sinara-hw/Urukul/README.md

# Urukul

4 channel 1GS/s DDS (AD9910 or AD9912 variant).

## Design Files

Design files (schematics, PCB layouts, BOMs) can be found at [Urukul/Releases](https://github.com/sinara-hw/Urukul/releases).

## Wiki

More information can be found on the [wiki](https://github.com/sinara-hw/Urukul/wiki).
