sinara-hw/Urukul/(threads)

Thread 1 (2018-04-19):

SYSU error with internal clock

jbqubit, 2018-04-19:
I'm running the SYSU Kasli variant with EEMs TTL and Urukul. Running gateware and firmware version d0f6123f. Relying on internal Kasli internal clock I get an error.

```
device_db = {
    "core": {
        "type": "local",
        "module": "artiq.coredevice.core",
        "class": "Core",
        "arguments": {
            "host": core_addr,
            "ref_period": 1e-9
            #,"external_clock": True
            # ,"ref_multiplier": 4
        }
    },
...
    urukul0_cpld={
        "type": "local",
        "module": "artiq.coredevice.urukul",
        "class": "CPLD",
        "arguments": {
            "spi_device": "spi_urukul0",
            "io_update_device": "ttl_urukul0_io_update"
            ,"refclk": 125e6
            ,"clk_sel": 0
        }
    }
```

```
$ artiq_run repository/demo.py
/home/britton/miniconda3/envs/artiq-dev/lib/python3.5/site-packages/h5py/__init__.py:36: FutureWarning: Conversion of the second argument of issubdtype from `float` to `np.floating` is deprecated. In future, it will be treated as `np.float64 == np.dtype(float).type`.
  from ._conv import register_converters as _register_converters
Traceback (most recent call last):
  File "/home/britton/artiq-dev/artiq/artiq/master/worker_db.py", line 159, in get
    dev = _create_device(desc, self)
  File "/home/britton/artiq-dev/artiq/artiq/master/worker_db.py", line 97, in _create_device
    return device_class(device_mgr, **desc.get("arguments", {}))
  File "/home/britton/artiq-dev/artiq/artiq/coredevice/ad9910.py", line 69, in __init__
    assert sysclk <= 1e9
AssertionError

The above exception was the direct cause of the following exception:

Traceback (most recent call last):
  File "/home/britton/miniconda3/envs/artiq-dev/bin/artiq_run", line 11, in <module>
    load_entry_point('artiq', 'console_scripts', 'artiq_run')()
  File "/home/britton/artiq-dev/artiq/artiq/frontend/artiq_run.py", line 219, in main
    return run(with_file=True)
  File "/home/britton/artiq-dev/artiq/artiq/frontend/artiq_run.py", line 205, in run
    raise exn
  File "/home/britton/artiq-dev/artiq/artiq/frontend/artiq_run.py", line 196, in run
    exp_inst = _build_experiment(device_mgr, dataset_mgr, args)
  File "/home/britton/artiq-dev/artiq/artiq/frontend/artiq_run.py", line 182, in _build_experiment
    return get_experiment(module, args.experiment)(managers)
  File "/home/britton/artiq-dev/artiq/artiq/language/environment.py", line 216, in __init__
    self.build(*args, **kwargs)
  File "repository/demo.py", line 8, in build
    self.urukul0s = [self.get_device("urukul0_ch"+str(i)) for i in range(4)]
  File "repository/demo.py", line 8, in <listcomp>
    self.urukul0s = [self.get_device("urukul0_ch"+str(i)) for i in range(4)]
  File "/home/britton/artiq-dev/artiq/artiq/language/environment.py", line 276, in get_device
    return self.__device_mgr.get(key)
  File "/home/britton/artiq-dev/artiq/artiq/master/worker_db.py", line 162, in get
    .format(name)) from e
artiq.master.worker_db.DeviceError: Failed to create device 'urukul0_ch0'
```

jbqubit, 2018-04-19:
```
from artiq.experiment import *

class UrukulTest(EnvExperiment):
    def build(self):
        self.setattr_device("core")
        self.setattr_device("urukul0_cpld")
        self.urukul0s = [self.get_device("urukul0_ch"+str(i)) for i in range(4)]
        self.ttl = self.get_device("ttl0")

    @kernel
    def run(self):
        f = 3.0*MHz
        dt = 2*us

        self.core.reset()
        self.ttl.output()
        delay(1*ms)

        for j in range(4):
            self.urukul0s[j].init()

        while True:
            with parallel:
                self.urukul0s[0].set(f, 0., 1.)
                self.urukul0s[1].set(f, 0., 1.)
                self.ttl.pulse(dt)
                self.urukul0s[0].sw.pulse(dt)
                self.urukul0s[1].sw.pulse(dt)

                # for j in range(4):
                #     self.urukul0s[j].sw.pulse(2*us)
            delay(1*ms)
```

hartytp, 2018-07-30:
@jbqubit AFAICT, this is an ARTIQ issue, not a HW issue.

Closed 2018-07-30.

Thread 2 (2018-06-08):

Remove AD9914 variant

marmeladapk, 2018-06-08:
AD9914 seems to not be considered anymore (https://github.com/sinara-hw/sinara/issues/195#issuecomment-304321715) and is not present in the schematics.

gkasprow, 2018-06-08:
done

Closed 2018-06-08.

Thread 3 (2018-06-13):

Urukul v1.0 detailed testing

marmeladapk, 2018-06-13:
_From @hartytp on [2017-11-07 20:29](https://github.com/sinara-hw/sinara/issues/354)_

- [x] Channel-to-channel cross-talk: adjacent channels, with agressor, victim switches opened and switches closed and with attenuators at max/min
- [x] Output phase noise/amplitude noise (0.1 Hz - 10 MHz)
- [x] OIP3, OIP2 vs frequency for min attenuator setting and medium/large amplitude (ASF)
- [x] RF switch settling behavior for on edge at max power (worst case)
- [x] Attenuator glitches
- [x] Nyquist attenuation, clock leakage
- [ ] RF switch settling behavior for off edge at max power (worst case)
- [ ] RF switch phase chirp
- [ ] Temperature coefficient of power and phase
- [ ] Are we happy running the IC11 and running the LVDS interface directly from the 3V6 rail? (Try this and check performance)
- [ ] Check performance of clock buffers when running in LVDS mode from the 1V8A rail
- [x] Optimize PLL loop filters (@weidazhang can you do this for the AD9910 boards, please?)
- [ ] Board-to-board crosstalk (in proximity to Kasli, DIO pulsing 5 V into 50 R, Urukul)

Use some fixed reference frequency for all tests, such as 80MHz.

marmeladapk, 2018-06-13:
_From @hartytp on [2017-11-07 20:30](https://github.com/sinara-hw/sinara/issues/354#issuecomment-342612378)_

@gkasprow Can you ship us all but 1 of the AD9910 Urukul prototypes you've ordered as soon as basic functionality/"no smoke" testing is complete (i.e. don't complete the above detailed testing first!).

Thanks!

marmeladapk, 2018-06-13:
_From @hartytp on [2017-11-07 20:30](https://github.com/sinara-hw/sinara/issues/354#issuecomment-342612519)_

@gkasprow @jordens Feel free to add more tests to the above list.

marmeladapk, 2018-06-13:
_From @hartytp on [2017-11-08 03:32](https://github.com/sinara-hw/sinara/issues/354#issuecomment-342700395)_

@gkasprow When you ship the AD9910 DDSs that we paid for, please can you ship one to @jordens?

marmeladapk, 2018-06-13:
_From @jordens on [2017-11-08 08:47](https://github.com/sinara-hw/sinara/issues/354#issuecomment-342750073)_

Updated it a bit. Please ship right after smoke test:

- [ ] power supplies good
- [ ] clock fanout fans out
- [ ] dds pll locks
- [ ] dds outputs frequency
- [ ] attenuators can be set
- [ ] rf switches work

We'll be happy to help with characterization afterwards.

marmeladapk, 2018-06-13:
_From @hartytp on [2017-11-12 18:22](https://github.com/sinara-hw/sinara/issues/354#issuecomment-343756425)_

@gkasprow Is Urukul due to arrive this week? When it arrives, please can we prioritise no smoke/basic functionality testing (see reobert's list) above finishing Zotino -- I'd like to get Urukul prototypes shipped asap. No need to do the detailed testing for now.

Thanks!

marmeladapk, 2018-06-13:
_From @gkasprow on [2017-11-12 18:26](https://github.com/sinara-hw/sinara/issues/354#issuecomment-343756709)_

@hartytp OK, 2 Zotinos + BNC adapters were shipped on Friday. Once I receive DDS, I will test them ASAP.

marmeladapk, 2018-06-13:
_From @hartytp on [2017-11-12 18:27](https://github.com/sinara-hw/sinara/issues/354#issuecomment-343756742)_

Thanks!

marmeladapk, 2018-06-13:
_From @gkasprow on [2017-11-12 18:32](https://github.com/sinara-hw/sinara/issues/354#issuecomment-343757125)_

@hartytp There are no panels for DAC BNC adapters attached - I forgotten about them. Will ship them next time with some other stuff.

marmeladapk, 2018-06-13:
_From @hartytp on [2017-11-12 18:43](https://github.com/sinara-hw/sinara/issues/354#issuecomment-343757823)_

@gkasprow No problem. That can wait.

If there is any time before Urukul arrives, it'd be great to get a few of the analog test for Zotino done.

marmeladapk, 2018-06-13:
_From @gkasprow on [2017-11-12 19:04](https://github.com/sinara-hw/sinara/issues/354#issuecomment-343759155)_

@hartytp Sure, once I repair my bard, will continue with measurements.

marmeladapk, 2018-06-13:
_From @hartytp on [2017-11-12 19:23](https://github.com/sinara-hw/sinara/issues/354#issuecomment-343760366)_

Great, thanks @gkasprow!

marmeladapk, 2018-06-13:
_From @jordens on [2017-11-19 16:38](https://github.com/sinara-hw/sinara/issues/354#issuecomment-345530298)_

@hartytp could you remember to do a bit of triage on the issues you file (i.e. assignee, labels, milestone)?

marmeladapk, 2018-06-13:
_From @hartytp on [2017-11-19 18:48](https://github.com/sinara-hw/sinara/issues/354#issuecomment-345539884)_

sure

marmeladapk, 2018-06-13:
_From @hartytp on [2017-11-20 18:55](https://github.com/sinara-hw/sinara/issues/354#issuecomment-345792391)_

@gkasprow For the current source biasing, my inclination is to go for Daniel's suggestion of the LT3092. They're pretty cheap ($2 in quantity) and seem like a better/easier solution than building our own current source.

@jordens @gkasprow if you're oaky with this approach, then we should buy an eval board at some point and test this out with the v1.0 boards we have. I'm happy to do this testing if that helps -- I probably won't do this until after Christmas, but I don't think we're in a rush for it.

marmeladapk, 2018-06-13:
_From @hartytp on [2017-12-11 18:26](https://github.com/sinara-hw/sinara/issues/354#issuecomment-350813087)_

Cool.

Out of curiosity, do you have a proper phase noise/amplitude noise meter? Or, will you just stick this on a spectrum analyser?

marmeladapk, 2018-06-13:
_From @jordens on [2017-12-11 19:16](https://github.com/sinara-hw/sinara/issues/354#issuecomment-350827749)_

We have proper tools.

@gkasprow how are the AD9912 variant boards?

marmeladapk, 2018-06-13:
_From @gkasprow on [2017-12-11 21:11](https://github.com/sinara-hw/sinara/issues/354#issuecomment-350859436)_

@jordens I have them all in my lab but was busy with Sayma Ethernet debugging. You can follow my fight [here](https://github.com/m-labs/artiq/issues/854)

marmeladapk, 2018-06-13:
_From @gkasprow on [2017-12-11 21:12](https://github.com/sinara-hw/sinara/issues/354#issuecomment-350859672)_

So the next thing is 9912 testing.

marmeladapk, 2018-06-13:
_From @jordens on [2017-12-11 22:32](https://github.com/sinara-hw/sinara/issues/354#issuecomment-350880532)_

I am following that and involved.
Thanks for the AD9912 update. Once you have smoke-tested them like the AD9910 stuff, you can send two of them to me.

marmeladapk, 2018-06-13:
_From @a-shafir on [2017-12-11 22:45](https://github.com/sinara-hw/sinara/issues/354#issuecomment-350883486)_

@gkasprow what was actually flashed into the CPLD on the 9910 board we have in Berlin?

I see 2 options
https://github.com/m-labs/sinara/tree/master/ARTIQ_ALTIUM/EEMs/Urukul/CPLD_code
or
https://github.com/quartiq/urukul

I am testing h/w but can't generate any output on the IO_SESET (P129) and some pins around.

marmeladapk, 2018-06-13:
_From @a-shafir on [2017-12-11 23:02](https://github.com/sinara-hw/sinara/issues/354#issuecomment-350887345)_

@gkasprow how you tested 3U DDS 9910?
Have you got DDS ic working?
Do you have the code that sent the spi commands, what actually sent to DDS/atten etc?

marmeladapk, 2018-06-13:
_From @gkasprow on [2017-12-11 23:02](https://github.com/sinara-hw/sinara/issues/354#issuecomment-350887492)_

@a-shafir I burned Roberts Verilog code. The only change I did was assignment of test points. Now we have:
```
assign tp = (cfg_data_rst | ((~en_9910) & tstriple7_i));
assign tp_1 = dds_cs_n;
assign tp_2 = dds_sck;
assign tp_3 = dds_sdi;
assign tp_4 = dds_io_update;

```

marmeladapk, 2018-06-13:
_From @gkasprow on [2017-12-11 23:05](https://github.com/sinara-hw/sinara/issues/354#issuecomment-350888034)_

I connected 9910 devkit via DIO-Tester module to make sure that Robert's code works. In this way I could communicate with it using LVTTL signals

marmeladapk, 2018-06-13:
_From @gkasprow on [2017-12-11 23:06](https://github.com/sinara-hw/sinara/issues/354#issuecomment-350888356)_

I also modified the verilog code so all 4 channels were active simultaneously. In this way I tested if PLLs are locked. Here is the code:
[Urukul_CPLD_all_ch.zip](https://github.com/m-labs/sinara/files/1549674/Urukul_CPLD_all_ch.zip)

marmeladapk, 2018-06-13:
_From @gkasprow on [2017-12-11 23:08](https://github.com/sinara-hw/sinara/issues/354#issuecomment-350888731)_

To do general purpose communication over SPI I use little Artix 7 devkit with USB and FORTH processor that translates UART commands to bit-bang protocol, i.e. SPI. It works really fast but it's written in FORTH, so probably not really useful for you :)

marmeladapk, 2018-06-13:
_From @a-shafir on [2017-12-11 23:13](https://github.com/sinara-hw/sinara/issues/354#issuecomment-350889724)_

@gkasprow i see io_reset commented in the code. probably some other changes.
Please also attach the pin assignment for the code.
So what was generating the DDS SPI command? 9910 devkit? I have no devkit.
Can you generate a dump (sequence) of the commands?
Also what about the reading from DDS when all in parallel?

marmeladapk, 2018-06-13:
_From @a-shafir on [2017-12-11 23:15](https://github.com/sinara-hw/sinara/issues/354#issuecomment-350890259)_

@gkasprow i see why in_sel not working to - it commented out
Good that i got this data from you )

marmeladapk, 2018-06-13:
_From @gkasprow on [2017-12-11 23:19](https://github.com/sinara-hw/sinara/issues/354#issuecomment-350890994)_

The original DDS was working in parallel. So I didn't read the status from externally connected ones.
You can compare this code with one @jordens posted. I did not touch the pins assignment.
My CPLD project is [here](https://www.dropbox.com/sh/qj16dhavo4qxsw9/AAB5paEl0olZpSaRMjhjxSyOa?dl=0)

marmeladapk, 2018-06-13:
_From @gkasprow on [2017-12-11 23:21](https://github.com/sinara-hw/sinara/issues/354#issuecomment-350891401)_

This is how typical setup with devkit looks like. I this case I connected Sampler module, but the idea is same.
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

marmeladapk, 2018-06-13:
_From @gkasprow on [2017-12-11 23:24](https://github.com/sinara-hw/sinara/issues/354#issuecomment-350892153)_

this is the FORTH code I use to talk to LV595 registers.
The FORTH ascii is executed in FPGA and is toggling IOs routed to an IO register with a few MHz rate. CPU runs with 50MHz clock.
The function below writes 16 bits via SPI to the register and reads them back.

````
: spi_LV595 ( a )

	1 OUT0_SET_REG io! \ SCK hi
	1 16 lshift OUT0_SET_REG io! \ OE buff active
	1 2 lshift OUT0_CLR_REG io! \ RCLK low

    16 0 do
        dup
        1 15 lshift and
        if
           1 1 lshift OUT0_SET_REG io!
        else
           1 1 lshift OUT0_CLR_REG io!
        then
		1 OUT0_CLR_REG io! \ SCK low
		2*
		INP0_REG io@ 4 rshift 1 and +
        1 OUT0_SET_REG io! \ SCK hi
    loop

	 1 2 lshift OUT0_SET_REG io! \ RCLK high
	 1 2 lshift OUT0_CLR_REG io! \ RCLK low
	 1 16 lshift OUT0_CLR_REG io! \ OE buff inactive
	 $ffffff and  \ return only valid bits
;

````

marmeladapk, 2018-06-13:
_From @gkasprow on [2017-12-11 23:32](https://github.com/sinara-hw/sinara/issues/354#issuecomment-350893612)_

@a-shafir you are right - I had to modify the reset pin state to make it working.

marmeladapk, 2018-06-13:
_From @gkasprow on [2017-12-11 23:34](https://github.com/sinara-hw/sinara/issues/354#issuecomment-350894149)_

And the code you have burned in your CPLD is in Urukul_CPLD_1ch.v file

marmeladapk, 2018-06-13:
_From @gkasprow on [2017-12-12 16:51](https://github.com/sinara-hw/sinara/issues/354#issuecomment-351112532)_

@jordens here is your 9912 :)
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

marmeladapk, 2018-06-13:
_From @jordens on [2017-12-12 16:56](https://github.com/sinara-hw/sinara/issues/354#issuecomment-351114267)_

@gkasprow Nice! Other than the missing amplifier, are there any other issues? Is the solder on the underside bad as well?

marmeladapk, 2018-06-13:
_From @hartytp on [2017-12-12 16:59](https://github.com/sinara-hw/sinara/issues/354#issuecomment-351115163)_

Nice!

marmeladapk, 2018-06-13:
_From @gkasprow on [2017-12-12 17:03](https://github.com/sinara-hw/sinara/issues/354#issuecomment-351116459)_

I got this amp separately. The PN is wrong so they got ones with straight leads and had to replace them.
It seems that the ICs they got had problems with wetting because other chips are fine. Anyway, it's their responsibility to solder it right

marmeladapk, 2018-06-13:
_From @jordens on [2017-12-12 17:15](https://github.com/sinara-hw/sinara/issues/354#issuecomment-351120206)_

Are you returning the AD9912 boards to Technosystem to be fixed as well?

marmeladapk, 2018-06-13:
_From @gkasprow on [2017-12-12 18:06](https://github.com/sinara-hw/sinara/issues/354#issuecomment-351135089)_

I will fix one piece myself to test it. Rest of the boards will be returned. I talked with the company and they say that it is quite standard thing that some chips have poor wetting and side contacts are not always covered by the tin. The flux that is part of the soldering paste is only roughly 10..15% of it and is not always able to clean the contact side. The joint still maintains the contact because it is low side of it which does the job. Side area does not need to be covered, but if we want, they can fix it.

marmeladapk, 2018-06-13:
_From @jordens on [2017-12-13 08:47](https://github.com/sinara-hw/sinara/issues/354#issuecomment-351323416)_

IMHO it is likely that the joints are bad on the underside as well if they fail to wet that dramatically on the edge. And since they probably didn't inspect those joints there is no telling. I'd like to see them fix it.

marmeladapk, 2018-06-13:
_From @gkasprow on [2017-12-13 09:09](https://github.com/sinara-hw/sinara/issues/354#issuecomment-351328847)_

I just desoldered the chip and the bottom pads are correctly soldered. Anyway it just looks non professional and should be fixed.

marmeladapk, 2018-06-13:
_From @a-shafir on [2017-12-13 10:42](https://github.com/sinara-hw/sinara/issues/354#issuecomment-351353248)_

This is a long known for the technologists that too much solder is not helping and even can cover some problem. But in this case it is not about the professionalism but about Optical inspection standards. All the packages designed that way that there is possibility to ensure by inspection the proper electrically and mechanically soldering. For this package there must be wetting on the side edges of the pads. This indicates that there is wetting under the pads and also improves mechanical properties.

For some of the packages we have (BGA and some of the qfn with signal pads under) the OIS will not enough. I think need to check if the factory can do x-ray inspection, they must have it in or out house at least for BGA but also for some regulator chips etc. Visual inspection of the QFN etc is the must. It shall not increase the cost of the samples production more than few %

Any way investing our time to solving the technological issues is the worst case scenario.

marmeladapk, 2018-06-13:
_From @a-shafir on [2017-12-13 12:50](https://github.com/sinara-hw/sinara/issues/354#issuecomment-351381968)_

Urukul 9910, 4th channel, 10.000MHz, variable attenuation test, no termination:
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

marmeladapk, 2018-06-13:
_From @gkasprow on [2017-12-13 13:29](https://github.com/sinara-hw/sinara/issues/354#issuecomment-351391245)_

@a-shafir look [here](https://github.com/m-labs/sinara/issues/377#issuecomment-351379129)

marmeladapk, 2018-06-13:
_From @a-shafir on [2017-12-13 13:40](https://github.com/sinara-hw/sinara/issues/354#issuecomment-351393954)_

@gkasprow ok, this is a news for me too. There are 3 similar looking "QFN-style" packages:
- one have sides plated to be good for wetting (some crystals for instance and old stile QFN)
- some have a etch/step around to have the wetting visible for OIS
- the newest are basicly BGA-like i.e. all wetting is under the package but just no balls.

That minds for us:
- Even we don't have a BGA on a board we need to inspect the packages to ensure they are good for optical inspection (OIS) and if any one of them is needed we must add X-ray inspection into the production list.
- Need to chose the parts for the boards more careful. If the board normally (most of the parts) does not needs X-ray try to avoid any packages that have no OIS compatible pads (like LTM4622 etc)
- It is good to put this as a part of the h/w and production specs checklist.

marmeladapk, 2018-06-13:
_From @a-shafir on [2017-12-18 00:41](https://github.com/sinara-hw/sinara/issues/354#issuecomment-352299689)_

Gateware, core drivers and experiment for Urukul AD9910 rev 1.0 board.

The current setup is for KC705, see the details here:
https://github.com/m-labs/artiq/commit/dd3c8a336dc12cda33cadebdf3bafc77c0bc1565

The experiment initializes FMC DIO, the Urukul board and configures the single tone for all 4 channels.
Attenuator and SW are supported.

There are 2 "interference generator loops" (for DDS3 SPI and for ATT SPI). Each can be activated in the experiment. Note: with the current RTIO gateware it is not possible to generate the NU-mode intensive SPI communication so if any interference from the SPI clock will be seen on the output it will be not the worst case scenario.

The 4-channels DDS output:
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

The setup:
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

marmeladapk, 2018-06-13:
_From @jordens on [2017-12-18 17:40](https://github.com/sinara-hw/sinara/issues/354#issuecomment-352500086)_

* RF Switch rise time is roughly 100ns to 95%
* Spectrum looks ok. A few weird close in Spurs (+- 1.2 kHz and 11kHz at -70dBc) potentially related to grounding to be debugged. They are big when the board is on the antistatic bag on an optical table and otherwise disappear.

More data and screenshots to follow.

marmeladapk, 2018-06-13:
_From @dhslichter on [2017-12-18 18:53](https://github.com/sinara-hw/sinara/issues/354#issuecomment-352523350)_

@a-shafir why are you using scope probes to look at the DDS outputs instead of SMA cables?

marmeladapk, 2018-06-13:
_From @gkasprow on [2017-12-18 19:01](https://github.com/sinara-hw/sinara/issues/354#issuecomment-352525555)_

@jordens in such setup you easily receive and induce current from every short wave radio station including CB :)

marmeladapk, 2018-06-13:
_From @jordens on [2017-12-18 19:57](https://github.com/sinara-hw/sinara/issues/354#issuecomment-352540600)_

@gkasprow in general yes, but not if you are in a room that is as insanely shielded as the one we are doing the tests in ;)

marmeladapk, 2018-06-13:
_From @a-shafir on [2017-12-19 11:24](https://github.com/sinara-hw/sinara/issues/354#issuecomment-352720977)_

@dhslichter there was only one more SMA cable in the lab and no 50R terminators at all. Any way the probes are OK to check how the driver controls.

marmeladapk, 2018-06-13:
_From @jordens on [2017-12-19 19:17](https://github.com/sinara-hw/sinara/issues/354#issuecomment-352859041)_

The screenshots are crappy.
tl;dr: All good. The only issue are phase noise spurs at -75dBc at ~1.2 kHz offset with many harmonics, especially x11. We didn't figure out where exactly they came from. The spur offset is surprisingly low. Their offset is temperautre dependent (increases with temperature). And coupling different parts of the PCB (by finger), especially around the underside near the clock fanout, makes them worse. That spur needs to be debugged.

## Setup

* Urukul v1.0 (with BIAS and resistor patches)
* urukul-cpld v1.0rc6
* very clean 100 MHz reference, 10 dBm, un-un, into SMA, selected
* divide-by-4 from clock fanout
* PLL locked, multiplier 40, 387µA, VCO5, 1 GHz VCO
* CFR1=0x00000002, CFR2=0x01400820
* output frequency 80 MHz (0x147ae148) or 81 MHz (0x14bc6a7f) unless otherwise noted
* un-un on output
* using channel 1 unless otherwise noted
* 12 V lab power supply or random 12V 6A brick: no difference

## low frequency limit

* 100 kHz out: -20 dBm max (attenuator at 63 digital, switch open)
* 1 MHz out: 10 dBm

## switch isolation

* 70 dB (attenuator at 63 digital)

## crosstalk

* -84 dB (victim attenuator at 63, switch open, DDS off, aggressor switch open, attenuator at 63)
* -110 dB (same as above but victim switch closed)

## cross-channel intermodulation

* -85 dBc (agggressor 1 MHz, 10 dBm, victim 80.2 MHz, IMD product at 81.2 MHz)
* -90 dBc (agggressor 1.234 MHz, 10 dBm, victim 80.123 MHz, IMD product at 81.357 MHz)
* <-100 dBc (agggressor 80.123 MHz, 10 dBm, victim 81.234 MHz, IMD product at 82.345 MHz)

##  Attenuator step from 20 to 60 digital (16+4dB switch glitch)
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

## Attenuator step from 31 to 32 digital (major carry glitch)
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

## Harmonics DC to 1 GHz, clock and ref leakage below RBW
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

## Harmonics 2 and 3 vs power

6dBm outputs, 3rd harmonic at -53dB
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

10dBm outputs, 3rd harmonic at -25dB
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

## Close in spurs (1.2 kHz multiples, especially 11x)

* increase and change the harmonics distribution when touching the underside of the PCB near the clock fanout
* increase when pushing the underside into the antistatic bag (and thereby coupling parts of the underside)
* increase in frequency with increasing temperature
* no power rail or testpoint found where whey originate
* power supply does not make a difference
* shielding by covering with a massive Aluminum case does not change them
* adding more un-uns does not change them
* cable routing does not affect them
* distance to kc705 does not affect them

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

## PLL bump and 1 MHz spurs

* spurs at 1 MHz and multiples from the SMPS at -85 dBc on the same level as the specified spurs of the DDS.

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

## Phase noise 100 mHz to 10MHz
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

## Phase noise 10 Hz to 10 MHz
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

## Phase noise 1 kHz to 1MHz
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

## RF switch turn on transient
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

## Nyquist rejection 400 MHz to 600 MHz
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

## Nyquist rejection 450 MHz to 550 MHz
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

marmeladapk, 2018-06-13:
_From @gkasprow on [2017-12-19 19:39](https://github.com/sinara-hw/sinara/issues/354#issuecomment-352864722)_

@jordens such spur may be caused by PSU instability. Then 1.2kHz ripples caused by SMPS or LDO feedback loop may cause such spurs.
So you can have a look with scope on critical power rails.

marmeladapk, 2018-06-13:
_From @jordens on [2017-12-19 19:59](https://github.com/sinara-hw/sinara/issues/354#issuecomment-352869655)_

Ack. We didn't find anything noticable on the rails. We'll do more prodding and poking.

marmeladapk, 2018-06-13:
_From @gkasprow on [2017-12-19 20:11](https://github.com/sinara-hw/sinara/issues/354#issuecomment-352872838)_

@jordens I can have a look with spectrum analyzer or when necessary with SSA. Is ADI devkit sufficient to recreate this spur?

marmeladapk, 2018-06-13:
_From @jordens on [2017-12-19 21:09](https://github.com/sinara-hw/sinara/issues/354#issuecomment-352886893)_

I don't know. But I'd be surprised if you see them on the devkit.
I'll give you details about the setup later.

marmeladapk, 2018-06-13:
_From @gkasprow on [2017-12-19 21:11](https://github.com/sinara-hw/sinara/issues/354#issuecomment-352887718)_

No, I mean Urukul controlled by ADI devkit instead of the Artiq

marmeladapk, 2018-06-13:
_From @jordens on [2017-12-20 10:06](https://github.com/sinara-hw/sinara/issues/354#issuecomment-353020765)_

I think you should see them on Urukul with your setup. I added the description of the setup to the post above.

marmeladapk, 2018-06-13:
_From @a-shafir on [2017-12-20 13:06](https://github.com/sinara-hw/sinara/issues/354#issuecomment-353058269)_

@jordens what reference clock used for the test? KC705 output from the FPGA pll possible has the low freq modulation from the power or even fan. And the AD9910 pll most likely will unable to clean it.

marmeladapk, 2018-06-13:
_From @jordens on [2017-12-20 15:49](https://github.com/sinara-hw/sinara/issues/354#issuecomment-353100109)_

@a-shafir the reference is clean. And that hypothesis is already excluded be the other observations.

marmeladapk, 2018-06-13:
_From @jordens on [2018-01-02 19:00](https://github.com/sinara-hw/sinara/issues/354#issuecomment-354847897)_

AD9912 variant also works fine (https://github.com/m-labs/artiq/commit/a940550e4755f92c96408acfd560099e2e2ee3ed)
@gkasprow did you get a chance to hunt for the 1.2 kHz spurs?

marmeladapk, 2018-06-13:
_From @gkasprow on [2018-01-02 20:15](https://github.com/sinara-hw/sinara/issues/354#issuecomment-354864560)_

@jordens not yet. The University and my lab was closed during Xmass. I could not even cross the main gate. They open tomorrow.

marmeladapk, 2018-06-13:
_From @jordens on [2018-01-02 21:51](https://github.com/sinara-hw/sinara/issues/354#issuecomment-354884622)_

Ack. That's fine!

marmeladapk, 2018-06-13:
_From @jordens on [2018-01-03 13:38](https://github.com/sinara-hw/sinara/issues/354#issuecomment-355013440)_

The spur might be a beat due to the on board oscillator leaking through the mux (-61 dB isolation, 25 ppm spec, 1.2 kHz is 12 ppm). But the magnitude is still high: the capacitor population should have created much more isolation. The symptoms are otherwise fitting (maybe not the harmonics, though). @gkasprow if you get to testing this before I do, try with and without L9.

marmeladapk, 2018-06-13:
_From @hartytp on [2018-01-07 14:34](https://github.com/sinara-hw/sinara/issues/354#issuecomment-355826817)_

@jordens Based on those measurements are you happy to scrap the screening clips for the next revision? We could also DNP them, but scrapping them frees up quite a bit of space (and, anyway, AFAICT, there wasn't enough space on Urukul to do the screening properly anyway, so the current arrangement is a bit of a bodge!). Or, do you want to take measurements with the screening in place first to see if it actually makes a difference?

marmeladapk, 2018-06-13:
_From @jordens on [2018-01-07 14:48](https://github.com/sinara-hw/sinara/issues/354#issuecomment-355827638)_

Why would you remove the clips now? The pending changes certainly don't need the additional space. And yes, I'd like to test and quantify the crosstalk in a rack with Urukul in proximity to other Urukuls, Kaslis, or DIOs pulsing 5 V into 50 Ohm.

marmeladapk, 2018-06-13:
_From @hartytp on [2018-01-07 14:53](https://github.com/sinara-hw/sinara/issues/354#issuecomment-355827944)_

> Why would you remove the clips now?

No hurry for this, just came up now because I was reviewing my to do list for these boards.

My guess is that most of the screening we've added to the EEMs is unnecessary and can be removed at some point once we've finished testing, but there is no rush for that.

marmeladapk, 2018-06-13:
_From @gkasprow on [2018-01-09 21:50](https://github.com/sinara-hw/sinara/issues/354#issuecomment-356425538)_

@jordens tomorrow I plan to spend full day  on this issue.

marmeladapk, 2018-06-13:
_From @gkasprow on [2018-01-10 13:19](https://github.com/sinara-hw/sinara/issues/354#issuecomment-356599957)_

@jordens I got such spectra on my setup
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

marmeladapk, 2018-06-13:
_From @jordens on [2018-01-10 13:30](https://github.com/sinara-hw/sinara/issues/354#issuecomment-356602573)_

@gkasprow those are not the ones I am interested in. Look above for a description, photos and analysis of the ~kHz spurs.

marmeladapk, 2018-06-13:
_From @gkasprow on [2018-01-10 13:38](https://github.com/sinara-hw/sinara/issues/354#issuecomment-356604379)_

above there are mainly setup windows :)
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

marmeladapk, 2018-06-13:
_From @gkasprow on
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

Thread 5 (2018-07-30):

meta

hartytp, 2018-07-30:
Issues from sinara-hw/meta that could affect Urukul:
- https://github.com/sinara-hw/meta/issues/4 - mechanical issue. I'd also be happy just dropping the plastic washers on the default front panel now that the SMAs aren't floated by default
- https://github.com/sinara-hw/meta/issues/3
- https://github.com/sinara-hw/meta/issues/2
- https://github.com/sinara-hw/meta/issues/1

@gkasprow I think we should probably adopt the same FP grounding configuration for Sampler and at least add DNF resistors that can be used to tie the FP to circuit ground. Please can you confirm whether you think the new front panels will provide a solid grounding connection between the PCB and chassis ground (sorry if you've already said that elsewhere and I just missed it!).

gkasprow, 2018-07-30:
The new panels has special contact sprints that scratch the panel oxidization layer and touch the chassis rail. So providing that we use toothed lock washers, they will ensure contact with chassis. They also provide contact with neighbouring panel.

hartytp, 2018-07-30:
@jordens @sbourdeauducq in that case, here is what I propose. We'll get a batch of EEMs made with the new panels and the 0R resistors populated to short the panels to the circuit ground. We'll test them carefully to ensure that the ground contact between chassis and EEMs is solid and robust. We'll check them for EMI/ESD issues (we can also lend some to others for testing if that's helpful).

If that all looks good, then I suggest that we make the 0R resistors the default population option.

gkasprow, 2018-08-04:
changing to 0R then.
Added RC to front panel mounting holes.

gkasprow, 2018-08-04:
I swapped EEM connectors as well. It took a few hours of work but I believe it was worth the effort.

hartytp, 2018-08-04:
:+1: thanks for doing that. It's a lovely design

hartytp, 2018-08-06:
@gkasprow are you happy that https://github.com/sinara-hw/meta/issues/4, https://github.com/sinara-hw/meta/issues/3 and https://github.com/sinara-hw/meta/issues/2 are also fixed?

gkasprow, 2018-08-06:
yes

hartytp, 2018-08-06:
thanks!

Closed 2018-08-06.

Thread 6 (2018-07-30):

schematic broken

hartytp, 2018-07-30:
lots of text missing, please can you regenerate with the latest Altium? Thanks!

gkasprow, 2018-07-30:
fixed

hartytp, 2018-07-30:
ta

Closed 2018-07-30.

Thread 7 (2018-07-30):

L9

hartytp, 2018-07-30:
@gkasprow is L9 populated by default. IIRC, it's not, but that's not marked on the schematic.

hartytp, 2018-08-04:
Hmm..What am I missing? If the mmcx is used the XO is enabled isn't it? doesn't the XO still couple to the output via the removed capacitor. I thought that when the mmcx is used the XO must be powered down by removing the inductor.

klickverbot, 2018-08-04:
Yep, L9 shouldn't be populated if the MMCX coupling caps are. T1 only helps for switching to the external SMA in.

hartytp, 2018-08-04:
@gkasprow we definitely want the default population option to be mmcx not XO so no L9. I much prefer the mmcx to the sma for connecting to Kasli clocks

gkasprow, 2018-08-04:
OK, right.

hartytp, 2018-08-05:
@gkasprow Thinking about this a bit more, I think it would be much nicer if the XO were disabled by removing a 0R resistor on the power line instead of an inductor. My thinking is that the inductor is something that most people won't have lying around, so repopulating it requires ordering components. A 0R resistor can just be a solder blob.

Better yet, we could just add a jumper since it's only DC.

hartytp, 2018-08-05:
Having said that, the more I

gkasprow, 2018-08-05:
I'm not sure if such MOSFET switch will provide good isolation. Small signal MOSFET have >10Ohm resistance. Power MOSFETs has huge capacitance at 100MHz and non-negligible inductance.

What about simple mechanical jumper? It will work at 100MHz without issues.

We already measured that isolation of digital mux is not enough so that's why MSOFET in series with L9 was added.

We can also do the switch in [old-fashioned](http://www.analog.com/en/analog-dialogue/articles/driving-pin-diodes-with-op-amps.html) way using PIN diodes.  We can get 60dB isolation at 100MHz with such circuit. Cost of PIN diode is a few cents.

Relay is also an option but RF-grade relays are not cheap.

hartytp, 2018-08-05:
I'm not worried about isolation as we will also cut XO power when MMCX is active and warn users not to apply signal to MMCX when XO is powered. FETs are just to give low impedance to ground.

I think it's nice to have both the XO and MMCX as first class options w8th no population changes required
 Xo will be nice with humpback.

Unless @jordens vetos it can we just add a cheap lvds mux?

hartytp, 2018-08-05:
previous post edited for clarity...

gkasprow, 2018-08-05:
What about [this](https://www.silabs.com/documents/public/data-sheets/Si53307.pdf) mux?
It is low cost (1.5$) and has very low jitter (60fs).

hartytp, 2018-08-05:
Looks fine by me. It doesn't go up to 1GHz, but I'd argue that's not a problem for the MMCX input. So, put the MMCX and XO into that and then the output into the divider, with the SMA going into the other divider input. Route both clk select lines to the CPLD, and also ensure that the XO is only powered when it's selected.

That all works for me. @jordens any objections?

gkasprow, 2018-08-05:
XO power needs to be controlled separately - I'd like to keep it off when SMA is enabled.
Otherwise we would have to remember to switch the first mux to MMCX input when other is set to SMA mode.

hartytp, 2018-08-05:
Yes, I would and the two cs lines to enable to XO.

gkasprow, 2018-08-05:
Please have a look:
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

hartytp, 2018-08-06:
@gkasprow thanks for doing that.

What about Si53340-B-GM instead? That is a bit cheaper and goes up to >1GHz, so it can be used to supply the max DDS clock frequency via the MMCX. Partly, my motivation here is that if we use a slower buffer for the MMCX input then we will need to document it. If all buffers go to 1GHz then there is less to document.

hartytp, 2018-08-06:
Other comments:
- Is R22 marked as DNP? Shouldn't it be, as the balun is not populated?
- Should we also add a DNP 100R resistor for the MMCX input?
- For the CPLD, the configuration SR currently uses 21 bits. So, we assuming we keep it to 3 bytes, we still have 3 bits spare. So, we do have enough bits to make the clk in control line 2 bits wide. Don't need a separate control register bit for OSC EN, can determine its state in the CPLD from the two CLK select lines.

Otherwise, all looks good to me.
@jordens any objections to going ahead with this?

gkasprow, 2018-08-06:
OK, I have it in my libs.

gkasprow, 2018-08-06:
the schematic above was without assembly variants enabled. Below is correct one.
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

gkasprow, 2018-08-06:
R52 is mounted instead of R22 and gives 50Ohm impedance instead of 100Ohm which is needed for symmetrical output from balun.

gkasprow, 2018-08-06:
Here is version with improved readability
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

hartytp, 2018-08-06:
@gkasprow that all looks good to me. Just need to hear from @jordens now.

hartytp, 2018-08-06:
@gkasprow actually, one more thing: am I right in thinking that the XO maximum output current is +-24mA, which means that it needs a min load of 137.5 Ohms. Yet, we're loading it with 100Ohms.

Also, presumably we could use a passive network to convert HVCMOS to LVDS and get a differential signal out. I assume that the reason you haven't done this is simplicity (the XO puts out a square-wave AFAICT with a nice sharp rising edge, so signal level shouldn't be an issue). Is that correct? (I'm not asking for a change, just curious)...

gkasprow, 2018-08-06:
Yes, but passive network means balun. I don't think we need it, XO amplitude is high enough.
We can also add low cost differential CMC to convert it to diff signal. There is 9cm distance between XO and SIlabs chip.

gkasprow, 2018-08-06:
I mean [this](https://datasheet.lcsc.com/szlcsc/Murata-Electronics-DLW21SN121SQ2L_C86163.pdf) CMC

jordens, 2018-08-06:
Removing population options in favor of configurability is great as long as the side effects are OK.
A couple questions.
* What's the plan for implementing the code changes?
* What's the impact on power consumption? If the Si has significantly more consumption, I'd consider going back to the cheaper lvds buffer.
* What's the impact on cost? Some are going to say that it's just one BOM line but that doesn't really compute when looking at past changes.

hartytp, 2018-08-06:
> What's the plan for implementing the code changes?

I'm happy to implement, test and document CPLD + core device changes.

> What's the impact on power consumption? If the Si has significantly more consumption, I'd consider going back to the cheaper lvds buffer.

Si53307 would be 85mA typical (65mA core + 20mA for a single LVDS output).

Si53340 is specified as being 140mA "core current". However, I believe that's a bit misleading, since it doesn't have a separate "VDDO" pin, so I think this actually includes the output current draw as well at 20mA/output. In which case, the actual current draw with a single output would be 80mA, so the same.

hartytp, 2018-08-06:
Note also that the supply current is the same for the 53340/53341 (which is 200MHz LVDS) so doesn't seem to depend on the speed.

gkasprow, 2018-08-06:
We have to finish this revision today and start production. I finished layout with Si53340.

hartytp, 2018-08-06:
> the cheaper lvds buffer

which cheaper buffer do you mean? The slower one was actually a bit more expensive. Maybe because it has a flexible "any output" interface. The Si53340 is a cheaper LVDS-only buffer.

hartytp, 2018-08-06:
>  Yes, but passive network means balun. I don't think we need it, XO amplitude is high enough. We can also add low cost differential CMC to convert it to diff signal. There is 9cm distance between XO and SIlabs chip.

ACK. Not worth it. As I said, I was just curious.

But, we really should increase the value of the load resistance to make sure we keep the load current within the specified limits.

hartytp, 2018-08-06:
Sounds good to me. Thanks!

jordens, 2018-08-06:
OK. Sounds good to me. It looks like this can be implemented transparently w.r.t. the v1.0, v1.1, v1.2 versions in ARTIQ 4.0. I'm also ok with putting OSC_EN on a dedicated CPLD pin. Maybe the same power switching for the MMCX/XO mux.

gkasprow, 2018-08-06:
Power consumption will change from 9.95 to 10.26W for AD9912

gkasprow, 2018-08-06:
I increased the load resistance to 100Ohm

hartytp, 2018-08-06:
You mean 100R + 50R=150R total?

gkasprow, 2018-08-06:
yes

jordens, 2018-09-06:
To answer my question: the impact on cost is 40-50€. That's much more than I expected and suggests that reducing complexity and the BOM (drop amplifiers+chokes, filters, MMCX, MUX, clips, DIP switch) might really make Urukul quite a bit cheaper.

hartytp, 2018-09-06:
> To answer my question: the impact on cost is 40-50€.

Wow! Where did you get that number from? That's much higher than I'd expected. @gkasprow can that really be right?

hartytp, 2018-09-06:
@jordens even if that's true, my guess is that this cost will still be dwarfed by costs associated with production size. So, even if some of these components make the board more expensive, if they allow more users to use the exact same board they may still lead to lower overall costs.

jordens, 2018-09-06:
Technosystem. I asked because I suspected that Urukul would become more expensive.

jordens, 2018-09-06:
@hartytp where do you get you numbers on production cost scaling from? From what I have seen it's steps of ~5%/10pcs. If somebody buys 40 RF channels, that's roughly the cost of these changes eating up the savings due to scaling.

hartytp, 2018-09-06:
>Technosystem. I asked because I suspected that Urukul would become more expensive.

@gkasprow any idea why this cost is so high?

> @ where do you get you numbers on production cost scaling from? From what I have seen it's steps of ~5%/10pcs.

From previous conversations with TechnoSystems the scaling factors for going from 1-2 boards to 10-20 have been significantly more than 5%. Notice that there are two different kinds of discount: (1) they are building a large batch already and one is negotiating what fraction of that to buy (but, still a fraction that's small compared with the overall batch size) (2) one is buying the entire batch. Obviously the price scaling is way more for the second case than the first.

Anyway, obviously you should order whatever variants you want to. But, FWIW, there are several things on the list you posted above that I do feel add significant value and would want to keep (filter, amplifier, MMCX, mux) for any boards we buy. At this point I also have no appetite for further rounds of design revisions + testing.

jordens, 2018-09-06:
That doesn't agree with what I have seen in practice and with what I have been told. I haven't seen more than 5% up to qtys of 16. Yes, I know how these things are priced and manufactured.
I'd definitely recommend that those buying a bunch of Urukuls take a good look at the options and the cost. Unused components have exactly zero value.
IIRC you mentioned lowering the output power to match the gain from Booster and to get rid of attenuator banks.
The AA filter is useless if you are driving AOMs and are not bothered by harmonics or Nyquist images.
The mux is useless where there will be no clock reference clock switching. And the MMCX is useless in two of three use cases.

hartytp, 2018-09-06:
Anyway, if you want different population options then go for it.

My point is just that I think the current design is pretty close to optimal and I wouldn't want to buy a different version with those features removed.

gkasprow, 2018-09-06:
It looks like Technosystem has batch of v1.2 produced and patially assembled (one PCB side). If you order v1.3, they will do it in low quantity so that's why such batch will be more expensive. Nothing to do with board revision.

hartytp, 2018-09-07:
@jordens Remind me, why do you dislike the MMC connectors so much?
- Almost all of our Kaslis connect to at least one EEM that requires a clock. Currently, this is just Urukul, but should soon extend to Mirny and Stamper
- The MMCXs seem to be the cheapest and cleanest way of doing this clock distribution. There are plenty of EU suppliers who will make up MMCX cables to custom lengths cheaply, so we just bought a stack of them. They are mechanically quite nice to use and work into the GHz range, so can transmit nice clean clock edges without SI issues.
- I've never found it particularly difficult to route the MMCX connectors inside the rack alongside the ribbon cables. And, I definitely prefer this to external cabling
- The fanout on Kasli seems much cheaper and more convenient than any other solution. If you're not using that then what are you doing to distribute your clocks? Use an external board like clocker and SMAs? That costs more, takes up more space, consumes more power and leads to more external wiring
- The Kasli recovered clock is pretty good (and good enough for all our current EEM applications); the short-term stability/phase noise is excellent, and even the long-term stability of 100ps is fine for many uses.

jordens, 2018-09-07:
@hartytp You just expressed your aversion towards discussing design changes, your disinterest in variants, preempted any further discussion by declaring Urukul "pretty close to optimal", and shrugged your shoulders saying that we should do whatever we want. And now you are implying that I "dislike the MMCX connectors so much" as if I had some irrational hate against a specific connector type and you wanted to analyze that bias. What gives?
Haven't we discussed the pros and cons of the various clock inputs already? What do you want here?

I have no bias against "the MMCX connectors". They are fine connectors.

Urukul already has a good ppm-stable ultra low noise clock on board. There is zero need to go through the hassle of designing, procuring, buying, installing a cable from Kasli if that XO is good enough. Especially for "first-time users" and especially for the applications where ppm stability is absolutely fine. There is differential stability between Urukul channels is unaffected which further reduces the need for absolute external references. I have a hard time coming up with reasons to use the Kasli fanout if that's not externally stabilized. If the XO is good enough it doesn't matter how easy you think the MMCX cable idea is. It'll always be more complicated.

On top of it being unnecessary, I do find it tedious to install MMCX cables. They are much less flexible than the ribbon cables and the COTS ones IME of are all with a U connector arrangement and not the N arrangement we need. That puts maximal twist strain on the boards/cables/connectors. And custom ones are certainly not cheap (i.e. more expensive than the XO, which is already free on board). Having a bunch of MMCX cables in there makes an already challenging cable routing job significantly more difficult, more so if you ever want to disassemble/rearrange or swap cards. A dozen IDC30 ribbon cables and maybe another 8 short IDC26 jumper cables in a crate is a tradeoff I am happy to make when comparing that with the backplane. But another 4 or more MMCX cables does not help.

The Kasli recovered clock only has that 100ps long-term stability (which is only good for some cases) when operated as a DRTIO satellite. Otherwise (i.e. in all non-DRTIO and in all DRTIO-master setups) it has a non-deterministic phase offset w.r.t. external.

External fanouts tend to be just there in the lab. And usually there is a port available. The cable from the fan-out to Urukul is as cheap as the internal one. And typically you only need one cable at most since the other Urukuls are fine on their internal clock. If you want to always use the MMCX, you need a cable per Urukul.

Using an external reference also opens up the door to bypass the DDS PLLs. And it give you the opportunity to use Urukul to derive frequencies from others, i.e. use it as a microstepper or generally as a highly capable PLL or modular divider.

I guess beyond your mutual thumbs-up you are both aware of the spurs you are adding when you connect Kasli on MMCX (unstabilized because usually and especially for first-time users Kasli frequency lock is not needed) and ever want to connect an external reference to the Urukul SMA.

And finally, using Kasli's clock has another crucial problem (in the way it is currently implemented): it drops out and re-locks each time Kasli reboots. That's not the case for the XO or an external clock which makes them the only answer if you need reliable RF output for long times (locks or trap RF) and want to be able to survive Kasli crashes or new firmware/gateware. Maybe you don't need that, but others do.

jordens, 2018-09-07:
Yes: surprisingly the XO is a stupid idea if you need an absolute phase or/and absolute frequency. I am not saying that the XO should be the only solution!
Currently none of that is implemented and exactly nothing is killed. And it only matters for very specific use cases (only AD9910, only if the SYNC clock and the RTIO clock are derived from the same source, only if the FPGA drives SYNC, only if absolute phase determinism is needed). The default relative phase mode works fine. And using the XO won't even kill synchronization between DDS. And finally there is the SYNC clk on the EEM connector that can be used to retime IO_UPDATE to meet S/H at all DDS. Still all with the XO or an external clock.

sbourdeauducq, 2018-09-07:
> And using the XO won't even kill synchronization between DDS.

It does between Urukul cards.

hartytp, 2018-09-12:
@jordens okay, maybe I misunderstood you. I'm certainly not trying to imply that the MMCX is the best solution for all use cases, or that it should be the only option provided. I simply feel that it's a useful enough option that it should be enabled in the "default" Urukul configuration without having to get a soldering iron out.

I can see the utility of all three clocking options (XO, SMA, MMCX) and expect all to be used regularly. That's why I like having the two muxes to make that simple.

hartytp, 2018-09-12:
More generally, we've previously had in depth discussions about the features you suggested removing. Someone has made a case for each of them, and we agreed that they add value to the base design. As @gkasprow pointed out, the marginal cost of these features is low compared with volume pricing, so I still think it makes sense to keep them in the default design.

If you feel strongly that we should reopen these discussions then we can do. I just don't think that I have much to say on top of all the previous discussions on these matters.

gkasprow, 2018-09-12:
One can always order previous release...

hartytp, 2018-09-12:
@gkasprow yes, but:
- if we fix further bugs then that won't be applied to previous releases
- I'd really like to get to the point where a supplier carries some stock of the more popular EEMs available for next day shipping at a reasonably low cost. I don't see that happening if we start supporting too many population options

Anyway, since it's all open source, any group can order whatever version they like. If they're ordering enough units then a custom version with some features removed might well make sense.

Closed 2018-08-06.

Thread 8 (2018-07-30):

Defloat the SMAs

hartytp, 2018-07-30:
@gkasprow didn't we agree to defloat the SMAs on Urukul by replacing the 100k resistors with 0R resistors (and adding a note that they can be floated by changing the resistors).

hartytp, 2018-07-30:
Note, I don't really mind what we do here, so if people prefer to keep them floated by default then that's fine by me. Just seems like unfloating them and scrapping the insulating washers might be easier and mechanically better. It's pretty easy for users who want the SMAs floated to drill out the FP and add the washers.

sbourdeauducq, 2018-07-31:
Drilling front panels is messy, better keep the washers in all cases.

hartytp, 2018-07-31:
> Drilling front panels is messy, better keep the washers in all cases.

Fine by me.

The things I haven't got a feeling for are:
1. how niche a use-case is floating the SMAs? For us, it will be sufficiently rare that I wouldn't mind having to modify/order new FPs to do it. We'd need user feedback here to know what other people think
2. What are the mechanical/cost downsides involved with the isolating washers. If they're cheap and mechanically fine then there isn't any point removing them. @gkasprow

gkasprow, 2018-08-04:
Cost of the washers is negligible. It's far easier to keep them and have same front panels.

Closed 2018-08-04.

Thread 10 (2018-08-06):

Depopulate screening clips?

hartytp, 2018-08-06:
I'm happy to leave them in, but removing them saves a BOM line.

We've tested Urukul quite extensively at this point, including in a rack with Kasli as an EMI source. We don't see any evidence of cross-talk or pickup at a level that bothers us (which shows that @gkasprow's routing is good!).

gkasprow, 2018-08-06:
we can make them DNP

hartytp, 2018-08-06:
any objections? @jordens

jordens, 2018-08-06:
OK. But I'd still like to see a measurement of the crosstalk (kasli to urukul, urukul to urukul, and channel to channel) with the cans mounted on one of the existing boards. The crosstalk channel channel to channel with the cans not mounted. was done in December.

hartytp, 2018-08-06:
"OK" as in "okay, let's remove them" or as in "okay in principle, but let's get some data first"?

Would be an interesting measurement to make, but we'd need to get some screening cans made first.

jordens, 2018-08-06:
DNP them now, get the cans made for an existing board, and measure. Same goes for Zotino and Sampler.

hartytp, 2018-08-06:
:+1:

klickverbot, 2018-08-06:
Ack. The one caveat I would add is that it can be quite difficult to provoke EMI problems without proper test equipment (although I guess the main worry for Urukul would just be picking up single RF tones at inconvenient frequencies, which we could simulate using a loop antenna and the Frankonia amp).

jordens, 2018-08-06:
Yes. But I think that's only difficult if you need to split the attenuation into emitted and immitted.
I didn't know Frankonia also builds amplifiers...

Closed 2018-08-06.

Thread 11 (2018-08-06):

XO load resistance

hartytp, 2018-08-06:
Output current must be <=24mA according to the data sheet. Let's go for a total load of 150Ohm. With a 100R-50R divider, the peak-peak signal is still about 1V, which should be more than enough (particularly, since it's a square-wave output).

jordens, 2018-08-06:
I think in practice it was actually more than that. When I looked at it on a scope I was actually worried about it being too much.

hartytp, 2018-08-06:
Currently, we have a 50R-50R divider, so I'd expect more like 1.65Vp-p. Did you see more than that?

gkasprow, 2018-08-06:
No we have 100:50 divider.

Closed 2018-08-06.

Thread 12 (2018-08-06):

Urukul v1.3 review

hartytp, 2018-08-06:
Looks good. A couple of final comments:

- the front panel grounding resistors should be populated with 0R (same on Sampler)
- might be worth adding a note by the SMAs, saying "to float SMA grounds remove 0R resistors"

Otherwise, I can't see any issues with it.

Thread 14 (2018-10-08):

dnp screening clips

hartytp, 2018-10-08:
@gkasprow not that it's a big deal, but didn't we agree to dnp the screening clips for v1.3 Our creotech boards still have them.

gkasprow, 2018-10-09:
@hartytp yes, we did. I updated BOMs after the production started and that's why they mounted it. I should have changed the revision after BOM update.

hartytp, 2018-10-10:
Ok. Makes sense. Can we make sure that Creotech know to dnp them in any future production runs please?

gkasprow, 2018-10-10:
I asked them to use recent documentation just before production.

Closed 2018-10-10.

Thread 15 (2018-10-11):

Urukul (AD9912) glitches during phase ramping

jordens, 2018-10-11:
_From @kjh-m on October 11, 2018 7:35_

Hello,

I'm getting glitches from AD9912 output during a phase ramp experiment. Phase is ramped by small steps at a given intervals, while keeping the frequency set-point constant.

Problem persist for wide range of interval times (10 us - 10 ms) and frequencies (100 kHz to 300 MHz).

Initially I noticed this while doing frequency measurement with a counter. Observing the waveform with an oscilloscope revealed fast glitches occurring at random points of the cycle (see below).

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

Zooming in:
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

It seems that the glitches don't occur at every phase step. Screen capture of the oscilloscope shows glitch interval of 728 us, which is weirdly reproducible. In the measurement below, scope is triggered from glitches, so the waveform itself actually runs freely.

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

Also, DDS doesn't seem to lose coherence at the glitch, and the waveform continues smoothly.

All electrical connections are terminated to 50 ohms. Urukul is referenced to an external clock, while Kasli is not.

Simplified version of the phase ramping program is shown below.

- Kalle

----

```
from artiq.experiment import *

class stepper(EnvExperiment):

    def build(self):
        self.setattr_device("core")
        self.setattr_device("urukul0_cpld")
        self.setattr_device("urukul0_ch0")

    @kernel
    def run(self):

        self.core.reset()

        self.urukul0_cpld.init()
        self.urukul0_ch0.init()

        delay(1*ms)

        self.urukul0_ch0.set_att(10.)

        freq = 1*MHz
        freq_word = self.urukul0_ch0.frequency_to_ftw(freq)

        # Step phase by 16 units every 1 ms
        step_time = 1*ms
        phi_step = 16
        phi = 0

        # Start DDS
        self.urukul0_ch0.set_mu(freq_word,phi)
        self.urukul0_ch0.sw.on()

        delay(step_time)

        while True:
            # Increment phase
            phi += phi_step
            # Check if phase wraps around 2*pi, and correct accordingly
	    # 2*pi equals 2^14 = 16384
            if phi >= 16384:
                phi -= 16384
            # Set phase word
            self.urukul0_ch0.set_mu(freq_word,phi)
            delay(step_time)
````
----

_Copied from original issue: sinara-hw/sinara#596_

hartytp, 2018-10-11:
This reminds me of the glitches we saw when trying to do phase ramps on the AD9910. It was a few years back, so I forget the details, but IIRC:
- using the DDS in single-tone mode and only using profile 0
- then we were using the DDS in absolute phase mode, clearing the phase accumulator on each change of the phase (we had a phase accumulator on an FPGA that we programmed into the DDS via SPI, IO_UPDATE was synchronous with the DDS clock)
- stepping the DDS phase by as little as 1LSB would result in a very short glitch, before the DDS settled to the right value. This looked a lot like the waveforms you posted
- I tried a few things, like not using a synchronous IO_UPDATE, but wasn't able to get rid of these glitches. I tentatively concluded that updating the DDS phase while the RF was on/applied to the ion was a no-go.
- in that experiment we were able to get around this by using the ad9910 ramp generator to create our phase ramp. That didn't display these glitches, but is quite inflexible and a bit of a pain to use. This is one of the main drivers for the effort we've invested in having a proper artiq (S)AWG; personally, I wouldn't try to do any complex modulation with a DDS again unless I really had to

Anyway, not sure if this is related to your observations, but figured it might be a useful data point..

hartytp, 2018-10-11:
> @hartytp Thanks for the info. Hmm. That would be bad.

Caveats are that I never tried with an AD9912, I didn't try other phase update modes, etc so there may be some way around that issue even for the AD9910. But worth being aware that we had problems with it.

jordens, 2018-10-11:
Ok. The AD9910 phase corruption was just user error. I.e. I can't reproduce the glitches @kjh-m reported on Urukul-AD9910/v1.0 or Urukul-AD9910/v1.3.
@kjh-m please let me know if the delay or a longer IO_UPDATE pulse fix this.

jordens, 2018-10-11:
@hartytp Not that it would necessarily explain what you observed, but when you did that absolute phase control with the AD9910, did the synchronous IO_UPDATE meet s/h w.r.t. SYNC_CLK?

kjh-m, 2018-10-11:
Thanks for quick replies!

 @jordens ok, it's interesting that you didn't see the problem with AD9910. Adding a delay before io_update and/or lengthening the pulse didn't resolve the problem.

jordens, 2018-10-11:
@kjh-m

Two things that weren't clear:
* Are the glitches at all related to the phase updates (in frequency and/or timing)?
* Does the 728 µs number depend on anything?

And two things to test:
* Do the glitches depend on your phase step size or phase trajectory? E.g. do they also appear if you just toggle between 0x0000 and 0x3fff or between 0x0 and 0x1?
* Does it change if you change SPIT_DDS_WR to 4 (https://github.com/m-labs/artiq/blob/08074d52754af33781a9683a3392c12099b37c5c/artiq/coredevice/urukul.py#L19)?

kjh-m, 2018-10-11:
@jordens

Generally speaking I get similar behavior with any frequency or timing settings.

Interestingly, if I switch between any two adjacent (non-wrapping) phase values (e.g. 0x00, 0x01 or 0x50 and 0x50) I don't get any glitching. But switching between 0x0000 and 0x3fff results in significant glitching. So that's probably it. Going over 2*pi does something bad.

I'm bit confused about the phase setting anyway. In ad9912.py, doesn't the phase setting float get scaled to 16 bits? (Here: https://github.com/m-labs/artiq/blob/7d6a1b528d6cc5ad7b01df11ea5b01fd50d40ed0/artiq/coredevice/ad9912.py#L172)

Changing SPIT_DDS_WR to 4 didn't help.

Maybe 728 µs was a coincidence after all..

kjh-m, 2018-10-11:
Ok, so the following is stated in the AD9912 datasheet about the phase tuning word:

> Allows the user to vary the phase of the DDS output. See the Direct Digital Synthesizer section. Register 0x01AC is the least significant byte of the phase offset word (POW). Note that a momentary phase discontinuity may occur as the phase passes through 45° intervals.

45° corresponds to 0x800. Quick test reveals glitches when switching over the 45° boundaries (but nowhere else):

45° 0x7FF to 0x800
90° 0xFFF to 0x1000
135° 0x17FF to 0x1800
180° 0x1FFF to 0x2000
225° 0x27FF to 0x2800
270° 0x2FFF to 0x3000
315° 0x37FF to 0x3800
360° 0x3FFF to 0x0000

So it might be a feature. I wonder if there's a way around it..

jordens, 2018-10-11:
@kjh-m L172 is probably a bug. It's 14 bit LSB aligned.

And oh surprise: "[Note that a momentary
phase discontinuity may occur as the phase passes through 45° intervals.](http://www.analog.com/media/en/technical-documentation/data-sheets/AD9912.pdf#page=36)"

jordens, 2018-10-11:
The workaround that I can see is shifting the frequency for some duration and then shifting back. Has the advantage of more phase resolution and being continuous.

hartytp, 2018-10-11:
> @hartytp Not that it would necessarily explain what you observed, but when you did that absolute phase control with the AD9910, did the synchronous IO_UPDATE meet s/h w.r.t. SYNC_CLK?

Yes.

As I said, it was a couple of years back, so I'd have to dig out the (paper) lab books to be sure about what we were doing then.

Thread 16 (2018-11-06):

SYNC_IN jitter

jordens, 2018-11-06:
The jitter on the SYNC_IN signal from Kasli to the AD9910 (throught the LVDS buffers and the fanout) is  very high in some caes (the tester setup connected to the buildbot).

At validation delay 1 (hold and setup margin 1 tap) the window is just 2 taps wide (a tap is about 75 ps).
http://buildbot.m-labs.hk/builders/artiq/builds/2669/steps/python_unittest_2/logs/stdio

This is the SMP_ERR matrix on tester, rows are increasing validation delay, columns are SYNC_IN delay on the AD9910.:
```
[1, 1, 0, 0, 1, 1, 1, 1, 0, 0, 0, 0, 0, 1, 1, 0, 0, 1, 1, 1, 0, 0, 0, 0, 0, 1, 1, 0, 0, 0, 1, 1]
[1, 1, 1, 1, 1, 1, 1, 1, 1, 0, 0, 1, 1, 1, 1, 1, 1, 1, 1, 1, 1, 0, 0, 0, 1, 1, 1, 1, 1, 1, 1, 1]
[1, 1, 1, 1, 1, 1, 1, 1, 1, 1, 1, 1, 1, 1, 1, 1, 1, 1, 1, 1, 1, 1, 1, 1, 1, 1, 1, 1, 1, 1, 1, 1]
[1, 1, 1, 1, 1, 1, 1, 1, 1, 1, 1, 1, 1, 1, 1, 1, 1, 1, 1, 1, 1, 1, 1, 1, 1, 1, 1, 1, 1, 1, 1, 1]
[1, 1, 1, 1, 1, 1, 1, 1, 1, 1, 1, 1, 1, 1, 1, 1, 1, 1, 1, 1, 1, 1, 1, 1, 1, 1, 1, 1, 1, 1, 1, 1]
[1, 1, 1, 1, 1, 1, 1, 1, 1, 1, 1, 1, 1, 1, 1, 1, 1, 1, 1, 1, 1, 1, 1, 1, 1, 1, 1, 1, 1, 1, 1, 1]
```
There also seems to be some bounce around the edges (top row).

On the systems I have here I get about 5-6 tap wide windows at validation delay 1. That's not stellar but OK.
When using the SYNC signal on board from the first DDS, the window at validation delay 1 is 8 taps wide on tester, 8-9 taps here.
Assuming equal tap delay for the validation delays and the SYNC_IN delays, the theoretically best case is validation delay 4 and a window width of ~4 or a validation delay of 1 and a window width of ~10 (i.e. SYNC_IN delay periodicity minus twice the validation delay).

```
[0, 0, 0, 0, 0, 0, 0, 0, 0, 0, 0, 1, 0, 0, 0, 0, 0, 0, 0, 0, 0, 0, 0, 1, 1, 0, 0, 0, 0, 0, 0, 0]
[1, 1, 0, 0, 0, 0, 0, 0, 0, 0, 1, 1, 1, 1, 0, 0, 0, 0, 0, 0, 0, 0, 1, 1, 1, 1, 0, 0, 0, 0, 0, 0]
[1, 1, 0, 0, 0, 0, 0, 0, 1, 1, 1, 1, 1, 1, 1, 0, 0, 0, 0, 0, 1, 1, 1, 1, 1, 1, 1, 0, 0, 0, 0, 0]
[1, 1, 1, 1, 0, 0, 0, 1, 1, 1, 1, 1, 1, 1, 1, 1, 0, 0, 0, 1, 1, 1, 1, 1, 1, 1, 1, 1, 1, 0, 0, 0]
[1, 1, 1, 1, 1, 0, 1, 1, 1, 1, 1, 1, 1, 1, 1, 1, 1, 1, 1, 1, 1, 1, 1, 1, 1, 1, 1, 1, 1, 1, 1, 1]
[1, 1, 1, 1, 1, 1, 1, 1, 1, 1, 1, 1, 1, 1, 1, 1, 1, 1, 1, 1, 1, 1, 1, 1, 1, 1, 1, 1, 1, 1, 1, 1]
```

In both cases Kasli/v1.1 and Urukul-AD9910/v1.3, connected via MMCX to Kasli-J1.

The jitter seems to come in part from Urukul and in part (the larger part) from Kasli. And it varies between setups.
I changed a couple things (see the artiq changelog) to optimize jitter on the RTIO clock but there was little effect. From Vivado the max peak-peak jitter on the clock driving the SYNC output buffer in the FPGA is ~90ps.
I tried running the SYNC fanout from the supposedly quieter P1V8A rail but that doesn't seem to work at all.

@gkasprow @marmeladapk could you have a look at the jitter on SYNC_IN (EEM0:7, before and after the sync fanout, compared to the Kasli MMCX clock)?

@cjbe @klickverbot When you were playing with SYNC, did you look at SMP_ERR? How did you select the SYNC_IN delay and the validation delay? Did you scan them?

c.f. m-labs/artiq#1143

jordens, 2018-11-06:
I tried with the fully loaded Tester variant and Urukul on EEM0/1 on the hardware here. That also reproduces the narrow window (2 taps wide at validation delay 1) and the bouncing. The bouncing is something that I can't really explain with regular FPGA supply rail crowding.

Then I tried with a variant containing only that Urukul EEM and nothing else. Both with it on EEM0/1 and EEM5/4. Both are very jittery as well (window size ~4 at validation delay 1).

And I tried clocking the SYNC output register from its own dedicated BUFG. No significant change.

cjbe, 2018-11-06:
@jordens we look at SMP_ERRs and scanned to find the optimum point, and see similar things to you (i.e. similarly narrowed window widths for the Kasli clock vs the DDS sync_out).

I am also a bit worried about this, but have not had time to look at it properly yet. Empirically it is working without problem across two systems in our lab.

When I tested this thoroughly (https://github.com/sinara-hw/Urukul/issues/3#issuecomment-396951759) I saw several SMP_ERRs per 10^10 samples (300ps validation window), but I did not see any losses of sync. (To see this I logged channels from 2 different Urukuls on a scope on persist, started the system from cold, and ran it for a day to achieve 10^10 resyncs).

klickverbot, 2018-11-06:
@jordens We set the SYNC_IN delay by scanning it and manually choosing the centre of the "eye" (i.e. error-free region). Two examples from a while ago, using two Urukul v1.0 connected to the same Kasli v1.0:

```
rurukul0: 0   [0, 0, 0, 0]
rurukul0: 1   [1000, 1000, 259, 0]
rurukul0: 2   [1000, 1000, 1000, 1000]
rurukul0: 3   [1000, 1000, 1000, 1000]
rurukul0: 4   [1000, 1000, 1000, 1000]
rurukul0: 5   [1000, 1000, 1000, 995]
rurukul0: 6   [1000, 1000, 1000, 1000]
rurukul0: 7   [1000, 1000, 1000, 1000]
rurukul0: 8   [0, 0, 0, 1000]
rurukul0: 9   [0, 0, 0, 0]
rurukul0: 10  [0, 0, 0, 0]
rurukul0: 11  [0, 0, 0, 0]
rurukul0: 12  [0, 0, 0, 0]
rurukul0: 13  [0, 0, 0, 0]
rurukul0: 14  [1000, 758, 499, 49]
rurukul0: 15  [1000, 1000, 1000, 1000]
rurukul0: 16  [1000, 1000, 1000, 1000]
rurukul0: 17  [1000, 1000, 1000, 1000]
rurukul0: 18  [1000, 1000, 1000, 1000]
rurukul0: 19  [1000, 1000, 1000, 1000]
rurukul0: 20  [1000, 1000, 1000, 1000]
rurukul0: 21  [1000, 1000, 870, 1000]
rurukul0: 22  [0, 0, 0, 0]
rurukul0: 23  [0, 0, 0, 0]
rurukul0: 24  [0, 0, 0, 0]
rurukul0: 25  [0, 0, 0, 0]
rurukul0: 26  [0, 0, 0, 0]
rurukul0: 27  [0, 0, 0, 2]
rurukul0: 28  [1000, 1000, 1000, 1000]
rurukul0: 29  [1000, 1000, 1000, 1000]
rurukul0: 30  [1000, 1000, 1000, 1000]
rurukul0: 31  [1000, 1000, 1000, 1000]

rurukul1: 0   [0, 0, 0, 0]
rurukul1: 1   [0, 0, 0, 0]
rurukul1: 2   [0, 0, 0, 0]
rurukul1: 3   [1000, 0, 156, 0]
rurukul1: 4   [1000, 1000, 1000, 1000]
rurukul1: 5   [1000, 1000, 1000, 1000]
rurukul1: 6   [1000, 1000, 1000, 937]
rurukul1: 7   [1000, 1000, 1000, 1000]
rurukul1: 8   [1000, 1000, 1000, 1000]
rurukul1: 9   [1000, 1000, 1000, 1000]
rurukul1: 10  [0, 61, 0, 0]
rurukul1: 11  [0, 0, 0, 0]
rurukul1: 12  [0, 0, 0, 0]
rurukul1: 13  [0, 0, 0, 0]
rurukul1: 14  [0, 0, 0, 0]
rurukul1: 15  [0, 0, 0, 0]
rurukul1: 16  [1000, 0, 1000, 0]
rurukul1: 17  [1000, 900, 1000, 1000]
rurukul1: 18  [1000, 1000, 1000, 1000]
rurukul1: 19  [77, 1000, 1000, 1000]
rurukul1: 20  [1000, 1000, 1000, 1000]
rurukul1: 21  [1000, 1000, 1000, 1000]
rurukul1: 22  [1000, 1000, 1000, 1000]
rurukul1: 23  [0, 1000, 0, 1000]
rurukul1: 24  [0, 0, 0, 0]
rurukul1: 25  [0, 0, 0, 0]
rurukul1: 26  [0, 0, 0, 0]
rurukul1: 27  [0, 0, 0, 0]
rurukul1: 28  [0, 0, 0, 0]
rurukul1: 29  [362, 0, 1000, 0]
rurukul1: 30  [1000, 766, 1000, 27]
rurukul1: 31  [1000, 1000, 1000, 1000]
```

Urukul v1.1 connected to a Kasli v1.1:
```
0   [1000, 1000, 1000, 1000]
1   [1000, 1000, 1000, 763]
2   [1000, 1000, 1000, 1000]
3   [60, 0, 1000, 1000]
4   [0, 0, 0, 245]
5   [0, 0, 0, 0]
6   [0, 0, 0, 0]
7   [0, 0, 0, 0]
8   [0, 0, 0, 0]
9   [0, 0, 0, 0]
10  [0, 38, 0, 1]
11  [946, 1000, 0, 511]
12  [1000, 1000, 3, 1000]
13  [1000, 1000, 930, 1000]
14  [1000, 1000, 1000, 977]
15  [1000, 1000, 1000, 1000]
16  [955, 30, 1000, 1000]
17  [0, 0, 1000, 1000]
18  [0, 0, 0, 0]
19  [0, 0, 0, 0]
20  [0, 0, 0, 0]
21  [0, 0, 0, 0]
22  [0, 0, 0, 0]
23  [0, 0, 0, 0]
24  [999, 1000, 0, 217]
25  [1000, 1000, 0, 1000]
26  [1000, 1000, 0, 1000]
27  [1000, 1000, 838, 1000]
28  [1000, 1000, 1000, 1000]
29  [1000, 995, 1000, 1000]
30  [0, 0, 1000, 1000]
31  [0, 0, 1000, 4]
```

These are the number of SMP_ERRs per 1000 trials for each of the channels, with validation tap setting `0`. At `2`, the windows are down to 2 taps; completely closed at 4.

As Chris mentioned, we haven't seen any errors in production yet, but we haven't been looking very hard (i.e. only indirectly through relatively crappy quadrupole laser gates).

jordens, 2018-11-06:
At 62.5 MHz SYNC_IN there are already 1e10 resyncs after 3 minutes of running. And since SMP_ERR is latching and checking each one of them, I haven't seen an invalid (re)sync in >1e13. I am also uncertain how "loss of sync" would manifest itself on the outputs if there is no frequency/phase change. My guess is that it would not even be a 16ns transient and even if there is a 16ns transient, you'll capture that only if you mix or diff the channels on a scope. The reasoning is based on conjecture how the DDS works internally (ADI patents and SAWG: SYNC_CLK will have a pair of a short and a long cycle length glitches but since the outputs run at 1 GHz output will be exactly the same).

I.e. I am not worried about using a window that is 6 taps wide at validation delay 1. But I am worried about dealing with a window that is only 2 taps wide at validation delay 1.

jordens, 2018-11-06:
You shouldn't need to repeatedly check SMP_ERR. It's latching. Just let it hammer for a couple µs.
That width of 5 at validation delay 0 (2 at 2 and 0 at 4) is as bad as the data from Tester and worse than the 5-6 at 1 that I get here (with PTB2).

jordens, 2018-11-06:
I forgot your posts on the other issue. Thanks for digging them out.

The IO_UPDATE delay tuning is done. That is now measured without external hardware and can be done at runtime. And it is stable to the ns over all PVT cases I have looked at.

klickverbot, 2018-11-06:
Yep, I saw your (nice) commits – we'll definitely have a look at porting our code over from the quick stopgap fix to your driver soon.

cjbe, 2018-11-06:
@jordens in our work we are using the 'clear phase accumulator on IO_UPDATE' mode. This means that a sync error looks like a 1ns phase origin glitch, which is very obvious (i.e. 90 degrees at 250 MHz).

For my sync tests I checked the alignment of the RF outputs with an RTIO TTL output - I confirmed that sitting outside of the window caused obvious phase alignment errors, and that sitting at the edge of the window (as measured with 0 validation delay) caused a small but measurable phase alignment error rate.

cjbe, 2018-11-06:
> You shouldn't need to repeatedly check SMP_ERR. It's latching. Just let it hammer for a couple µs.

Yeah - the repeated checking on the eye scans is just to get an error rate estimate.

jordens, 2018-11-06:
@cjbe Could you clarify what you mean by "sync error"? Not "SMP_ERR", probably. And how are you seeing that "sync error" if the next SYNC_IN event (corrective reset of the SYNC_CLK generator) is just 16 ns away? How long are the "glitches"?
Pretty sure that SYNC_IN hitting the wrong SYSCLK cycle is invisible as long as there is no phase/frequency change at the same time. And as you say, you haven't seen anything and I haven't seen anything either, even when provoking SMP_ERR.
You would see a misalignment between DDS outputs if the SYNC_CLK is misaligned **at the same time** as the IO_UPDATE event. That's what I can see as well. Is that what you tested?

> Yeah - the repeated checking on the eye scans is just to get an error rate estimate.

But then you iterated over the 1000-iteration another 4 times...

@klickverbot ACK.

But we should figure out where that high SYNC_IN jitter comes from. If someone with access to jitter measurement tools could have a look, that would be great. Might also move this to Kasli.

jordens, 2018-11-06:
From a quick look with a spectrum analyzer and scope, SYNC_IN after going through the fanout, another IDC cable and a LVDS-to-CMOS converter is pretty clean. Spurs (from sys_clk logic modulating rtio_clk) on the SYNC_IN fundamental are down ~50 dB, on the 7th harmonic down ~30 dB.

cjbe, 2018-11-06:
@jordens
> Could you clarify what you mean by "sync error"? Not "SMP_ERR", probably. And how are you seeing that "sync error" if the next SYNC_IN event (corrective reset of the SYNC_CLK generator) is just 16 ns away? How long are the "glitches"?

By 'sync error' I mean observing that the relationship between the DDS phase and an RTIO event is incorrect. The DDS is in a mode where the phase accumulator is reset to zero on IO_UPDATE. If the DDS state machine is not properly synced when it registers the IO_UPDATE the DDS phase is incorrect (i.e. the DDS chooses the wrong edge of the 1 GHz clock as the phase origin, leading to ~90 degree phase shifts for 250 MHz output).

I triggered the scope from an RTIO TTL output at a fixed delay from the IO_UPDATE - if everything is working correctly the DDS phase should be fixed relative to the RTIO output event. If this phase is incorrect the DDS was not properly synced at IO_UPDATE.

cjbe, 2018-11-06:
@jordens
>But then you iterated over the 1000-iteration another 4 times...

Ah - these are the SMP_ERR counts for channels 0..3, so that
`24  [999, 1000, 0, 217]`
means that at validation delay tap 24 channel 0 had 999 errors out of 1000 samples, channel 1 had 1000 errors out of 1000 samples, etc.

gkasprow, 2018-11-23:
IT's worth looking at the CPLD IO suply rail. The SMPS may work in discontinuous mode causing high ripples on CPLD supply.

jordens, 2018-11-24:
That signal doesn't go through the CPLD. It would need to be crosstalk from the control lines of the fan out. The fan out supply seemed clean.

gkasprow, 2018-12-04:
You can try with FSEN pin state on LVDS receivers. It may affect the jitter.

AUTProgram, 2018-12-12:
I have run sync_scan from the ad9910 test suite several times on two cards of the old (v1.0) and two cards of the new (v1.3) hardware versions of Urukul. Overall I did about 30 runs on each card.

For cards of revision 1.0, the errors resulting from different validation delays were quite variable, typical results for one card would look like these:

about 70% of all runs:
```
[1, 1, 1, 1, 0, 0, 0, 0, 0, 0, 0, 0, 1, 1, 1, 1, 1, 1, 0, 0, 0, 0, 0, 0, 0, 0, 1, 1, 1, 1, 1, 0]
[1, 1, 1, 1, 1, 1, 1, 1, 1, 1, 1, 1, 1, 1, 1, 1, 1, 1, 1, 1, 1, 1, 1, 1, 1, 1, 1, 1, 1, 1, 1, 1]
[1, 1, 1, 1, 1, 1, 0, 0, 0, 1, 1, 1, 1, 1, 1, 1, 1, 1, 1, 1, 0, 0, 0, 1, 1, 1, 1, 1, 1, 1, 1, 1]
[1, 1, 1, 1, 1, 1, 1, 0, 1, 1, 1, 1, 1, 1, 1, 1, 1, 1, 1, 1, 1, 1, 1, 1, 1, 1, 1, 1, 1, 1, 1, 1]
[1, 1, 1, 1, 1, 1, 1, 1, 1, 1, 1, 1, 1, 1, 1, 1, 1, 1, 1, 1, 1, 1, 1, 1, 1, 1, 1, 1, 1, 1, 1, 1]
[1, 1, 1, 1, 1, 1, 1, 1, 1, 1, 1, 1, 1, 1, 1, 1, 1, 1, 1, 1, 1, 1, 1, 1, 1, 1, 1, 1, 1, 1, 1, 1]
```

about 20% of all runs:
```
[1, 1, 1, 1, 0, 0, 0, 0, 0, 0, 0, 0, 1, 1, 1, 1, 1, 1, 0, 0, 0, 0, 0, 0, 0, 0, 1, 1, 1, 1, 1, 1]
[1, 1, 1, 1, 1, 0, 0, 0, 0, 0, 1, 1, 1, 1, 1, 1, 1, 1, 1, 0, 0, 0, 0, 0, 0, 1, 1, 1, 1, 1, 1, 1]
[1, 1, 1, 1, 1, 1, 0, 0, 0, 1, 1, 1, 1, 1, 1, 1, 1, 1, 1, 1, 0, 0, 0, 0, 1, 1, 1, 1, 1, 1, 1, 1]
[1, 1, 1, 1, 1, 1, 1, 0, 1, 1, 1, 1, 1, 1, 1, 1, 1, 1, 1, 1, 1, 1, 1, 1, 1, 1, 1, 1, 1, 1, 1, 1]
[1, 1, 1, 1, 1, 1, 1, 1, 1, 1, 1, 1, 1, 1, 1, 1, 1, 1, 1, 1, 1, 1, 1, 1, 1, 1, 1, 1, 1, 1, 1, 1]
[1, 1, 1, 1, 1, 1, 1, 1, 1, 1, 1, 1, 1, 1, 1, 1, 1, 1, 1, 1, 1, 1, 1, 1, 1, 1, 1, 1, 1, 1, 1, 1]
```

about 10% of all runs:
```
[1, 1, 1, 1, 0, 0, 0, 0, 0, 0, 0, 0, 1, 1, 1, 1, 1, 1, 0, 0, 0, 0, 0, 0, 0, 0, 1, 1, 1, 1, 1, 0]
[1, 1, 1, 1, 1, 1, 1, 1, 1, 1, 1, 1, 1, 1, 1, 1, 1, 1, 1, 1, 1, 1, 1, 1, 1, 1, 1, 1, 1, 1, 1, 1]
[1, 1, 1, 1, 1, 1, 1, 1, 1, 1, 1, 1, 1, 1, 1, 1, 1, 1, 1, 1, 1, 1, 1, 1, 1, 1, 1, 1, 1, 1, 1, 1]
[1, 1, 1, 1, 1, 1, 1, 1, 1, 1, 1, 1, 1, 1, 1, 1, 1, 1, 1, 1, 1, 1, 1, 1, 1, 1, 1, 1, 1, 1, 1, 1]
[1, 1, 1, 1, 1, 1, 1, 1, 1, 1, 1, 1, 1, 1, 1, 1, 1, 1, 1, 1, 1, 1, 1, 1, 1, 1, 1, 1, 1, 1, 1, 1]
[1, 1, 1, 1, 1, 1, 1, 1, 1, 1, 1, 1, 1, 1, 1, 1, 1, 1, 1, 1, 1, 1, 1, 1, 1, 1, 1, 1, 1, 1, 1, 1]
```
and for the other card
about 2/3 of runs:
```
[0, 0, 0, 0, 1, 1, 1, 1, 1, 1, 0, 0, 0, 0, 0, 0, 0, 0, 1, 1, 1, 1, 0, 0, 0, 0, 0, 0, 0, 0, 1, 1]
[0, 0, 0, 1, 1, 1, 1, 1, 1, 1, 1, 0, 0, 0, 0, 0, 1, 1, 1, 1, 1, 1, 1, 1, 0, 0, 0, 0, 0, 1, 1, 1]
[1, 1, 1, 1, 1, 1, 1, 1, 1, 1, 1, 1, 1, 1, 1, 1, 1, 1, 1, 1, 1, 1, 1, 1, 1, 1, 1, 1, 1, 1, 1, 1]
[1, 1, 1, 1, 1, 1, 1, 1, 1, 1, 1, 1, 1, 1, 1, 1, 1, 1, 1, 1, 1, 1, 1, 1, 1, 1, 1, 1, 1, 1, 1, 1]
[1, 1, 1, 1, 1, 1, 1, 1, 1, 1, 1, 1, 1, 1, 1, 1, 1, 1, 1, 1, 1, 1, 1, 1, 1, 1, 1, 1, 1, 1, 1, 1]
[1, 1, 1, 1, 1, 1, 1, 1, 1, 1, 1, 1, 1, 1, 1, 1, 1, 1, 1, 1, 1, 1, 1, 1, 1, 1, 1, 1, 1, 1, 1, 1]
```

about 1/3 of runs:
```
[0, 0, 0, 0, 1, 1, 1, 1, 1, 1, 0, 0, 0, 0, 0, 0, 0, 0, 1, 1, 1, 1, 0, 0, 0, 0, 0, 0, 0, 0, 1, 1]
[0, 0, 0, 1, 1, 1, 1, 1, 1, 1, 1, 0, 0, 0, 0, 0, 1, 1, 1, 1, 1, 1, 1, 1, 0, 0, 0, 0, 0, 1, 1, 1]
[0, 0, 1, 1, 1, 1, 1, 1, 1, 1, 1, 1, 0, 0, 0, 1, 1, 1, 1, 1, 1, 1, 1, 1, 1, 0, 0, 0, 1, 1, 1, 1]
[1, 1, 1, 1, 1, 1, 1, 1, 1, 1, 1, 1, 1, 1, 1, 1, 1, 1, 1, 1, 1, 1, 1, 1, 1, 1, 1, 1, 1, 1, 1, 1]
[1, 1, 1, 1, 1, 1, 1, 1, 1, 1, 1, 1, 1, 1, 1, 1, 1, 1, 1, 1, 1, 1, 1, 1, 1, 1, 1, 1, 1, 1, 1, 1]
[1, 1, 1, 1, 1, 1, 1, 1, 1, 1, 1, 1, 1, 1, 1, 1, 1, 1, 1, 1, 1, 1, 1, 1, 1, 1, 1, 1, 1, 1, 1, 1]
```

For two cards of the new revision 1.3, all runs basically gave the same result:
```
[1, 1, 0, 0, 0, 0, 0, 0, 0, 0, 1, 1, 1, 1, 1, 1, 0, 0, 0, 0, 0, 0, 0, 1, 1, 1, 1, 1, 0, 0, 0, 0]
[1, 1, 1, 1, 0, 0, 0, 0, 1, 1, 1, 1, 1, 1, 1, 1, 1, 0, 0, 0, 0, 0, 1, 1, 1, 1, 1, 1, 1, 1, 0, 0]
[1, 1, 1, 1, 1, 0, 0, 1, 1, 1, 1, 1, 1, 1, 1, 1, 1, 1, 0, 0, 1, 1, 1, 1, 1, 1, 1, 1, 1, 1, 1, 0]
[1, 1, 1, 1, 1, 1, 1, 1, 1, 1, 1, 1, 1, 1, 1, 1, 1, 1, 1, 1, 1, 1, 1, 1, 1, 1, 1, 1, 1, 1, 1, 1]
[1, 1, 1, 1, 1, 1, 1, 1, 1, 1, 1, 1, 1, 1, 1, 1, 1, 1, 1, 1, 1, 1, 1, 1, 1, 1, 1, 1, 1, 1, 1, 1]
[1, 1, 1, 1, 1, 1, 1, 1, 1, 1, 1, 1, 1, 1, 1, 1, 1, 1, 1, 1, 1, 1, 1, 1, 1, 1, 1, 1, 1, 1, 1, 1]
```

The results for the (Creotec) v1.3 boards are consistent with pk-pk jitter of approx 400ps.

AUTProgram, 2018-12-12:
@gkasprow what level of jitter would you expect for the LVDS SYSREF generated by Kasli after going through cabling, LVDS buffers, etc? Any idea why the newer boards seem to behave better than the old ones?

@jordens which versions of the hardware did you test?

hartytp, 2018-12-12:
We were setting up to look into the sync in jitter issue and see if we could locate its origin, however we weren't able to reproduce it in our test setup.

Some other details (probably not material, but for completeness):
- using a Kasli v1.1 (Technosystem) with the -3 speed grade
- urukul clocked at 1GHz using the 125MHz Kasli clock via MMCX

gkasprow, 2018-12-12:
Jitter is dominated by the LVDS transceivers and could be even 0.5ns.
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

hartytp, 2018-12-12:
@gkasprow that 300ps is almost all data-dependent jitter, right? I'd have to double check what we're doing in the calibration code, but I'm not sure that could account for what we see.

It also doesn't explain the observation that we see no "eye" for some window sizes on the older hardware.

gkasprow, 2018-12-12:
Yes. So with square wave pattern it should not be visible. The boards could differ by level of 3V3 rail noise that could affect jitter significantly.

gkasprow, 2018-12-12:
Such deterministic jitter depends on activity on neighbouring channels. So you can check if during calibration something happens on SPI.

hartytp, 2018-12-12:
> Such deterministic jitter depends on activity on neighbouring channels. So you can check if during calibration something happens on SPI.

Anyway, even so, 300ps of deterministic jitter still wouldn't explain the issues @jordens and @cjbe observed.

> The boards could differ by level of 3V3 rail noise that could affect jitter significantly.

From a quick skim over the schematics, I didn't see any changes to the power supplies which could explain this, but maybe I missed something.

Could also be something to do with the clocking of the Urukuls from Kasli since I'm using the newer Kasli and @cjbe was using the older Kasli with worse clock distribution/floated MMCXs.

gkasprow, 2018-12-12:
That could be a matter of i.e. capacitors used. Other vendor means different characteristics.

hartytp, 2018-12-12:
@gkasprow I was wondering about that kind of thing. If, the decoupling somewhere is a bit marginal then the quality of the capacitors used could have a large impact on performance. Anyway, even our results with the v1.0 hardware look better than the data @jordens posted at the top of this issue, so I don't think this is just to do with the vendor of Urukul.

gkasprow, 2018-12-12:
If you have SSA, you can simply pass known clock signal to the Urukul and back and see how it gets degraded.
I've just ordered 6GHz SSA to my lab, so won't have to borrow it any more. They will deliver it in a few days. To do such test I will need one problematic Urukul.

jordens, 2018-12-13:
I had already checked crosstalk from busy SPI lines and I had looked at the signal after the fanout and another lvds-cmos converter, with a SA and not with a SSA though. My suspicion is that there is something going on between the fanout and the dds input. The jitter timescales are not slow (<100µs).

jordens, 2018-12-13:
The FS thing or noisy switchers shouldn't do anything either since that signal doesn't go through the LVDS converts or the CPLD and power supplies are the known-good clean ones.

jordens, 2018-12-13:
Could you also test the window width using the first dds sync out and compare that to my measurements above?

hartytp, 2018-12-13:
> I had already checked crosstalk from busy SPI lines and I had looked at the signal after the fanout and another lvds-cmos converter, with a SA and not with a SSA though. My suspicion is that there is something going on between the fanout and the dds input. The jitter timescales are not slow (<100µs).

Okay, good, I didn't realise you'd done such a thorough investigation already.

Out of curiosity, how did you probe the signal after the fanout? (lift a resistor and solder some coax onto the board)? IIRC there isn't a coax TP that one can use to do this easily.

hartytp, 2018-12-13:
@gkasprow checking I understand the design:
- the SYNC line comes in from Kasli on EEM0_7
- these go through a LVDS->LVMCOS converter (IC6A), with the LVCMOS output routed to the CPLD
- the LVDS line also routes to the clock fanout IC9 (in parallel with the LVDS to LVCMOS converter)
- the LVDS lines are terminated with 100R right by the LVDS->LVCMOS converter

Are we sure that the stub added by having both the LVDS->LVCMOS and the clock fanout won't cause SI issues?

jordens, 2019-01-23:
This might also be a ringing/impedance/drive strength issue. I see double windows on in some cases.

gkasprow, 2019-01-28:
@marmeladapk we plan to release the next revision of Urukul. I want to make sure we fix all known issues.
Can we recreate this issue in our lab?

klickverbot, 2019-01-28:
Here is an updated version of the hacky script to reproduce the above numbers: https://gist.github.com/klickverbot/fb54dc976e18373ed34d4f2fc55f0ffe

Looking at the window widths (and maybe full scans) reported by Robert's code should be just as good, though.

gkasprow, 2019-02-19:
I have two Urukul v1.1 in the lab. Can we use this version to recreate the issue?

jordens, 2019-02-20:
I am pretty sure that all versions have the issue.

hartytp, 2019-03-07:
@marmeladapk @gkasprow did you ever look at this?

gkasprow, 2019-03-08:
not yet but we will, we had higher priorities

hartytp, 2019-03-08:
No problem. That's what I assumed, but I wanted to be sure.

marmeladapk, 2019-03-21:
@jordens where can I find the code that you use for buildbot CI tests which gives these sync patterns?

hartytp, 2019-03-21:
Have a look here https://github.com/m-labs/artiq/blob/33b28f6e56a59810b0ee7ea0594a291e9d300e79/artiq/test/coredevice/test_ad9910.py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

marmeladapk, 2019-04-11:
Finally had some time for it. Some SYNC_IN measurements (though I do not have high confidence in them):
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

jordens, 2019-04-11:
Hmm. 1.2 ns jitter should not work at all.
And that forest from 90 to 110 mhz is not a modulation but additional signals, your Warsaw FM radio stations probably.

jordens, 2019-04-11:
Other than that the measurement looks similar in quality and in numbers to what I had reported above. The biggest intrinsic spurs (sys_clk modulation crosstalk) are down 45-50 dB.

gkasprow, 2019-04-11:
@jordens True, we have a few kW FM transmitter a few hundred meters from WUT, so it is quite obvious.

marmeladapk, 2019-04-16:
On DDS sync_in pads:
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

On EEM 7 connector:
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

jordens, 2019-04-16:
60ps would be awesome.
Maybe the level is just too high and we overdrive it (DC or AC). OTOH, according to the datasheet, SYNC_IN is supposed to be LVDS with internal 100 R termination and the Si53304 output schematic looks correct.

marmeladapk, 2019-04-16:
@jordens 60 ps from 10 Hz to 20 MHz (grey area was not integrated)

jordens, 2019-04-16:
Yes. From what I have seen the problem is not on longer timescales (already observed within a few µs). I.e. either FM radio is really getting into the SYNC signal or it's somewhere/something else.

hartytp, 2019-05-16:
@marmeladapk did you make any more progress on this? I'd really like to get the next revision of Urukul out soon.

Also, did you try running the test script on your board to see what window size it reported? We should check you can reproduce the issue (narrow windows reported on the ARTIQ scan) before spending too much time measuring noise.

marmeladapk, 2019-05-17:
@hartytp I ran the test script from ARTIQ and measured similar windows as Robert did. However I couldn't find this jitter anywhere on the sync_in path.

hartytp, 2019-05-17:
Interesting. So to check I understand the situation:
- you measured the differential AD9910 `SYNC_IN` signal for one of the DDSs (DDS0?) as close to the DDS chip as possible, with both Kasli and DDS0 as the SYNC source? I assume the signal levels etc are the same for both cases since they're driven from the same clock source. Is the frequency of both signals the same, or is there any other difference?
- the measured jitter was the same for both cases? and the jitter was very low compared with the 1ns sampling window. Was your measurement sensitive enough to spot infrequent glitches (which wouldn't necessarily show up on a power spectrum)? Did you look at the signals on a scope on persist mode?
- the DDS sync validation scan reports different windows for the two cases.

If you checked all that then I'm baffled as to what the source of this issue could be!

One other thing that would be interesting would be to look at the differential `SYNC_IN` signal right by the DDS when it's driven by the FPGA, and also look at the DDS `SYNC_OUT`. Put both on a scope on persist and leave for a few minutes. That might show something up.

What do you think?

marmeladapk, 2019-05-17:
@hartytp I ran test from artiq and waited for signal on SYNC_IN. Then I measured with scope and with SSA signals on sync_in, after clock fanout (just to check) and on EEM connector. Screenshots are here https://github.com/sinara-hw/Urukul/issues/16#issuecomment-483627251

I wanted to measure the signal that was problematic during the test.I didn't look with hte persist mode.

hartytp, 2019-05-17:
@marmeladapk thanks. Well, I'm a bit baffled as to what this could be. My only thought is that maybe there are infrequent glitches on the EEM SYNC, which wouldn't have shown up on the tests you did.

Please can you do this one test:
- On a scope simultaneously measure the `SYNC_OUT`, `SYNC_IN` (differential), and DDS clock
- Leave that on persist for a while
- do this for each SYNC source

As I said, my only thought is that maybe the FPGA has infrequent glitches or something that kill the SYNC window without contributing much noise power. That test should show it up. If not, I have no idea what the issue is (DDS configuration?).

any other ideas @jordens ?

jordens, 2019-05-17:
As at the top it's not infrequent. A few dozen µs are already sufficient. I would also compare with using SYNC_OUT and I would triple check common mode and differential signal levels as it looked like double windows sometimes (see above as well). @hartytp could you check the configuration?

hartytp, 2019-05-17:
@marmeladapk can you have a go at the measurements? I'll check the AD9910 software configuration when I have a minute.

hartytp, 2019-05-26:
@marmeladapk do you think you’ll have time to do that measurement this week? I’d like to finalise the next version of Urukul soon, but would like to do this first

hartytp, 2019-05-28:
@marmelada if/when you do look at this please try to get as many interesting signals on the scope at once as possible (e.g. FPGA SYNC, DDS SYNC_OUT, REF CLK, etc) also please get a ms or so on persist to check for glitches.

marmeladapk, 2019-05-29:
@hartytp I've got 4 channels on my scope, 3 are taken by SYNC_OUT, SYNC_IN, and DDS clock. Sync out seems to be disabled. I use test_ad9910 script. How can I change SYNC source in it?

marmeladapk, 2019-05-29:
@jordens No, it's not.

dnadlinger, 2019-05-29:
@marmeladapk: Also see
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

Thread 17 (2018-11-13):

consistent LED sizes

jordens, 2018-11-13:
The front panel LEDs on Urukul are larger than all the others boards AFAICT. I am OK with Kasli being an exception in LED size, mounting and location (for space reasons). But Urukul should get LEDs similar in size to those on the other boards.

gkasprow, 2018-11-13:
We should definitely standardize aesthetics of the modules. So I fully agree.
The front panels are made for each revision anyway so there won't be any cost issues.

jordens, 2019-04-16:
I really like the edge emitting LEDs on the PCB bottom (Kasli, Humpback). That's an excellent use of space, they are surface mount, high density.

gkasprow, 2019-04-17:
The only drawback is aesthetics. LEDs are visible from a very narrow angle. There are miniature 1mm light pipes that can be inserted to the holes in the panel so the user experience would be much better.

jordens, 2019-04-17:
Yes. If those light pipes could be press fit into the panel that would be great.

gkasprow, 2019-08-16:
replaced with LED_DIALIGHT_571-0112F

Closed 2019-08-16.

Thread 18 (2018-11-23):

crystal oscillator availability

gkasprow, 2018-11-23:
@hartytp @jordens The lead time for CCHD-950-25-100.000  is 8 weeks or more.
What if we add assembly option for CCHD-950-25-100.000 and mount VCXO VHD-950-100.000 instead. This needs voltage divider on control pin that sets 1.65V to get nominal frequency.
Is 50ppm frequency stability acceptable? If yes, we can mount CCHD-950-50-100.000.

jordens, 2018-11-23:
I think we could generally go to a slightly noisier crystal at the same accuracy level. E.g. in that smaller, more standard package. Probably easier and cheaper and if low noise and or high accuracy is needed it would come from mmcx or sma anyway.

hartytp, 2018-11-23:
I'd be fine with using a different oscillator with worse performance but better availability.

gkasprow, 2018-11-23:
OK, we will add it in ext revision, here will mount 50ppm oscillators.

jordens, 2018-11-24:
Or the B grade of the Si510 like the one we use on Kasli.

gkasprow, 2019-08-16:
added both resistive divider and Si510 3V3 30ppm footprint DNP by default

gkasprow, 2021-04-21:
I found by chance perfect [replacement](https://www.taitien.com/wp-content/uploads/2019/07/XO-0171_VLEU.pdf) for Crystek oscillators

Closed 2019-08-16.

Thread 19 (2018-12-17):

pull OSK high

jordens, 2018-12-17:
The ASF register is currently useless in Urukul. The OSK pin is pulled low and thus in manual mode ASF will be zero, and in automatic mode it will always ramp down. The ASF register is a nice feature for RAM operation.
Let's pull OSK high in the next revision. I can't see a downside to it.

jordens, 2018-12-17:
Currently for FTW or POW RAM mode the only possible ASF is full scale.

gkasprow, 2019-08-16:
I pulled it up to P3V3_DVDD_IO

Closed 2019-08-16.

Thread 20 (2018-12-18):

oscillation on P7V5A, P7V0A

jordens, 2018-12-18:
I am seeing an unexpected oscillation on Urukul-AD9910/v1.3 on both the P7V5 and P7V0 rails.
About 80mV peak-peak ~120 kHz, almost sinusoidal, few overtones.
Easily visible before and after the RF amplifier chokes and on the output as -60dBc sidebands.
This isn't there on Urukul-AD9912/v1.0 and Urukul-AD9910/v1.0 at all, independent of 12 V power supply and wiring.
Any ideas @gkasprow ?

* P7V5 switcher IC22 has max output of 6 V
* IC22 VOS has 7 V abs max rating
* IC22 VOS clamps to 7.4 V
* P7V0A LDO needs at least 300 mV guaranteed headroom and sufficient bypassing

Workaround:

* lower P7V5 to 7 V, lower P7V0A to 6.5 V: R134=43.2k, R133=39.2k (both 1% E96)
* ensure P7V0A has at least 6.8 µF low-ESR bypass.

gkasprow, 2018-12-18:
can you check if it is before the L5? Does it have higher amplitude there?
It's quite possible that converter gets unstable, but It's surprisingly high frequency. DC/DC works a 1MHz.

gkasprow, 2018-12-18:
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

jordens, 2018-12-18:
IIRC I checked that side of L5 as well and there was no 100 kHz oscillation there. I would also expect that the LDO between P7V5 P7V0 attenuates the oscillation but it doesn't.

gkasprow, 2018-12-18:
It's also posible that power stage has some I=f(U) area that behaves like negative resistance and causes oscillation together with L5 and C183. Did you check outputs of IC5?

jordens, 2018-12-18:
Yes. As I mentioned there is oscillation at the RF output (after the choke), but less pronounced than on the LDO side of the choke.

gkasprow, 2018-12-18:
Are U sure these oscillations are not present at the input of the amplifier

jordens, 2018-12-18:
RF input? I didn't check that since this happens wihout any RF and upstream of the RF amplifier there isn't much else going on that I would suspect. But will check.

jordens, 2018-12-18:
I'll poke around tomorrow. I'll also check on another Urukul-AD9912/v1.1 (or v1.2) and another AD9910/v1.3.

jordens, 2018-12-19:
There seem to be a couple of major problems:

* The TPS62175DQC only supports 6V output max. We have 7.5 V
* The output voltage is typically around 7.25 V but changes with tolerances. Was that not measured when doing the initial testing last year?
* 250 mV is insufficient headroom for the 7V LDO which needs that at 150 mA (nominal current) but tolerances on the dividers shrink the available headroom.

gkasprow, 2018-12-19:
I remember that I measured that voltage and it was fine. But we work outside of specification so it may strongly depend on chip series.
Quick fix would be lowering the LDO voltage. It should not make big change to power stage if we operate it with 7 or 6.5V but big change to LDO.
If the LDO operates at the edge of its dropout voltage, it's not a big surprise to observe it oscillating.

gkasprow, 2018-12-19:
We use same DC/DC chip on Sampler, but there we have 6V so within spec.

jordens, 2018-12-19:
Even one of the first ones from last year (Urukul-AD9912/v1.0) has ~7.25 V on P7V5 at the switcher, ~6.95 V on P7V5, and a LDO dropout of 260 mV. Maybe the switcher has degraded over time. If the switcher circuit is the problem, then lowering the P7V0 might just mask it.

jordens, 2018-12-19:
"As a safety feature, the device clamps the output voltage at the VOS pin to typically 7.4 V, if the FB pin gets opened."

The proper fix is to stay well clear of that (e.g. 7 v) but also lower the p7v0 rail (to 6.5v).

jordens, 2018-12-19:
VOS is also 7 V Abs max Rating.

hartytp, 2018-12-19:
Good catches @jordens

jordens, 2019-01-07:
@gkasprow Some oscillation is still there even with the setpoints changed to P7V5=6.9V and P7V0=6.4V. It is only on P7V5A and P7V0A, not P7V5 and P5V0A. About 120 kHz, roughly sinusoidal but slightly asymmetric rise and fall, 80mV pk-pk. And It has opposite sign on P7V5A than on P7V0A (i.e. accross IC21). If I bypass L5 it becomes smaller on P7V5A (=P7V5 then) but doesn't change on P7V0A.
If I lower P7V0A even further it doesn't change. Ideas?

gkasprow, 2019-01-07:
try to get rid of C175 or lower it to 100pF

Datasheet says "Bypass  capacitors,  used  to  decouple
individual  components  powered  by  the  LT1763-X,  will
increase the effective output capacitor value. With larger
capacitors  used  to  bypass  the  reference  (for  low  noise
operation), larger values of output capacitors are needed.
For 100pF of bypass capacitance, 4.7μF of output capaci
tor is recommended. With a 1000pF bypass capacitor or
larger, a 6.8μF output capacitor is recommended"

jordens, 2019-01-08:
100 pF does not oscillate. 1 nF oscillates. From the 22µF Tantal + 5x100nF + 4x1µF ceramic output bypass I don't see how that can happen.

jordens, 2019-01-08:
But IME not more than the 3 Ohm the datasheet mentions.

gkasprow, 2019-01-08:
true.

hartytp, 2019-01-08:
@gkasprow do you know which part numbers TechnoSystem used for the decoupling capacitors?

hartytp, 2019-01-08:
I can believe that cheap 1uF ceramics could have quite low capacitance when biased to 7V. If the tantalum they used has a high ESR/ESL as well then that would explain this.

hartytp, 2019-01-08:
@gkasprow the TPSB226K010R0700 capacitor you've used as an example for the 22uF decoupling capacitor is only 10V, with a category voltage of 7V. That seems a bit marginal, doesn't it? Won't be good for board lifetime.

jordens, 2019-01-08:
That's still only about 1e-6 failures per 1e3 hours at 50C.

jordens, 2019-01-08:
And the Tantalum cap has 0.7 Ohm ESR.

hartytp, 2019-01-08:
> And the Tantalum cap has 0.7 Ohm ESR.

It's generic in the BOM isn't it? The part above is only an example, AFAICT they are free to substitute it if they wish.

hartytp, 2019-01-08:
> That's still only about 1e-6 failures per 1e3 hours at 50C.

The references I'd seen suggested it would be somewhat worse than that, but yes, the failure rate will still be low. My comment wasn't meant to imply that this is the cause of the oscillations, just that it's a bit more marginal than I would have liked.

hartytp, 2019-01-13:
My best guess for this is that it's the 3x1uF ceramics causing oscillations. If we ignore the 22uF tantalum (ESR/ESL too high compared with the ceramics so doesn't contribute) then we would have 3uF total capacitance with very low ESR. From the data sheet, that's clearly in the unstable regime.

@jordens can you try adding a 4u7 ceramic near the LDO output and see if that stabilizes the LDO. Otherwise, @gkasprow is it worth simulating the circuit in LTSpice to check for stability?

jordens, 2019-01-13:
It's 4.5 µF ceramics and the Tantalum needs to have high ESR (> 3 Ohm) to not contribute. Not clear at all.
I have modified all affected boards already.

hartytp, 2019-01-13:
ack. @gkasprow can you ask a student to look at this? We should aim to fix this issue before producing any more boards. AFAICT Mirny uses the same supplies so will have the same bug unless we track it down.

gkasprow, 2019-01-13:
I sketched such circuit
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

gkasprow, 2019-01-13:
And I do not see big difference whether Cbyp is 100pF or 10nF
With C=100p
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
With 10nF
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

gkasprow, 2019-01-13:
2u cap has 1mOhm ESR, 10u cap ha 0.7 Ohm ESR. Vin = 7.4V Load pulse is 100mA

klickverbot, 2019-01-13:
> all affected boards

Are these all your 1.3 boards, or only a subset?

jordens, 2019-01-14:
Every board I looked at.

gkasprow, 2019-01-27:
I plan to replace the TPS62175 with [NCP3170](https://www.onsemi.com/pub/Collateral/NCP3170-D.PDF) which already use in many designs. Another option is [LMR36015](http://www.ti.com/product/LMR36015).
The main requirement is continuous operation (no sleep or pulse skipping mode) and PG output.

hartytp, 2019-01-27:
@gkasprow will you have a look at the LDO output at the same time? My guess is that a 22uF ceramic will fix the oscillation (or a FB to decouple the LDO from the ceramics).

If we're going to produce a new hw revision then it's worth looking at the other outstanding issues at the same time, particularly https://github.com/sinara-hw/Urukul/issues/16

gkasprow, 2019-01-27:
We observe similar issues on AFCZ board with Exar converter. After some time one of the supplies switches off on all boards.

hartytp, 2019-01-28:
Ouch! So...how to we make sure this does not happen on Sayma 2? Scrap the exar? Better caps? More careful loop tuning? Whatever we do I don’t want to have to deal with converter instabilities any more :)

sbourdeauducq, 2019-01-28:
@gkasprow @hartytp I suppose you want to discuss this in https://github.com/sinara-hw/sinara/issues/567

hartytp, 2019-01-28:
@gkasprow Once this is fixed we should also add a note to the wiki with a change list that users can apply to their boards to fix/work around this issue.

gkasprow, 2019-08-16:
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

hartytp, 2019-08-16:
NB looking again at the current Urukul design, there are other issues around IC22. E.g. the abs max rating for the sleep pin is 7V, however it's driven from the 7V5 output. As there is no current limiting resistor that's probably destructive.

hartytp, 2019-08-16:
@gkasprow the regulator PN recommends an effective output capacitance of 47uF with FSEL low. I'd guess that with a 7V5 bias that 22uF capacitor will be a bit on the small side, can we beef it up please?

hartytp, 2019-08-16:
Other than that, assuming all capacitors have sensible voltage ratings, LGTM.

hartytp, 2019-08-16:
Actually, one other thing: I'm still not totally comfortable with the situation re the LT1763. It seems odd to me that we're saying that we can't get it to work with the data sheet recommendation of 10nF bypass capacitor. My guess is that fiddling with that capacitor is masking some other problem

gkasprow, 2019-08-16:
@hartytp  I replaced IC22 with TPS62148 which works up to 12V at its output. True, the DS says we should use 47uF so I added another 22uF cap.

hartytp, 2019-08-27:
> Actually, one other thing: I'm still not totally comfortable with the situation re the LT1763. It seems odd to me that we're saying that we can't get it to work with the data sheet recommendation of 10nF bypass capacitor. My guess is that fiddling with that capacitor is masking some other problem

@gkasprow any thoughts about this?

hartytp, 2019-08-27:
Should we just switch IC21 to a different regulator that's a bit less fussy? Any reason not to just go for the same LT3045 that we use everywhere else?

gkasprow, 2019-08-29:
Replaced IC21 with LT3045.
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

hartytp, 2019-08-29:
Thanks!

Closed 2019-08-29.

Thread 22 (2019-01-25):

PLL Timeout

samhile, 2019-01-25:
I cannot get a PLL lock with a new v1.3 Urukul using clk_sel=2 (MMCX), nor with clk_sel=0 (internal XO)

This board is successfully locking using clk_sel=1 and a 125MHz signal applied to the front SMA.

When I have an MMCX cable applied, I can probe the clock signal from Kasli on the reverse side of the Urukul board, so I'm confident the clock is arriving on the board.

I've seen comments that others have working v1.3 Urukul boards, so should I assume I have a faulty board? Any suggestions?

``

sbourdeauducq, 2019-01-25:
What ARTIQ version?

jordens, 2019-01-25:
And what urukul cpld firmware version?

tballance, 2019-01-26:
@sbourdeauducq Thanks. I can't check the commits we were using right now, but IIRC this was present on release-4 as well. Could you link to the ARTIQ commit that fixed the issue (I can't figure out which one it is)?

sbourdeauducq, 2019-01-26:
https://github.com/m-labs/artiq/commit/91e375ce6acd6b626b1040abefd1af7c1cdb9d63

tballance, 2019-01-26:
@sbourdeauducq Thanks, but I don't think that will solve our problem. This commit has to do with the AD9910, whereas our problem is a lot more basic: Our CPLD does not seem to drive MMCX_OSCn_SEL high when we instruct it to, so the clock never gets past the mux.
I think there are two possible causes for our observation:
a) our kernel code is out of date and is not setting the second bit of CLK_SEL
b) out CPLD is flashed with an old version of the code

Unfortunately I can't check the artiq version we were using right now, but I guess a) is most likely our cause, and may be @samhile's cause too. Will update when tested.

mfe5003, 2019-01-26:
@sbourdeauducq Hi, this is following up on @tballance's comment.  We are on release 4 with different versions of the software and gateware. Looking at the diff I don't think this should be a problem.
https://github.com/m-labs/artiq/compare/0ec01790fe8c75730bb534756804a16189b0d25f...5b2e7cb7f38b7fe4f6711ca3e3ab9c338f34466a

`$ artiq_run dds_test.py
WARNING:artiq.coredevice.comm_kernel:Mismatch between gateware (4.0+25.g5b2e7cb7) and software (4.0+21.g0ec01790) versions`

The clock select changes in `artiq/coredevice/urukul.py` appear in my local repo, so unless there were further changes made or I am missing something, it is looking like:
> b) out CPLD is flashed with an old version of the code

is the cause.  The fix will require some time since I don't have a programmer right now, but I can try switching to one of the other oscillators.

samhile, 2019-01-28:
@sbourdeauducq I am working with ARTIQ release-4 (commit 1555fcf4 from 23 Jan, after the fix you're talking about).
Gateware is compiled from 1555fcf4 too.

@jordens As for the CPLD version, it looks to me like 8

        u_status = self.urukul0_cpld.sta_read()
        print('SW',urukul_sta_rf_sw(u_status))
        print('SMP',urukul_sta_smp_err(u_status))
        print('PLL',urukul_sta_pll_lock(u_status))
        print('IFC',urukul_sta_ifc_mode(u_status))
        print('PROTO',urukul_sta_proto_rev(u_status))

this outputs:

        INFO:worker(2141,urukul_test.py):print:SW 0
        INFO:worker(2141,urukul_test.py):print:SMP 0
        INFO:worker(2141,urukul_test.py):print:PLL 0
        INFO:worker(2141,urukul_test.py):print:IFC 5
        INFO:worker(2141,urukul_test.py):print:PROTO 8

samhile, 2019-01-28:
ah, hang on - 91e375ce isn't on the release-4 branch

samhile, 2019-01-28:
@jordens are you saying that proto_rev 8 is not correct for the v1.3 board?
Its a recent order from Technosystem. Can you point me to instructions on how to flash and configure the CPLD?

jordens, 2019-01-28:
Technosystem makes boards. They don't contribute or participate directly.
https://github.com/quartiq/urukul is the CPLD code.

Closed 2019-01-28.

Thread 24 (2019-04-08):

SMA stackup wrong, SMA cables loose

Jochenwolf3, 2019-04-08:
Using standard SMA cables (e.g. JP1XJP1XF316-40 from Gigatronix), there is not enough exposed threading to put the SMA cables on. The plastic washer, tooth washer, and nut take up so much space on the thread that upon tightening the SMA cable nut, the cable still feels loose and can be wiggled around, indicating an unreliable connection:

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

An extra ~3 mm of SMA threading is needed.

Workaround: remove the plastic washer from the stack, which creates just about enough space (and is fine for people who do not want their SMAs floated anyway)

Jochenwolf3, 2019-04-08:
This applies to Urukuls manufactured by both Creotech and Technosystem.

gkasprow, 2019-07-01:
One option is to switch to longer SMA connectors like Telegartner J01151A0921. But they are very long.
They are also far more expensive (30$/pc).
 I can also move the PCB edge to the panel by 1mm. This should solve the issue.

gkasprow, 2019-08-16:
I moved them by 1mm to the panel.

Closed 2019-08-16.

Thread 26 (2019-06-14):

Urukul v1.1 erata

hartytp, 2019-06-14:
- ~Add extra LC filtering on sensitive analog power supplies.~
- [x] Replace loop filter passives with optimised values (AD9910 only):
  - C112 - DNP
  - R90 - 3.3k
  - R92 - 0Ohm
  - C99 - 68pF
  - C72 - DNP
- [x] Connect IC7 p 10 to P5V0, it was fixed in two other regulators but not in the IC7.

Closed 2019-06-14.

Thread 27 (2019-06-14):

Urukul float SMAs

hartytp, 2019-06-14:
- [ ] For Urukul, should we float the SMAs (clock input and RF outputs) by changing 0R resistors to 100k resistors.

AFAICT, this is what one generally wants. IIRC, our only only reason for not doing it originally was that we didn't want to bother fitting insulating washers. As we're now doing that, it seems that we should just float the grounds. This only requires a minor alteration to the BOM.

Closed 2019-06-14.

Thread 28 (2019-06-14):

Urukul LDO PSRR

hartytp, 2019-06-14:
@gkasprow Looking at figure 11 of the TPS74901 datasheet, the PSRR of regulators IC7, IC11 and IC18 is very low with a dropout voltage of 0.2V. Can we change the outputs of IC15 to give an extra couple of hundred mV headroom on these LDOs?

Edit: this is probably also a problem for clocker...

Closed 2019-06-14.

Thread 29 (2019-07-04):

Test data for Urukul

TheCakeIsAPi, 2019-07-04:
I took some detailed test data to measure power levels and harmonics.  I think it may be useful to others.  I suggest creating a place on the Wiki to catalog this and other such data for each piece sinara-hw.

---

Readings for urukul0_ch0, AD9910 model, Urukul v1.3, s/n TS 92/19 0027, with 125 MHz external clock from Wenzel 501-31911, via Mini-Circuits ZB4PD-52-20W-S+ power splitter, measured on Keysight N9343C (which only has spec'd response from 1 MHz to 13.6 GHz).  Attenuation and reference level of the N9343C were set to minimum levels that support each measurement.  All readings were allowed to average until stabilized to +/-0.05 dBm

At attenuation = 0.0 dB

Setpoint [MHz] | Fundamental [dBm] | 1st [dBm] | 2nd [dBm] | 3rd [dBm] | 4th [dBm] | 5th [dBm] | 6th [dBm] | 7th [dBm] | 8th [dBm]
-- | -- | -- | -- | -- | -- | -- | -- | -- | --
0.1 | -21.14 | -59.03 | -54.93 | -93.07 | -73.38 | -94.07 | -84.78 | -91.77 | -96.61
0.5 | 4.51 | -15.45 | -11.61 | -25.02 | -24.35 | -51.70 | -35.14 | -34.46 | -37.85
1 | 7.67 | -16.80 | -12.32 | -18.27 | -29.25 | -30.87 | -34.51 | -39.28 | -39.84
10 | 10.67 | -12.69 | -13.94 | -26.12 | -27.76 | -36.11 | -55.32 | -43.85 | -42.65
20 | 10.86 | -24.90 | -13.65 | -22.87 | -28.67 | -47.68 | -35.85 | -35.45 | -38.48
50 | 10.74 | -14.18 | -15.01 | -27.57 | -29.01 | -38.05 | -51.52 | -44.53 | -42.71
100 | 9.70 | -33.59 | -16.72 | -34.36 | -26.81 | -40.14 | -41.07 | -43.88 | -56.89
200 | 8.97 | -22.22 | -16.23 | -24.89 | -30.49 | -37.97 | -37.79 | -38.80 | -40.14
300 | 8.27 | -19.17 | -19.51 | -29.80 | -34.75 | -38.90 | -51.92 | -53.38 | -57.95
400 | 7.68 | -17.82 | -21.60 | -33.04 | -37.80 | -50.37 | -57.45 | -59.80 | -64.68
500 | -1.80 | -41.57 | -51.71 | -72.36 | -89.35 | -91.63 | -93.15 | -84.54 | -107.57

At attenuation = 10.0 dB

Setpoint [MHz] | Fundamental [dBm] | 1st [dBm] | 2nd [dBm] | 3rd [dBm] | 4th [dBm] | 5th [dBm] | 6th [dBm] | 7th [dBm] | 8th [dBm]
-- | -- | -- | -- | -- | -- | -- | -- | -- | --
0.1 | -27.06 | -81.35 | -62.09 | -97.37 | -84.11 | -103.78 | -91.37 | -100.48 | -104.22
0.5 | -3.2 | -37.82 | -52.21 | -66.76 | -77.86 | -85.92 | -86.37 | -97.59 | -120.76
1 | -0.43 | -34.47 | -47.80 | -75.28 | -86.45 | -101.91 | -93.22 | -96.14 | -106.71
10 | 1.95 | -31.04 | -28.23 | -51.76 | -57.29 | -76.26 | -78.15 | -83.85 | -80.20
20 | 2.10 | -33.05 | -28.30 | -54.50 | -52.31 | -72.39 | -70.96 | -82.98 | -82.58
50 | 1.89 | -33.24 | -28.50 | -52.67 | -48.35 | -74.77 | -77.26 | -79.33 | -73.58
100 | 0.80 | -38.51 | -63.22 | -61.73 | -71.97 | -97.45 | -97.67 | -107.40 | -93.03
200 | 0.05 | -38.25 | -42.16 | -63.01 | -84.55 | -82.66 | -108.85 | -116.62 | -99.45
300 | -0.51 | -35.91 | -48.83 | -82.43 | -100.53 | -111.79 | -118.62 | -120.05 | -97.72
400 | -1.20 | -38.37 | -49.77 | -89.45 | -74.66 | -108.12 | -116.75 | -114.08 | -102.29
500 | -11.20 | -61.47 | -77.59 | -74.73 | -100.23 | -93.12 | -99.83 | -86.71 | -112.63

At attenuation = 20.0 dB

Setpoint [MHz] | Fundamental [dBm] | 1st [dBm] | 2nd [dBm] | 3rd [dBm] | 4th [dBm] | 5th [dBm] | 6th [dBm] | 7th [dBm] | 8th [dBm]
-- | -- | -- | -- | -- | -- | -- | -- | -- | --
0.1 | -31.06 | -82.29 | -68.34 | -109.04 | -92.48 | -111.23 | -99.94 | -109.85 | -112.36
0.5 | -11.99 | -56.69 | -71.73 | -95.76 | -101.86 | -114.37 | -102.81 | -106.94 | -116.72
1 | -9.94 | -54.54 | -56.49 | -89.12 | -105.94 | -110.93 | -102.79 | -107.01 | -117.29
10 | -7.89 | -50.19 | -57.35 | -91.36 | -97.88 | -107.95 | -103.53 | -96.04 | -108.26
20 | -7.79 | -52.72 | -58.03 | -90.75 | -99.82 | -102.07 | -101.55 | -104.73 | -103.31
50 | -7.96 | -52.36 | -59.26 | -84.44 | -87.55 | -86.88 | -97.76 | -92.61 | -83.19
100 | -9.04 | -57.40 | -61.76 | -78.50 | -91.80 | -117.64 | -107.40 | -112.64 | -102.07
200 | -9.73 | -57.39 | -72.31 | -72.66 | -93.26 | -95.95 | -125.22 | -122.35 | -130.24
300 | -10.27 | -58.65 | -74.60 | -109.24 | -107.74 | -115.75 | -125.36 | -124.54 | -98.86
400 | -10.94 | -59.62 | -79.36 | -98.48 | -74.72 | -111.95 | -119.18 | -114.63 | -104.34
500 | -21.00 | -78.52 | -99.07 | -74.91 | -99.55 | -92.91 | -103.02 | -87.33 | -114.87

At attenuation = 31.5 dB

Setpoint [MHz] | Fundamental [dBm] | 1st [dBm] | 2nd [dBm] | 3rd [dBm] | 4th [dBm] | 5th [dBm] | 6th [dBm] | 7th [dBm] | 8th [dBm]
-- | -- | -- | -- | -- | -- | -- | -- | -- | --
0.1 | -37.89 | -85.04 | -77.41 | -122.04 | -114.29 | -115.58 | -110.65 | -120.06 | -123.70
0.5 | -22.38 | -71.24 | -89.84 | -107.81 | -108.76 | -127.83 | -114.12 | -118.34 | -127.07
1 | -21.01 | -72.10 | -90.08 | -111.97 | -111.30 | -127.43 | -114.38 | -118.07 | -128.06
10 | -19.22 | -72.13 | -90.74 | -110.14 | -105.28 | -114.04 | -113.51 | -94.85 | -116.15
20 | -19.28 | -75.95 | -94.72 | -91.71 | -107.55 | -112.85 | -112.24 | -116.33 | -114.02
50 | -19.27 | -74.93 | -92.21 | -95.77 | -101.06 | -97.92 | -108.30 | -103.60 | -93.96
100 | -20.27 | -79.05 | -87.48 | -89.73 | -104.00 | -117.98 | -112.12 | -110.51 | -105.80
200 | -21.19 | -78.33 | -106.81 | -82.70 | -92.31 | -109.93 | -133.86 | -120.94 | -102.95
300 | -21.58 | -80.96 | -112.44 | -110.40 | -108.11 | -115.68 | -122.51 | -125.25 | -99.63
400 | -22.44 | -82.73 | -105.55 | -98.03 | -74.84 | -113.93 | -119.41 | -114.93 | -104.55
500 | -31.73 | -93.37 | -99.74 | -75.03 | -99.27 | -92.84 | -104.14 | -87.46 | -116.22

sbourdeauducq, 2019-07-04:
Thanks!

jordens, 2019-07-04:
With "1st" you mean the first overtone but the second harmonic, right?

TheCakeIsAPi, 2019-07-05:
@jordens yes.  Fundamental = setpoint.  1st = 2 x setpoint.  2nd = 3 x setpoint.  Sorry if that was unclear.  I did also see some other peaks that were on occasion bigger than the nearby harmonics, but I couldn't think of a decent way to tabularize that, so those are not recorded here.

dhslichter, 2019-07-05:
Thanks for the data, @TheCakeIsAPi!

> I did also see some other peaks that were on occasion bigger than the nearby harmonics, but I couldn't think of a decent way to tabularize that, so those are not recorded here.

One way would be to have a column for "largest spur", so that people can see the spur-free dynamic range.  Another thing that might be nice (for a final table in a wiki) would be to convert the harmonics into dBc (relative to fundamental), to help save on the mental gymnastics of the doing the math each time.

jordens, 2019-07-24:
Some of the the data look suspicious to me. E.g.

* A -26.4 dBc third harmonic at 100 MHz, 0 dB is much worse than what I measured way back (AD9912 v1.0, -53.5 dBc third harmonic at 80 MHz, 0 dB).
* At 10 dB attenuation for 10, 20, 50 MHz the third harmonic is 20-35 dB worse than for both 1 or 100 MHz.
* At 0 dB attenuation the high harmonics of 400 MHz (2.8, 3.2, 3.6 GHz) at -57, -60, -65 dBm (w.r.t. 8 dBm fundamental).
* Many measurements appear to be the dynamic range/floor of the spectrum analyzer and not the power of the harmonics.

> Attenuation and reference level of the N9343C were set to minimum levels that support each measurement

Minimizing input attenuation (below the typical/automatic `min(0 dBm, ref_level) + 10 dB`) in spectrum analyzers is risky. Sure you didn't create harmonics yourself?

Closed 2019-08-27.

Thread 30 (2019-07-15):

redo CPLD wiring

jordens, 2019-07-15:
Redo the CPLD wiring to avoid pitfalls, decouple the channels, remove hidden state, and improve interoperability with the different software modes.

* PROFILE should be per-channel (+9) c.f. m-labs/artiq#1187
* Attenuator access should be per-channel (CS/LE) (+3 for CS/LE, +3 for MISO)
* OSK is useful if per-channel (+4) c.f. #19
* DRCTL is useful if per-channel (+4)
* add hardware revision resistors (let's say +2)
* maybe DRHOLD+DROVER (up to +8)

Compensate pin usage (+25) with (up to -35 available):

* Share Master_RESET and DDS_RESET (-1)
* DDS_SYNC_CLK0 (-1)
* shrink IFC_MODE (let's say -2, one needed for SU-SERVO, one reserved for future)
* fewer test points (up to -3), instead add testpoints for SPI buses and SYNC/SYNCCLK
* bind OSC_ENn to MMCX_OSC_SEL (see Mirny) (-1)
* Use shared MOSI/SCK for DDS (-6)
* bind green LED to RF switch (-4)
* fix FSEN (-1)
* fix the configurable EEM LVDS direction RE_DE (up to -16)

tballance, 2019-08-07:
+1 for pinning out the profile pins. This would be really useful for us.
When the CPLD code is being revisited, I think it would also be useful to add more detailed version and build info which can be read out through the SPI interface.

gkasprow, 2019-08-08:
we can also use a bigger BGA256 package and route all pins without any compromises.
Don't we want more CPLD resources?

jordens, 2019-08-08:
Right. A small fpga with lvds would make the 4 lvds cmos converters redundant as well. Might be worth it.

gkasprow, 2019-08-08:
FPGAs have usually much higher pin to pin delays than CPLDs and higher jitter. And it is much more complex modification than just replacement of the CPLD.

jordens, 2019-08-08:
Sure. Just pointing out the option.
A BGA CPLD with a bit more resources would be nice to alleviate the pin and resource constraints.

tballance, 2019-08-08:
From a control perspective, it seems to me that it would be nice to expand the CPLD shift register to include some bits for addressing. This would allow us to read out more detailed version info (like a human-readable build string) and also expand the ability to operate in different modes.
A mode that could be useful for us would allow us to control the profile pin switches from a fifo in the CPLD which is programmed through SPI writes and clocked out with a strobe pulse from the EEM interface. This would enable us to make bursts of fast switches (<1us) between profiles which would not be achievable through SPI writes alone.
Also nice would be to have the CPLD interface backwards compatible, in that it boots in 'legacy mode' and can be switched (through a write sequence) to the expanded mode if the proto_rev version is above a threshold. From a user perspective I think this would be nice, as many people will have mixed hardware and making it 'plug-and-play' will hopefully reduce the number of issues about hardware not working.

gkasprow, 2019-08-16:
@jordens do you think adding I2C to SPI -> JTAG converter would be useful as it is in case of the Banker?

jordens, 2019-08-16:
To jtag the cpld over i2c? Probably not that high value in practice. And part of the tooling is missing.

gkasprow, 2019-08-18:
@jordens please review the CPLD signal assignments
https://github.com/sinara-hw/Urukul/releases/tag/v1.4rc1

jordens, 2019-08-19:
I'm on vacation until the end of the week. Will review then.

jordens, 2019-08-26:
@tballance These are all nice ideas. Some of them is (like the multiple registers and the addressable SPI switch) is planned/implemented in Mirny and looking for funding (https://github.com/quartiq/mirny/issues/1). The same would apply to these features and the gateware/software for Urukul v1.4.

jordens, 2019-08-26:
@gkasprow I looked at the schematic and ported the current gateware.

* Could you split the FSEN signal between the EEM0 and EEM1 port? Since it introduces an imbalance, and since we only ever support leaving EEM1 open, it makes sense to treat them differently and force EEM0 to be always non-fail-safe but with more symmetric thresholds while EEM1 can be fail safe but asymmetric. NB: This doesn't affect the SYNC duty cycle asymmetry as that signal doesn't go through those converters.
* `Profile_P1` `ATT_S_IN`, `ATT_S_OUT`, `ATT_LE` don't exist anymore
* Looks good otherwise.

gkasprow, 2019-08-29:
done

Closed 2019-08-29.

Thread 31 (2019-08-16):

v1.4 changelog

gkasprow, 2019-08-16:
- changed TPS62175DQC to TPS62148RGX (#20)
- C175 10nF ->100pF (#20 )
- pulled OSK to  P3V3_DVDD_IO
- added Si510 footprint DNP by default (#18)
- added CVHD950 oscillator Vctrl input pin divider. It may be needed when VCXO oscillator is installed in case of poor availability of the standard part. (#18)
- added mounting holes for CPCIS adapter
- replaced front panel LEDs with LED_DIALIGHT_571-0112F
- SMA connectors moved 1mm to the panel
- R87 : 1k8 -> 160R to satisfy IC18 requirement. P2V0 -> P2V1
- changed IC21 to LT3045
- added 9910 and 9912 panel design files

hartytp, 2019-08-16:
I did a basic design review of all ICs on Urukul focussing on:
- abs max ratings
- typical application circuits
- recommended capacitors
- skim of important device parameters like drop out voltages

didn't see anything other than the reported issues. NB didn't look at overall design or info not on the schematic (capacitor voltage ratings etc)

hartytp, 2019-08-18:
Great, thanks for doing all that! @gkasprow can you confirm that all open issues marked with a v1.4 milestone are now complete (I just did some tagging, so please re-check). If so, great!

hartytp, 2019-08-27:
@gkasprow from a quick look, it seems that a few of these issues still aren't fixed. I'm keen to get v1.4 off to manufacture asap. Can you have a go at fixing them and then upload a new rc? Thanks!

hartytp, 2019-08-29:
@gkasprow ping...what's the timeline for the next Urukul revision

gkasprow, 2019-08-29:
I'm still out of the office but I'm slowly working on it.
I will be back in 4 days.

hartytp, 2019-08-29:
That's fine, we can wait a few more days (enjoy your holiday!). Thanks for the update.

gkasprow, 2019-08-29:
done.

hartytp, 2019-08-29:
> added CVHD950 oscillator Vctrl input pin divider. It may be needed when VCXO oscillator is installed in case of poor availability of the standard part. (#18)

Remind me why we'd ever want a VCXO and not an XO?

hartytp, 2019-08-29:
I've reviewed the schematics. Other than #33 I don't see any issues.

Once you've fixed that and @jordens has signed off, let's send these cards to order (we have a Creotech order that's been blocked by this release for quite a while).

gkasprow, 2019-08-29:
We don't need VCXO. It is just in case we use VCXO due to poor availability of XO

hartytp, 2019-08-29:
Ok

hartytp, 2019-08-29:
Oh and can you add the dds pn to the panel? Then I think we’re good to go

hartytp, 2019-09-01:
Thanks @gkasprow!

Assuming @jordens is happy to sign off, let’s send this off to manufacture

gkasprow, 2019-09-01:
I'm just checking with PI simulations if everything is fine.

gkasprow, 2019-09-01:
It looks like I didn't break anything related to power delivery network.

gkasprow, 2019-09-01:
I drafted the new [release](https://github.com/sinara-hw/Urukul/releases/tag/v1.4rc3). Please have a look at the panels.

hartytp, 2019-09-02:
ping @jordens

jordens, 2019-09-02:
I'm ok with the changes as described and did a test-port of the CPLD gateware. But I didn't review anything else.

hartytp, 2019-09-02:
Okay, I've reviewed everything apart from the CPLD changes. So, if you've checked that then I'm happy to cut this release here.

Thanks all!

Closed 2019-09-02.

Thread 32 (2019-08-16):

Ic18 drop out

hartytp, 2019-08-16:
Are you definitely happy with the drop voltage for IC18? We don't quite hit the recommended 3.25V for Vbias-Vo (particularly when tolerances are accounted for) so it seems a bit marginal to me from the data sheet...

hartytp, 2019-08-16:
Well, maybe it's okay at the currents we're operating at?

gkasprow, 2019-08-16:
We can always switch to 7V5

gkasprow, 2019-08-16:
ah, max bias is 5.5V

gkasprow, 2019-08-16:
We can also slighty increase the 2V rail.

gkasprow, 2019-08-29:
I increased the P2V0 rail to P2V1 to satisfy Vbias requirements.

hartytp, 2019-08-29:
Sounds good. The small change in power efficiency is worth it to make sure the LDO functions as expected.

Did you make sure to update the power budget table?

gkasprow, 2019-08-29:
done
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

Closed 2019-08-29.

Thread 34 (2019-08-30):

Fixing Urukul v1.3, v1.2 defects

jbqubit, 2019-08-30:
What's the prospect for applying patches to existing Urukul v1.3 to fix the most important problems addressed in the v1.4 roll? There's many dozens of these boards in circulation. It would be nice to have a repair path that addresses the most critical bugs without replacing the boards.

From https://github.com/sinara-hw/Urukul/issues/31 v1.3 -> v1.4 the fixes are
- replace TPS62175DQC... is there a pin compatible replacement?
- C175 10nF ->100pF... easy patch
- pulled OSK to P3V3_DVDD_IO... easy patch
- R87 : 1k8 -> 160R... easy patch
- changed IC21 to LT3045... is there a pin compatible replacement?

I don't have a clear picture of the v1.2 -> v1.3 mods. What are the prospects for similar patching?

hartytp, 2019-08-30:
@jbqubit firstly, I'm going to close this since it's not really suitable for an "issue".

> What's the prospect for applying patches to existing Urukul v1.3 to fix the most important problems addressed in the v1.4 roll? There's many dozens of these boards in circulation. It would be nice to have a repair path that addresses the most critical bugs without replacing the boards.

The short answer is that this is very doable, but someone needs to organise it. Probably the easiest path is to email TechnoSystem/Creotech and discuss it with them. FWIW I don't have any plans to patch our boards any time soon (we don't have enough spare hardware to swap them out) and I'm not aware of anyone else planning to do it.

> From #31 v1.3 -> v1.4 the fixes are

I think that's a complete list, but if you want to be sure then you'll need to do some archaeology on the issue tracker I'm afraid (it's easy for changes to be left off the change list).

> I don't have a clear picture of the v1.2 -> v1.3 mods. What are the prospects for similar patching?

Again, without stating the obvious, the prospects are that this can happen if you or someone else put the time into organizing it. You'd need to go through the issues and figure out what the changes were, then figure out which if any patches were applied to your boards by hand after production (IIRC this wasn't really documented anywhere). Then contact TS or whoever you want to do the rework and arrange for it to be done.

This would all be easier if there were a bit more discipline about the work-flow in Sinara...

> replace TPS62175DQC... is there a pin compatible replacement?

The part itself needs to be replaced as it's been operated outside its abs max ratings and is most likely damaged (e.g. the PG transistor is probably gone so the sequencing won't work correctly which may or may not actually matter in practice). However, it does not necessarily need to be replaced with a different model -- IIRC you may be able to get away with just changing the set voltages on some of the rails See [here](https://github.com/sinara-hw/Urukul/issues/20). However, whoever is organizing this would need to think this fix through and check it's okay.

> C175 10nF ->100pF... easy patch
> changed IC21 to LT3045... is there a pin compatible replacement?

IIRC Changing the cap should be enough without swapping the LDO for a different PN. Again, see the discussion on the issue.

> pulled OSK to P3V3_DVDD_IO... easy patch

Not necessary unless you want to use that functionality. See the issue.

> R87 : 1k8 -> 160R... easy patch

I don't think this is strictly necessary, but sure, probably worth doing.

gkasprow, 2019-08-30:
v1.2 -> v1.3 main change was the addition of the clock mux.
But one needs to fix the oscillations by changing the RC values.
DC/DC converter and LDO can be left as they are. Even though the buck converter operates slightly outside its spec, it does not cause any problems. ICs are usually designed with some margin.
The same with R87 - if your board doesn't have a problem with 1V8 rail, don't change the resistor.

hartytp, 2019-08-30:
> v1.2 -> v1.3 main change was the addition of the clock mux.

Okay, well that's not required.

> DC/DC converter and LDO can be left as they are. Even though the buck converter operates slightly outside its spec, it does not cause any problems. ICs are usually designed with some margin.

IIRC the PG line was quite far outside its max ratings, and may well be damaged so I wouldn't be surprised if the power sequencing for that chip doesn't work. Having said that, small sequencing issues probably won't cause any harm.

gkasprow, 2019-08-30:
The absolute maximum rating for PG and VOS is 7V. We have 1k2 pullup to 7.5V. and IC22 VOS is 7.5V in our case.
So, the reduction of the IC22 output voltage to 7V and reduction of the IC21 voltage to let's say 6.5V solves the issue. The power stage will get a slightly lower voltage which will limit its max output power.

gkasprow, 2019-08-30:
Altium has a nice feature of document comparison.
Open v1.2 and 1.3 projects, then  Project -> show differences, then advanced mode, select an old version in the left panel, new version in the right panel and you will get a list with changes.
This function compares logical changes - it ignores cosmetics.
There is another function Project -> show physical differences that detects all changes, even cosmetical.
It must be done for every schematic page.
I compared v1.2 with v1.3 in this way. The only change was made in CLK_INPUT and Urukul schematic sheets:
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

gkasprow, 2019-08-30:
So, v1.2->v1.3 also added 0R resistors to ground floating connectors and front panel grounding.

hartytp, 2019-08-30:
> The absolute maximum rating for PG and VOS is 7V. We have 1k2 pullup to 7.5V. and IC22 VOS is 7.5V in our case.

Wasn't there also an issue with the max current being violated? Although, maybe that's fine as only a brief transient?

hartytp, 2019-08-30:
> Altium has a nice feature of document comparison.

I didn't know about that. That's a nice feature

jbqubit, 2019-09-03:
Thanks for the thorough replies! As suggested by @hartytp we can also add this to Wiki so users know what patches they might apply themselves (or send back to manufacturer for repair).

XXX == @gkasprow please give explicit list of component changes so that that Technosystem/Creotech can develop workflow.

# patches v1.3 -> v1.4

- TPS62175DQC
    - replace TPS62175DQC as it may be damaged
    - changes to prevent over voltage again XXX

- C175 : 10nF ->100pF

- R87 : 1k8 -> 160R

- IC22 : reduce output to 7.0 V -- XXX

- IC21 : reduce output to 6.5V --  XXX

# patches v1.2 -> v1.3
- Skip modifications related to clock mux. A patched v1.2 board should logically behave like a v1.2 board.

- add 0R resistors to ground floating connectors -- XXX

- add 0R resistors to front panel grounding -- XXX

hartytp, 2019-09-03:
> As suggested by @hartytp we can also add this to Wiki

? I didn't suggest that, but sure, go for it.

jbqubit, 2019-09-03:
> ? I didn't suggest that, but sure, go for it.

Github remembers the ghost of @hartytp past. :)

https://github.com/sinara-hw/Urukul/issues/20#issuecomment-458237420

hartytp, 2019-09-03:
fair enough. my memory for these things doesn't stretch back that far.

gkasprow, 2019-09-03:
@jbqubit U need to modify 2 additional resistors. I updated your post above

jbqubit, 2019-09-03:
Thanks @gkasprow!

>add 0R resistors to front panel grounding -- no pads foreseen for such option.

So a strap from accessible board ground to the front panel?

gkasprow, 2019-09-03:
Yes, you can do such a strap with a piece of wire.

jbqubit, 2019-09-03:
Thanks everyone. I've created an [Errata](https://github.com/sinara-hw/Urukul/wiki#errata) section of the wiki calling out these patches.

Closed 2019-08-30.

Thread 37 (2019-11-27):

phase lock application/flexible clocking

jordens, 2019-11-27:
Follow what transpires in sinara-hw/mirny#10 (through sinara-hw/mirny#22)
(MMCX for VCXO tuning and jumper to choose between the first stage mux and the second stage mux, even though that PFD frequency only works for AD9912)

hartytp, 2019-12-31:
At a minimum, (space permitting) I think we should add a DNPd MMCX along with a pads for an RCRC filter/attenuator to allow external tuning of the VCXO. Probably also best to add a diode to protect from negative voltages (e.g. I want to use the +-10V stabilizer DAC to tune the VCO).

However, I'm not sure how useful that will be in practice since ground loops will likely lead to lots of spurs on the output. Low frequency noise can be rejected by the feedback, but anything at kHz will make it through largely unattenuated in most applications.

So, again layout/space permitting, what about adding a unity-gain inamp here? Since we don't have a negative rail we'll make it single supply. Copy the EMI filter/protection (minus the CMC) from Sampler and choose a fixed-gain low noise InAmp that can run rail-rail from a single supply. Then have an attenuator + RC filter afterwards to match 0->10V into the VCXO with limited noise BW.

If we had a negative rail we could consider making it work with the full +-10V stabilizer output range, but we don't and it's not worth adding one just for this.

@gkasprow what do you think?

gkasprow, 2019-12-31:
Some OAs (i.e. LM358) work with inputs below GND, the gain would need to be <0.1 so it should be possible with a single supply. The oscillator tuning is usually referenced to 1/2 Vcc which makes it even simpler for diff amplifier configuration.

hartytp, 2019-12-31:
Sounds good. Let's go for something like that then.

gkasprow, 2020-02-19:
what about such circuit?
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

gkasprow, 2020-02-19:
version with opamp bypass
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

gkasprow, 2020-02-19:
let's make the opamp and MCX DNP by default

hartytp, 2020-02-19:
@gkasprow what about the flexible clock routing (0R jumpers to select whether each channel is driven by the output of the first or second mux?) is it too late to sneak that in?

hartytp, 2020-02-19:
@gkasprow as a basic circuit that looks like it should work (I’ll double check the resistor values later). I’d expect poor cmrr from that diff amp. Iirc there are some InAmps that can take inputs beyond their supply range which would do the job beautifully don’t have a pn to hand right now. A resistor ladder to make a precision differential input divider would also do the job I guess.

Nit picks:
- we could consider splitting the 10k resistor that biases the circuit from the 3V3 to make an RCR low pass filter.
- We could also put a small input cap to limit the bw/filter EMI

Both of those are low priorities. Would be nice to do something to improve the CMMR if we can but the current implementation should still be useful as is.

marmeladapk, 2020-02-19:
@hartytp We're sending this project to manufacturer right now, without including your nit picks since you said that they're low priority. (and right now we have the last chance to swap production files).

jordens, 2020-02-19:
@marmeladapk I [pointed out specifically](https://github.com/sinara-hw/Urukul/issues/45#issuecomment-587699998) yesterday that the clocking jumpers should not be omitted...

hartytp, 2020-02-24:
Closing and breaking out into two separate issues for clarity...

Closed 2020-02-24.

Thread 39 (2019-12-03):

pre-amp

hartytp, 2019-12-03:
Consider having a design variant (or just changing the main design) with a lower-gain pre-amp.

I've found that the 23dB gain provided by the ERA3-SM+ can be annoyingly high as a default option. I suspect that we can find something footprint compatible with lower gain/P1dB and lower current draw.

Thoughts?

dnadlinger, 2019-12-03:
As per the other issue, MAR1-SM+ is a potential pin-compatible alternative, but there are probably better options.

dnadlinger, 2019-12-03:
See https://github.com/sinara-hw/Booster/issues/335#issuecomment-561401294 for context.

hartytp, 2019-12-03:
hmm...no...I'd forgotten there's already a 9dB attenuator on Urukul. So the gain is actually more like 14dB.

An ADL5535 would probably have been a better option. We could have scrapped the 7V/7V5 rail completely and only had a 5V rail. Gain stability/tolerance looks better, power consumption is lower.

dnadlinger, 2019-12-03:
Yep, see https://github.com/sinara-hw/Booster/issues/335 :)

ADL5535 has quite a bit more current draw, but, as you point out, from 5V which we have elsewhere.

hartytp, 2019-12-03:
That's true, I'd mis-remembered the MAR1-SM+ current draw.

I think the general statement from me is that Urukul has ~10dB higher gain than I'd ideally like, even with the 9dB attenuator (which seems a little silly from a NF perspective, but I guess the DDS noise still dominates).

gkasprow, 2019-12-03:
It's not footprint compatible. What about lowering the operating current by increasing the resistor in an existing design? Gain should also drop

hartytp, 2019-12-03:
Looking again at our use-case, the ideal gain for us is somewhere between 0dB-5dB. We're currently at 14dB with the attenuator/amp combo.

So, maybe a pre-amp bypass is the best option here. Could either be a population option or just made the default. If we do scrap the pre-amp then we can move the 7V5 rail to 5V5 and gain small efficiencies elsewhere at the same time.

Anyway, just something to think about for next time we put out a release...

jordens, 2019-12-04:
Up to 10 dB less gain is ok with me. But do look at the distortion/ip3. I don't want to fight with harmonics at 0 dBm output. And would like to be able to easily reach that at all frequencies.

jordens, 2019-12-04:
But why did you design booster to have so much gain? Surely you would have designed Booster to match the Urukul output range. And you wouldn't change Urukul just because Booster has so much gain.

dnadlinger, 2019-12-04:
> And you wouldn't change Urukul just because Booster has so much gain.

Agreed on this – the beefy Urukul output is mildly convenient sometimes.

hartytp, 2019-12-04:
Nb that phaser doesn’t have the pre-amp so booster needs the gain to work with it.

hartytp, 2019-12-04:
@dnadlinger when have you found the urukul pre-amp convenient? I’ve only ever found it a bit annoying. Even with the mcl amps one ends up needing to crank the attenuators right up to cancel out the bulk of the pre-amp gain.

Maybe I’m wrong but I’d guess that the pre-amp is only useful in a minority of cases. So it doesn’t feel like it’s worth having on the main population variant as it’s a bit niche.

hartytp, 2019-12-04:
Do you really want to burn off an extra >1W and inflate the bom for something that’s sometimes mildly convenient?

jordens, 2019-12-04:
If we want decent 0dBm output power I don't see any alternative to a preamp. I'm open to a design that achieves that while giving some other advantage, e.g. using less power. But I suspect that it'll be difficult. Not needing an external attenuator is not a sufficient reason IMO.

jordens, 2019-12-04:
Maybe the smartest solution is to look at the transformer and get 3 dB or 6 dB for free out of there. Then we could skip the preamp.

jordens, 2019-12-04:
Oh. By the way. The AD9912 variant has an error. Without the split 50R before the balun, we need to use a 2:1 balun.
And we should and can do that for the AD9910 as well. Just straight into a 2:1 balun and get 3 dB.

hartytp, 2019-12-04:
> Maybe the smartest solution is to look at the transformer and get 3 dB or 6 dB for free out of there. Then we could skip the preamp.

> And we should and can do that for the AD9910 as well. Just straight into a 2:1 balun and get 3 dB. Same compliance, same current.

Good idea. That would work nicely for me. Then

> Not needing an external attenuator is not a sufficient reason IMO.

Generally, the arguments against the pre-amp are:
- noise: AFAICT we loose 9dB of NF due to the 9dB attenuator needed to reduce the pre-amp gain (i.e. from the data sheet numbers I do not believe the DDS is the limitation if operated without the PLL)
- Power consumption
- Stability: pre-amps generate heat and cause drifts/distortion
- Cost/complexity

What output power do people actually want? Is the target 0dBm?

hartytp, 2019-12-04:
> Someone up for some testing? Just bypass the preamp, put a 2:1 balun in there, remove the resistors before the balun and measure output power and ip3 at 3, 30, 300 MHz.

Yep. I'm very happy to test this. So, the proposal is to:
- bypass the pre-amp (I'll remove it and solder an 0850 0R resistor across the pads)
- remove R38 and R54
- Replace TR1B (ADT1-1WT) with a 2:1 balun. Any recommendations for part number?

Then measure what? Output power and harmonics with, say, a 100MHz carrier?

hartytp, 2019-12-04:
I won't be able to do this for a week or so (waiting for a new batch of boards), but we're not in a hurry to make this change anyway...

jordens, 2019-12-04:
Just bypass the preamp, put a 2:1 balun in there, remove the resistors before the balun and measure output power and ip3 at 3, 30, 300 MHz. Either TC2-1T (cheaper, smaller, would be usefule for the clock inputs as well) or ADT2-1T (same footprint).

jordens, 2019-12-04:
And if you are adventurous figure why the DAC34H84 can also operate with a 4:1 balun, resistors before the balun. And since they are all three nominally the same DAC specs, we could give the TC4-1T/ADT4-1T a go as well.

hartytp, 2019-12-04:
> Just bypass the preamp, put a 2:1 balun in there, remove the resistors before the balun and measure output power and ip3 at 3, 30, 300 MHz. Either TC2-1T (cheaper, smaller, would be usefule for the clock inputs as well) or ADT2-1T (same footprint).

Okay. I'll do that before Christmas.

hartytp, 2019-12-04:
> And if you are adventurous figure why the DAC34H84 can also operate with a 4:1 balun, resistors before the balun. And since they are all three nominally the same DAC specs, we could give the TC4-1T/ADT4-1T a go as well.

Not sure I'm the right person to answer that one. @gkasprow ?

dhslichter, 2019-12-05:
FWIW I would prefer that we leave the pads in place for the preamp as it currently is and have a solder-jumper option for bypass.  People who don't want a preamp can have it stuffed without those components, people who do want a preamp (this may be us in a variety of instances) can keep it.  I don't see this as something people want/need to switch on the fly.  Thoughts?

hartytp, 2019-12-31:
Closing this as, on reflection, Urukul is now mature enough that we should prioritize minimizing changes over marginal design tweaks; the current situation is fine.

Closed 2019-12-31.

Thread 40 (2019-12-04):

AD9912 resistors/balun

jordens, 2019-12-04:
The eval board uses a 2:1 balun and no resistors.
We use a 1:1 balun and no resistors. This is probably wrong.

also c.f. #39

# Context

* #43 for the original discussion

1. Measurements indicate about 2.5 dB compression (and corresponding distortion and harmonics) when scanning amplitude scale at 0 dB attenuator setting. On paper should only see 1 dB compression from the amplifier. When scanning attenuation at full scale output there

2. With -40 dBc at 12 dB attenuation and 400 MHz (AD9910) and -47 dBc at 5 dB attenuation and 80 MHz (AD9912) and we are quite a bit worse than the datasheet value (-52 dBc 400 MHz AD9910 and -70 dBc 90 MHz AD9912).

## AD9912

each output: 20 mA FS current source, 0.5 V compliance, 50 R internal termination

eval: no resistors, 2:1 trafo (high impedance 100 R secondary impedance on DAC side) into 50 R SE, consistent

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

Urukul: no resistors, 1:1 trafo into 50 R SE, inconsistent

## AD9910

each output: 20 mA FS current source, 0.5 V compliance, no internal termination

eval: 50 R each output, 1:1 trafo into 50 R SE, nominally inconsistent

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

Urukul: 50 R each output, 1:1 trafo into 50 R SE, nominally inconsistent

# On paper

[On paper](https://www.analog.com/media/en/technical-documentation/application-notes/AN_912.pdf), for a 1:1 transformer and 50 R single ended load, each DAC current output needs to be terminated with 25 R before the balun. The AD9910 eval board is incorrect on paper and the AD9912 is correct (but uses a 2:1 balun). Required changes would be:

* Urukul-AD9912: populate the one 100 R diff (or populate the two 50 R resistors)
* Urukul-AD9910: populate the one 100 R diff

This would kill about 3 dB power to the load and result in -2 dBm out of the transformer.
One could then change the 9 dB pad IC17 to 6 dB to compensate.
On the plus side this should then significantly improve THD/SFDR/OIP2/OIP3.

# Test

* AD9910: compare wideband SFDR ASF=max and 20 dB attenuation with ASF=max/2 and less attenuation to compensate
* AD9912: compare status quo with added 100 R termination and 6 dB pad instead of 9 dB: SFDR/THD/OIP2/OIP3.

dhslichter, 2019-12-04:
In my experience, both the impedances of the baluns and of the DDS/DAC outputs are not flat over the whole desired band, nor are they exactly what the nominal spec would be, and so the performance is reasonably tolerant of these kinds of substitutions.  In fact, different choices provide improved performance at different frequencies.  I'm basing this on both output power as well as on return loss measured with an NWA looking into the output of the DDS when it is powered on and running.  I think one has to actually perform a measurement to determine which configuration is better for the desired application, rather than relying on theory.

jordens, 2019-12-04:
You need to rely on a decent theoretical understanding before doing measurements. Otherwise you have no idea what to measure and how to interpret the data other than handwaving. Using the eval board design as a substitute for own optimization tends to be a really good idea. If something is already wrong on paper or compared to the eval board, it is pretty likely to be problematic in practice as well.

gkasprow, 2019-12-04:
Let's make simulations with S-models of all components before changing anything in the circuit.

dhslichter, 2019-12-04:
> You need to rely on a decent theoretical understanding before doing measurements.

Agreed.  This usually requires using measured S-parameters of components, rather than assuming ideal components, though.  One of the issues is that it is often hard to find S-parameters for things like DAC outputs that can be plugged into simulation software.

hartytp, 2019-12-31:
While there may be some room for improvement (there always is), there are now enough Urukuls out there that, on reflection, I'd prioritise minimising changes over marginal design tweaks.

Closing this now, anyone else can feel free to reopen if they want to pick it up again.

jordens, 2019-12-31:
This is not a subtle design tweak. It's a bug. It contradicts the on-paper solution. It contradicts the datasheet. It contradicts the eval board. It contradicts the nominally identical alternative variant.

hartytp, 2019-12-31:
Is it a bug that has adverse consequences for users or just an in-theory one? What are the adverse consequences?

some context here: we're planning to place another large HW order in the next few weeks and i'd like to do a little house-keeping before that by fixing known issues. So, if we are going to do anything about this then it's worth aiming to do it this month (if not then when?). So the question is whether this is serious enough that anyone is willing to put the time/energy into fixing it. Otherwise, is it worth keeping the issue over if this is really a "won't fix". Unfortunately I won't have the time/hw access to test out a new solution, so someone would else would need to lead this.

Having said that, if your suggestion is really just "follow the reference design" then I'd consider that a low-enough risk that we can probably move forward without prototyping first...

jordens, 2019-12-31:
You have so far been exclusively interested in the AD9910 variant. This bug or its fix won't affect you. The most likely fix is a simple BOM change for the AD9912 variant. Why do you feel irritated or hindered in your work or even forced to test or measure anything?
The measurements of the impact of this and the choice of solution will happen independent of what you do with your large hardware order.
And what makes you think you are in a position to set a ~6 hour deadline for me to address this? What's wrong with you?

hartytp, 2019-12-31:
> You have so far been exclusively interested in the AD9910 variant. This bug or its fix won't affect you. The most likely fix is a simple BOM change for the AD9912 variant.

Oops, sorry misread/misremembered and had thought this was AD9910. In that case it's not an issue for me as you say -- although if we are going to put out a new release it makes sense to try to fix all the issues in one go, but it's not something I feel strongly about.

> Why do you feel irritated or hindered in your work or even forced to test or measure anything?

I'm not irritated in the least. As I said, just ticking off some beginning of year housekeeping.

> And what makes you think you are in a position to set a ~6 hour deadline for me to address this? What's wrong with you?

Woah! Where are you getting that from. I said "if we are going to do something about this it's worth aiming to do it this month" how do you get from that to me setting you a 6 hour deadline?

...edit: oh, I see, it's still December by a few hours. I mean January as I'm already mentally in the New Year. If something seems that unreasonable then it's usually a mis-communication...

> The measurements of the impact of this and the choice of solution will happen independent of what you do with your large hardware order.

Sure. As I said though, where possible, it's nice to fix as many issues as possible in each design revision to avoid huge numbers of different PCB/BOM revisions. It's not a big deal though

jordens, 2019-12-31:
> Woah! Where are you getting that from. I said "if we are going to do something about this it's worth aiming to do it this month" how do you get from that to me setting you a 6 hour deadline?

This month ends in a few hours. You posit that it should be done by then and if not then you want a time table.

gkasprow, 2021-02-19:
what's the decision here?

jordens, 2021-02-19:
Speaking for the AD9912, please populate the 100 R differential R8.

jordens, 2021-02-19:
For reference some [some insight](https://ez.analog.com/dds/f/q-a/29480/ad9915-output-termination/41651#41651) into the ADI reasoning for the differences between AD991[245] w.r.t. AD9910.

gkasprow, 2021-02-19:
ACK

gkasprow, 2021-08-13:
it was fixed in v1.5.1

naja8310, 2022-12-13:
quick question here why does urukul ad9910 use balun with 75 ohm impedance isn't dac impedance of ad9910 is 50/port so why not use 100 ohm balun (1:2) ?

Closed 2021-08-13.

Thread 43 (2019-12-31):

Urkul output BALUN

jordens, 2019-12-31:
We should [probably](https://ww2.minicircuits.com/app/AN20-002.pdf) go for the standard center-tapped transformer instead of the trifilar TLT. The original design came over from Allaki which wants to go to higher frequencies. But for the usual DDS applications and frequencies the center-tapped trafo seems more suitable. It's also what's on all the eval boards.

Nominally TR1 [should be](https://github.com/m-labs/sinara/issues/199#issuecomment-304343253) a 1:sqrt(2) transformer. Does minicircuits have anything closer to that (e.g. 1:1.5)? Or is 1:2 already optimized for some reason I don't see? There is a 1:1 on the [AD9910 eval board](https://static5.arrow.com/pdfs/2009/9/10/19/9/32/656/adi_/auto/ad9910_schematics.pdf) and a 1:2 on the [AD9912 board](http://www.analog.com/media/en/evaluation-boards-kits/evaluation-board/AD9912_Schematic.pdf).

Also, the AD9912 DAC output is externally differentially terminated with 100 Ohm on the [eval board](http://www.analog.com/media/en/evaluation-boards-kits/evaluation-board/AD9912_Schematic.pdf) in front of the 1:2 transformer.

Closed 2019-12-31.

Thread 45 (2020-02-18):

v1.5

hartytp, 2020-02-18:
We're preparing to order another batch of Urukuls. There are a few minor annoyances I'd like to resolve before those go to production (e.g https://github.com/sinara-hw/Urukul/issues/42). None of them are a particularly big deal, but they feel worth fixing.

So, assuming there are no objections, I'd like to propose we cut a v1.5 release shortly. I've tagged some issues for that release. I think they're all relatively uncontroversial and can be fixed pretty quickly.

https://github.com/sinara-hw/Urukul/issues/44 and https://github.com/sinara-hw/Urukul/issues/37 are perhaps the two that need the most thought. Based on prior conversations I think the solutions can be agreed relatively quickly, but I'm also happy to leave them for a future revision if that's easiest.

I haven't tagged https://github.com/sinara-hw/Urukul/issues/40 as I'm not involved in the AD9912 version. It might make sense to fix that in this release, but I won't push for it.

Ideally, I'd like to get this release ready for manufacture in the next week (ish). Please flag if you have opinions about this and don't think that timeline is reasonable.

cc @gkasprow @jordens

jordens, 2020-02-18:
IMO #37 requires somebody trying it by modifying an existing board. Then we should apply that.

#40 can remain open until measured. It's just a BOM change. And as explained it might also affect the AD9910.

My biggest pain point currently is the short SMA mechanics. CTI uses very thin plastic washers which tend to get pushed into the hole on the panel on the inside. TS uses the bigger ones which (with the thicker shielded panels, the multiple plastic washers, the tooth washer, and assembly inconsistencies) leave too little thread sometimes. [We've notified them](https://github.com/sinara-hw/meta/issues/4) many times but there is no resolution.
Neither approach is really complete IMO. Currently AFAICT, the connectors are as close to the inside as they can be so there is no gain to be had there.
This problem is even worse on IDC-SMA and DIO-SMA (IIRC) where the connectors are not close to the panel yet.

Three more things would be interesting, sorted by priority:

* We've modified a couple boards to use the third Nyquist image. That works fine apart from the balun being out of its depth. It would be nice to have a alternative footprint for a TLT balun in that standard smaller case style.

* DNP un-uns for the outputs.

* A second DNP attenuator stage. 31.5 dB range is sometimes not enough. An example is higher multipole (clock) transitions. We currently use multiple Urukul channels to cover the required power range. Integrating it into the digital infrastructure would be some work. Just bringing it up, I'm ambivalent whether it's worth it.

hartytp, 2020-02-18:
> IMO #37 requires somebody trying it by modifying an existing board. Then we should apply that.

That's reasonable. Let's agree what a fix would look like first (@gkasprow can you sketch out the schematic including all components numbers). Assuming we can agree on a reasonable list of tests I think we should have hw and manpower to do this. I'm assuming we would do the tests open loop. So
- solder a coax probe onto the XO output
- measure the phase noise on an unmodified board
- dead bug on the control circuit
- use a suitable voltage source (e.g. stabilizer) and frequency counter to verify the tuning range/linearity
- measure the phase noise with at a few different tuning voltages

hartytp, 2020-02-18:
> #40 can remain open until measured. It's just a BOM change. And as explained it might also affect the AD9910.

Okay, I'd forgotten that it might affect the AD9910 variant as well (last I remember was "You have so far been exclusively interested in the AD9910 variant. This bug or its fix won't affect you. The most likely fix is a simple BOM change for the AD9912 variant." and, indeed, the issue title was AD9912). Am I right in thinking that the conclusion here is that (unlike the AD9910 variant) the Urukul-AD9912 schematic matches the eval board but (a) does not give the expected performance (b) does not match the intuitive model?

FWIW my personal preference is to avoid BOM changes without changing the revision number as far as possible since it can cause confusion (users see different performance from nominally identical parts). So, probably better to fix now or wait for v1.6 whenever that comes.

For the AD9910 if it's just a matter of measuring the SFDR before/after populating a 100R resistor we can do that before the next revision, but we don't have any AD9912 hw.

hartytp, 2020-02-18:
> DNP un-uns for the outputs.

Do you mean adding pads for DNPd un-uns at the ouput? Use-case is presumably breaking ground loops? Do you have an un-un pn in mind? Assuming it doesn't require major layout work that seems reasonable.

hartytp, 2020-02-18:
> A second DNP attenuator stage. 31.5 dB range is sometimes not enough. An example is higher multipole (clock) transitions. We currently use multiple Urukul channels to cover the required power range. Integrating it into the digital infrastructure would be some work. Just bringing it up, I'm ambivalent whether it's worth it.

My personal preference would be to leave this one out. I'm happy to be corrected but I feel that this could require major layout work for a relatively niche application.

jordens, 2020-02-18:
> I'd forgotten that it might affect the AD9910 variant as well

Yes. It started as a AD9912 issue and spiraled.

> Am I right in thinking that the conclusion here is that (unlike the AD9910 variant) the Urukul-AD9912 schematic matches the eval board but (a) does not give the expected performance (b) does not match the intuitive model?

Urukul-AD9912 does not match the eval board (1:1 trafo vs 1:2) while Urukul-AD9910 matches. On paper both Urukul variants and the AD9910 eval board are wrong. (I'd appreciate if someone could check this analysis, it's all in #40).

And experimentally there is 2.5 dB compression at max output. That's a bit high indicating an error in the dimensioning.

> For the AD9910 if it's just a matter of measuring the SFDR before/after populating a 100R resistor

The first step would be just doing that test described in the issues. It's non-intrusive and would tell whether there is anything to be gained.

> Do you mean adding pads for DNPd un-uns at the ouput? Use-case is presumably breaking ground loops? Do you have an un-un pn in mind?

Yes. Yes.
TC1-1(T)(X)(+). Maybe we already use one of those somewhere. All pin compatible.

hartytp, 2020-02-18:
> The first step would be just doing that test described in the issues. It's non-intrusive and would tell whether there is anything to be gained.

To be clear, you mean just this
> AD9910: compare wideband SFDR ASF=max and 20 dB attenuation with ASF=max/2 and less attenuation to compensate

at some test frequency (e.g. 100MHz) both before and after populating a 100R differential termination resistor where there is currently a DNPd 50R resistor? If so that's easy to do and we can do that for the AD9910.

> I'd appreciate if someone could check this analysis, it's all in #40

@gkasprow what do you think about this analysis?

hartytp, 2020-02-18:
@jordens I assume you're happy with the test I outlined for the phase lock?

We're up against an annoying deadline for getting this design revision sent of, so I want to make sure there is agreement on what needs to be done.

jordens, 2020-02-18:
> at some test frequency (e.g. 100MHz) both before and after populating a 100R differential termination resistor where there is currently a DNPd 50R resistor?

Measure output power of the fundamental and second, third harmonics at 100 MHz: (baseline) 20 dB attenuation, max ASF. Compare with (a) 6 dB less attenuation and half max ASF and (b) 3 dB less attenuation and 1/sqrt(2) ASF.

If trading ASF for attenuation (which would guarantee the DACs are within compliance) does not improve SFDR significantly (6 dB), then there is no point in trying to populate that 100 Ohm and the AD9910 variant is OK (IMO).

For the VCO tuning test, I'd just connect stabilizer DAC via a coax and a compact RC-RC on Urukul to the VCO and look at phase noise degradation before and after. The DDS outputs should be fine for this. If it's horrible, estimate what CMRR would be required and go another step adding a diffamp. Same as your proposal. I'd just trust the datahseet on tuning range and linearity.

jordens, 2020-02-18:
@hartytp when's the deadline and when do we send this? I need to decide whether to wait and change to v1.5 or push our v1.4 order that has already been delayed.

akaminska, 2020-02-18:
Hi! Regarding deadlines - China PCB manufacturer presently claims that they will re-open tomorrow. We have our PCB order hanging there. We can probably still modify it tomorrow, changing the project. If we put the order on hold, we might get pushed to the end of the queue. Hence, tomorrow is the decision time. Either we go ahaid with v1.4, change the project or put it on hold and risk further delays.

dtcallcock, 2020-02-18:
>A second DNP attenuator stage. 31.5 dB range is sometimes not enough. .. Just bringing it up, I'm ambivalent whether it's worth it.

@jordens I am about to design a little standalone digital step attenuator that'll be designed to plug into DIO_RJ45.  Basically a version of [MCL ZX76-31R5A-SPS+](https://www.minicircuits.com/pdfs/ZX76-31R5A-SPS+.pdf).  I'll keep you posted.

jordens, 2020-02-18:
@akaminska fully agreed. If we can't crank out a new release tomorrow, let's stick with full steam ahead v1.4 (at least for what I ordered).

jordens, 2020-02-18:
@dtcallcock Hmm. Nothing against that in principle. But thinking about wiring that up (with a power supply, your LVDS-CMOS converter, that cable which reminds me of old Nokia 6210) I get a headache. ;)
We have [Tester](https://github.com/sinara-hw/sinara/blob/master/ARTIQ_ALTIUM/EEMs/Tester/3U_TTL_Tester.PDF). You could use that straight away.

dtcallcock, 2020-02-18:
> But thinking about wiring that up (with a power supply, your LVDS-CMOS converter, that cable which reminds me of old Nokia 6210) I get a headache. ;)

I'm not talking about using that MCL board but making my own that connects directly to DIO_RJ45.  No Nokia cables needed.

jordens, 2020-02-18:
I see. Good!

hartytp, 2020-02-18:
Thanks for the input all! My position in this is:
1. We need our hw delivered by end of March for a grant deadline (frustrating but so it goes)
2. I would like to fix some annoyances before ordering our batch of hw, so would prefer to cut a release now if possible
3. @gkasprow has agreed to prepare a new release this eve which will be fine for the current production run if reviewed promptly tomorrow am
4. BOM issues (washers, baluns/ termination resistors) can be resolved after the PCBs go to production. I’d prefer to freeze the bom before boards have been shipped to customers (so when someone says “I have version x” we exactly know what they mean) but that still gives us some time
5. The only change that doesn’t seem either uncontroversial or a bom change (which we can sort out later) is the vco tune port. There’s no way we’re going to get that tested for tomorrow (would need to order parts). My feeling is that it’s worth adding dnpd parts for it in this rev. We can always tweak as needed in a future rev but it would be good to have at least something (even just an mmcx + rcfilter) in this rev

Thoughts?

jordens, 2020-02-18:
All agreed. Also MMCX+RCRC for the VCO tune port (but don't forget the added clock routing jumpers from that issue #37)

hartytp, 2020-02-18:
Any objection to adding the InAmp as well assuming: we add a 0R pad so it can easily be bypassed; it’s easy to fit it within the layout? I’d like to have it there to play with.

jordens, 2020-02-18:
If it is easy (no new power supplies, no significant layout crowing), sure.

hartytp, 2020-02-18:
👍

hartytp, 2020-02-18:
Good I think we have agreement on what we want from this release if it’s feasible within the time comstraint

akaminska, 2020-02-18:
Great, thanks for all the quick work! Now it is up to @gkasprow to see what is feasible by tomorrow and for us to check with the supplier if the changes won't affect the lead time.

gkasprow, 2020-02-19:
the new release is here
https://github.com/sinara-hw/Urukul/releases/edit/v1.5rc1

hartytp, 2020-02-19:
@gkasprow many many thanks for turning that around so quickly. A few questions about the clocking but if we have to I’d be ok pressing ahead with the design as is.

Closed 2020-02-19.

Thread 46 (2020-02-18):

Fix washer stack up

hartytp, 2020-02-18:
https://github.com/sinara-hw/meta/issues/4
https://github.com/sinara-hw/Urukul/issues/45#issuecomment-587478088

gkasprow, 2020-02-20:
what if we design and 3D print dedicated spacers that will fill the gap between the panel and the SMA? In this way, it will provide mechanical fixing to the panel without the need of using the nut.

jordens, 2020-02-21:
Yes. Just a sleeve should be fine IMO. Like one of the original white plastic washers on the inside between SMA and panel, just with a bit more depth to be flush with the outside of the panel.

gkasprow, 2020-04-30:
Here we are.
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

gkasprow, 2020-04-30:
the files are here:

[MECH.zip](https://github.com/sinara-hw/Urukul/files/4561704/MECH.zip)

gkasprow, 2021-02-19:
we use 3D washers for some time so let's close it.

Closed 2021-02-19.

Thread 47 (2020-02-18):

Consider adding TLT balun foot print

hartytp, 2020-02-18:
Optional to consider for v1.5:

> We've modified a couple boards to use the third Nyquist image. That works fine apart from the balun being out of its depth. It would be nice to have a alternative footprint for a TLT balun in that standard smaller case style.

jordens, 2020-02-18:
[TC1-1T-152X+](https://www.minicircuits.com/pdfs/TC1-1T-152X+.pdf) I think

dhslichter, 2020-02-18:
+1 to this idea in general.  @jordens is the reason for choosing this part just for pin compatibility with existing pads (i.e. no change in copper necessary)?

jordens, 2020-02-18:
It's actually different pads than the current footprint. But that case and pinout is pretty generic from what I could tell and would allow going to a cheaper/more commonly available package for the standard 1-500 MHz balun style as well.
That TLT part number is the only one that I could find that would work with the required biasing topology straight away (center tap).

dhslichter, 2020-02-18:
p.s. the existing balun ADT1-1WT+ is a 75 ohm nominal balun...given that we're playing fast and loose with nominal impedances, has anyone tried dropping in an ADTL2-18+, which is pin compatible, nominal 50 ohm impedance but 2x transform, to see if the output is reasonable?

dhslichter, 2020-02-18:
@jordens we need a center tap bias?  I guess I missed that.

dhslichter, 2020-02-18:
Or is that just for the 9912, seems that the 9910 sets its dc level using the load resistors, right?

jordens, 2020-02-18:
Both are center tap grounded on the eval boards. See #40, #39, #43 for more info and questions on that topic.

jordens, 2020-02-18:
Maybe there are other topologies that don't blow up at DC (i.e. when FTW=0) and still bias/terminate fine.

dhslichter, 2020-02-18:
> Both are center tap grounded on the eval boards.

Weird.  Anyway, I am not trying to come in and blow things up, nor is there time for discussion on this given the urgency of putting at v1.5 release out today.  I'm just a little curious/surprised at AD for the eval board choices for the reasons discussed in #40

gkasprow, 2020-02-19:
dual footprint is not that trivial here. Let's drop it for v1.5
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

jordens, 2020-02-19:
Ack

hartytp, 2020-02-19:
Does anyone want to keep this open or shall we close?

jordens, 2020-02-19:
We should keep this open.

gkasprow, 2021-02-19:
I managed to slightly recuce the original balun pad width and place the second TLT balun
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

Closed 2021-02-19.

Thread 48 (2020-02-18):

pre-amp bypass

hartytp, 2020-02-18:
Only if easy to do: add a DNPd 0R resistor pad to allow us to bypass (and DNP) the pre-amp as a population variant if desired.

gkasprow, 2020-02-18:
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

hartytp, 2020-02-19:
That resistor package very slightly decreases the gap between the input and output pins of the preamp. I assume that since it’s onlu a 3GHz gain block we’re not worried about that (the 20GHz mmics can be quite sensitive to layout).

Closed 2020-02-18.

Thread 49 (2020-02-18):

Output un-uns

hartytp, 2020-02-18:
Only if this can be done without major rework or compromises on the layout: add a footprint for DNPd un-uns (e.g. TC1-1(T)(X)(+)) on the outputs. The idea of these (please add a schematic annotation documenting this) is to provide the possibility of breaking ground loops (in that case the "grounding" capacitors should be DNPd or possibly even just removed from the design).

gkasprow, 2020-02-19:
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

hartytp, 2020-02-19:
Lgtm. Only comment is that I wonder if a bigger resistor package for the 0R would keep the gap between the input and output pins of the un un a bit wider. I don’t see this causing problems in practice however

Closed 2020-02-19.

Thread 50 (2020-02-18):

v1.5 changelog

gkasprow, 2020-02-18:
- added TVS (#36 )
- PCB cosmetics (#35)
- moved CLK connector (#38) to the rear board edge
- add fast start for IC21 LDO (#42)
- pre-amp bypass (#48)
- Output un-uns (#49)
- added VCXO tuning input (#44)
- changed HW REV to 5

Closed 2020-02-24.

Thread 51 (2020-02-19):

Support cPCIs backplane

jordens, 2020-02-19:
Place jumpers between MMCX clock in and Samtec hermaphroditic (https://github.com/sinara-hw/Phaser/issues/74#issue-527610429)

gkasprow, 2020-02-19:
Adding the Samtec connector is a lot of work. The CPLD mus be moved and re-routed. Let's leave it for the next release.
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

jordens, 2020-02-19:
Sure. Just wanted to put it on the list for the next revision.

gkasprow, 2020-02-19:
btw, this is how the CPCIS version of Urukul will look like
https://autode.sk/38NAshC

gkasprow, 2021-02-19:
We don't have many boards with these clock connectors, I decided to move it close to EEM connectors to save some space. Next Phaser/Mirny release will have it also moved closer to the edge.

Closed 2021-02-19.

Thread 52 (2020-03-21):

C155

hartytp, 2020-03-21:
@gkasprow given our experience with Fastino, do you think C155 (LT3045 output decoupling 22uF, X5R 16V, 0805) will be sufficient? That LDO needs 10uF min to ensure stability, so I wonder if this could be a bit marginal for the 7V output? My experience with other boards has been that when the capacitor is marginal some boards exhibit instability while others are fine, so it's best to err on the side of caution.

gkasprow, 2020-03-21:
LEt's simply use higher capacitance

hartytp, 2020-03-21:
Sounds good so long as we end up with >10uF after accounting for tolerance and bias.

As this is a bom change only and no new boards have been stuffed yet can we ask creotech and technoststem to make the change before shipping and also update the release?

gkasprow, 2020-04-02:
we can change to 33uF without modifyig the PCB

dtcallcock, 2020-06-19:
Can this be closed @gkasprow as it was changed in v1.5?

gkasprow, 2020-06-19:
Yes, close it

gkasprow, 2020-06-26:
In the new release, let's use 10+22uF or 33uF in bigger package. 33uF is difficult to obtain and increases the BOM count.

gkasprow, 2021-02-19:
I added another 22uF capacitor

Closed 2021-02-19.

Thread 53 (2020-11-11):

Question about current PCB stackup

HarryMakes, 2020-11-11:
I would like to obtain the following information for Urukul, similar to my post for Kasli: https://github.com/sinara-hw/Kasli/issues/86

1. Are the current Gerber files showing the correct PCB stackup? E.g. has all the impedance control been reflected by the output files?

2. NCAB provides certain guidelines for designing PCBs ([link](https://www.ncabgroup.com/pcb-design-guidelines/)). Is the current Urukul PCB design complying with their standards, if any?

gkasprow, 2020-11-11:
1. buy Altium and Hyperlynx licenses and stop asking about effects of modifications
2. If you believe you could design it better, with NCAB guidelines, do it and stop asking stupid questions. This is open hardware design, feel free to modify it and later on take responsibility for the product.
3. there are already 2 vendors of the modules and they managed to solve such issues themself. I've already put a lot of effort into RnD and don't have time for changing the design and discuss it because you don't like it.
4. if you find some merit issues to discuss, i'd happy to do it. But comments about compliance of the design with some guidlines don't add anything to the discussion. Simply - if you find some bug, open an issue and I will try to solve it. If you want to change design, do it on your own risk. Im supporting nearly 40 designs and have better things to do than discussing production issues.

gkasprow, 2020-11-11:
Creotech and Technosystem are the companies that know much more about the production of these modules. Contact them and discuss the issues. They can modify the design and run the simulations.

HarryMakes, 2020-11-13:
Greg, thank you for the comments. My questions on both here and my other post on Kasli were made to @sbourdeauducq's request in order to understand the stackup for both boards, and I have no intention to challenge any decisions you made during the design process. I was tasked to open these issues with the only goal of enquiring about impacts of modifications or adjustments proposed by the manufacturer rather than myself. I have little experience in PCB manufacturing so my questions might sound simple or even naive. But for future reference about the production cycle in general, I would like to document a summary of what I learnt from [the discussion](https://github.com/sinara-hw/Kasli/issues/86).

I learnt that it has been made clear the Gerber files residing in the repos of both Kasli and Urukul are correct and followed for production at CTI and TS such that impedance control is done properly. This should also apply to all aspects of the PCB design like choices of components parts, meaning that switching to other manufacturers means there is need to re-evaluate all effects due to differences in vendors, materials, techniques, etc.

I mistook the NCAB guidelines for PCB manufacturing "standards"; rather, they are simply a guide for PCB designers in case their Gerbers are still prone to mistakes, which of course is not useful given maturity of the projects. Besides, from our discussion it is clear that any high-quality PCB manufacturer would provide a "default" stackup with impedance profiles, which whoever is making an order should check with the schematics. In the end, it is an engineer's responsibility to verify whether or not modifications made by the manufacturer would satisfy the design requirements.

Finally, as a software developer myself I am not capable of proposing fool-proof solutions to hardware bugs or taking full responsibility into such. However, I will keep trying my best to find and document possible hardware issues in a concise manner for all Sinara boards. Again, thank you for letting me understand all kinds of considerations to make in actual production.

gkasprow, 2020-11-13:
I explained a lot more production issues in Kasli thread.

HarryMakes, 2020-11-13:
@gkasprow Yes, thank you very much for all the comments and everyone's involvement in the thread. Greg, sorry once again about my poor phrasing and misunderstanding in my questions!

Closed 2020-11-11.

Thread 54 (2020-12-25):

incorrect PCB stackup dielectric constant

sbourdeauducq, 2020-12-25:
The Dielectric3 layer constant is specified to be 4.2, which is not symmetric (the constant of Dielectric1 is 3.66). And the theoretical impedances improve when changing the constant of Dielectric3 to 3.66. Greg confirmed this is an error.

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

gkasprow, 2021-02-19:
fixed

Closed 2021-02-19.

Thread 56 (2021-02-19):

v1.5.1 changelog

gkasprow, 2021-02-19:
It's mostly cosmetic, with no changes to functionality so let's leave the same HW REV and call v1.5.1
- changed washer PN #46
- added alt TLT balun option #47
- added clock connector (DNP) #51
- added another 22uF cap #52
- J2 aligned #55
- fixed incorrect stack-up definition #54
- R8 assembled in 9912 variant

SingularitySurfer, 2021-10-04:
Hi @gkasprow, as far as I can tell the alternative footprint option from #47 is not actually in v1.5.1 and 1.5.2. I still see the old footprint. Or am I missing something?

gkasprow, 2021-10-04:
Dual footprint is present in 1.5.x
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

SingularitySurfer, 2021-10-05:
Ah, I think the problem is that the newest releases are tagged 1.5rc1 and 1.5rc2 and not 1.5.1 and 1.5.2 (which is also Production right now). In master the footprints are updated.

jordens, 2021-10-05:
@gkasprow could you tag 1.5.2 in the repository and upload corresponding PDFs and board output zips to that release?

jordens, 2021-10-06:
Thanks. No problem.

Closed 2023-06-23.

Thread 57 (2021-03-29):

DC floating section

dtcallcock, 2021-03-29:
The section between C49 and C50 has an undefined DC potential.  I always thought this was to be avoided. Though I can't find a good reference for why this is bad right now  (dC/dV of caps?, making an antenna?), so I am happy for someone to tell me it doesn't matter.  Solution would be a BOM change to make default C50 population a 0R.

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

gkasprow, 2021-03-29:
At least such configuration cannot be simulated using SPICE:)
I don't know any mechanism that caps could build-up DC voltage causing significant change to their capacitance.

dhslichter, 2021-03-31:
agreed that default BOM change to make C50 a 0R would be the way to go here.

dtcallcock, 2021-03-31:
Despite my failure to articulate much beyond 'it gives me bad feelings', I don't think there is any good reason **TO** have two caps in series like this.  But obviously can wait until BOM needs changing anyway.

gkasprow, 2021-08-13:
fixed

Closed 2021-08-13.

Thread 58 (2021-03-29):

Attenuator DC block cap

dtcallcock, 2021-03-29:
There is no DC blocking cap on input of IC3.

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

From IC3 [datasheet](https://www.analog.com/media/en/technical-documentation/data-sheets/hmc542b.pdf):

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

Was this an oversight or does the DC GND path provided by FL2+TR1 mean we don't need this (though if this is the case, you could probably make a similar argument for the output blocking cap given the next component is an attenuator that has a DC path to GND)?

gkasprow, 2021-03-29:
Good point. Some switches have an internal charge pump and can work with GND-referenced signals. In our case lack of caps can induce nonliearities.

jordens, 2021-03-29:
The jumper decouples.

dtcallcock, 2021-03-29:
Ok, now I spot the reference to 'C28' in this comment.

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

But AFAICT, C28's location or value aren't on the schematic.  Can the ambiguities of the 'mystery red box' easily be fixed?  If not then more clarity in the comment would help.

gkasprow, 2021-08-13:
I added a comment
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

gkasprow, 2021-08-13:
I also changed the frame around components so the values will be visible in pdf

Closed 2021-08-13.

Thread 59 (2021-03-31):

RF output ESD protection

dtcallcock, 2021-03-31:
We killed a switch on an Urukul.  This is the final active component in the RF chain so I'm guessing it was from ESD.

Have there been other reports?  Was adding ESD protection to the RF outputs ever discussed?

We could add RF TSVs at R4 with just a BOM change.  You can get [TSVs with like 0.04pf @250MHz](https://media.digikey.com/pdf/Data%20Sheets/Littelfuse%20PDFs/AXGD1_Series.pdf).

dhslichter, 2021-03-31:
Could you solder one on to an Urukul output and see if it changes the harmonic distortion of the output signal?  Basically a test before/after at different powers and frequencies.  These components you mentioned look like they should basically have no effect on signal integrity but would help with ESD issues.

dtcallcock, 2021-03-31:
Yes, I had it in my head that this would be much more complicated.  Am I missing something about the limitations of this kind of TSV or what's needed here @gkasprow ?

Happy to test if those 10G eye diagrams in the data sheet aren't convincing!

dhslichter, 2021-04-01:
I mean, it looks like it's exactly what one wants, but it would make sense to buy a few and take 20 minutes to solder one on and sanity check that nothing goes haywire before putting it on the BOM.  Also be useful to know whether they do the job of protecting the switch.  This could be validated with a few switch eval boards, a grad student with slippers and shag carpeting, and a couple of these TSVs 😁

gkasprow, 2021-08-13:
I added [TVS](https://wwanw.eaton.com/content/dam/eaton/products/electronic-components/resources/data-sheet/eaton-0402esda-mlp-esd-suppressor-data-sheet.pdf)
If we notice issues with production tests, they will be removed

Closed 2021-08-13.

Thread 60 (2021-04-27):

IC22 voltage

gkasprow, 2021-04-27:
I've just noticed that IC22 has a "0.8V" annotation close to the FB input.
In fact, it should be 0.7V. The TPS62148 is able to deliver output from 0.8V but the nominal FB voltage is 0.7V
With current resistors, it produces 6.5 instead of 7.5V which makes the 7V LDO out of regulation.
Can somebody who has Urukul measure the voltage on C211?
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

jordens, 2021-04-27:
Isn't this https://github.com/sinara-hw/Urukul/issues/20 ?

atcher0, 2021-08-09:
Voltage measured on C211: 6.58 V (I checked on two different Urukul AD9910 v1.5.1 boards). It produces about 6.33 V from the IC21 LDO.

gkasprow, 2021-08-13:
R134=75k
R136=7k5

gkasprow, 2021-08-13:
fixed in v1.5.2

dnadlinger, 2021-08-13:
What's the practical consequence of this being left unpatched? Worse output power stability?

Closed 2021-08-13.

Thread 62 (2021-10-18):

`xc2c256.map` for flashing urukul rev 1.4

lriesebos, 2021-10-18:
When flashing an urukul rev 1.4 (without xilinx installed) I get an error message that I need the file `xc2c256.map` instead of the provided `xc2c128.map` available on the wiki. see the message below. Where can I find this file, or am I doing something else wrong? @gkasprow @jbqubit

```
leon@tokachi:~/urukul$ xc3sprog -c jtaghs2 -m map -v urukul.jed:w
XC3SPROG (c) 2004-2011 xc3sprog project $Rev$ OS: Linux
Free software: If you contribute nothing, expect nothing!
Feedback on success/failure/enhancement requests:
	http://sourceforge.net/mail/?group_id=170565
Check Sourceforge for updates:
	http://sourceforge.net/projects/xc3sprog/develop

Using built-in device list
Using built-in cable list
Cable jtaghs2 type ftdi VID 0x0403 PID 0x6014 Desc "Digilent USB Device" dbus data e8 enable eb cbus data 00 data 60
Using Libftdi, Using JTAG frequency   6.000 MHz from undivided clock
JTAG chainpos: 0 Device IDCODE = 0x16d4e093	Desc: XC2C256_FT256
Mapfile map/xc2c256.map not found: No such file or directory
No mapfile available -- only bitfile (not JEDEC) operations will be supported.
Reading style BIT
Ignoring unknown field '1'
Ignoring unknown field '1'
Ignoring unknown field '1'
Ignoring unknown field '1'
Ignoring unknown field '7'
Ignoring unknown field '1'
Ignoring unknown field '1'
Ignoring unknown field '9'
Ignoring unknown field '1'
Ignoring unknown field '1'
Ignoring unknown field '
'
Unknown error
Probably no Bitfile, aborting
USB transactions: Write 6 read 3 retries 3
```

OS: Ubuntu 20.04 (xc3sprog installed from Ubuntu repositories)

jordens, 2021-10-21:
Are you allowed to redistribute that file?

lriesebos, 2021-11-07:
closed by 945f099

Closed 2021-11-07.

Thread 64 (2021-11-30):

significant harmonic content observed from emitted signal (AD9910)

collineps, 2021-11-30:
We are observing significant harmonic distortion in signals emitted from our Urukul/AD9910 board.
The distortion can be up to -20 dB relative to the fundamental frequency, which is unacceptable for my lab's applications.
The distortion occurs on every port, for a wide range of frequencies, and is not adequately suppressed by:
* Attenuation through external hardware
* Attenuation through ARTIQ software commands (with the exception of extremely high attenuation)
* Modification of the AD9910 chip auxiliary DAC register value
* Modification of the AD9910 chip amplitude scale factor register value

Our system is clocked by a Kasli card as part of an integrated system delivered by a vendor, and our measurements are performed with multiple signal analyzers that terminate with a 50 ohm load.

Please see the plot below for an example of the harmonic content we are observing:
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

I have several questions concerning this distortion:
* Does the Urukul have a formal specification for the expected harmonic content? For example, the AD9910 specifies very low harmonic distortion around 200 MHz
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:
* Is this issue with the Urukul boards known? Is it replicable?
* Is it possible to obtain a cleaner signal from the Urukul? If so, how?

We believe the harmonic content indicates that a component in the board is being saturated.
Our experiments show non-linear (but inadequate) suppression of the harmonic peaks using 'software' attenuation and auxiliary DAC register values, suggesting that the saturated component is downstream of both components.
From our initial investigation, it looks like the ERA-3SM+ amplifier at the end of the circuit may be being saturated.
Our calculation of the expected signal power at that amplifier is about an order of magnitude greater than the expected value indicated by a note in the Urukul drawings:

> With about 1dBm out of the DDS, 0.5 dB insertion loss from the Balun, 0.5 dB from the lowpass, 1.5 dB from the attenuator, we need a 9dB T-pad to attenuate that before the ERA-3+ with 23 dB gain and P1dB of 13 dBm at our frequencies.

The difference is due to an order of magnitude greater power being emitted from the DDS chip, which agrees with our measurement of the signal power.
Additionally, the greater signal power we believe that the amplifier is experiencing does agree with the saturated power range listed in the ERA-3SM+ amplifier specifications.

I appreciate any insight you have into this problem!
Thank you!

gkasprow, 2021-11-30:
Urukul was designed for aplications that do not require low harmonic content. It seems you are the first person who needs better performance.
However, it is possible to lower the THD by removing the amplifier. The PCB has such assembly option - remove the amplifier, inductor and install 0603 0R resistor instead.
Than use external low THD amplifier such as i.e. Booster_HL. [It's a Booster version with high linearity power stage](https://github.com/sinara-hw/Booster/issues/385).
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

gkasprow, 2021-11-30:
If there is sufficient interest, we can make a low THD version of Urukul.

jordens, 2021-11-30:
The harmonics [were](https://github.com/sinara-hw/sinara/issues/354#issuecomment-352859041) and are well known. The system was designed like this and is behaving accordingly. To get low harmonics, go to low powers, remove the amplifier and potentially the other components (balun, switch, attenuator, pad) in the chain, lower the DAC bias, and also just filter the output.
If you need an ultra-linear medium-power agile RF source, then the design would look different.
I'm also unsure your understanding of P1dB and the overall ERA datasheet is correct.

collineps, 2021-12-03:
I understand, thank you for your quick and detailed responses. We will try the suggestion of bypassing the board amplifier and take another look at our system design.

Thread 68 (2022-05-25):

1GHz crosstalk

sbourdeauducq, 2022-05-25:
Reported by Andrew Van Horn at Duke:
"A few months ago, we observed a 1GHz crosstalk on all four output channels of the Urukul 9910 v1.5 and 9912 v1.3 when a 1GHz external clock was connected. This crosstalk occurs independent of the clock source and clock reference connection (SMA or MMCX).

I have attached four scope captures which show the presence of this crosstalk on the Urukul 9910 v1.5 and 9912 v1.3 when using the internal clock reference. The crosstalk is also present when using the 1GHz as the reference.

We observed the 1GHz reference resulted in lower overall phase noise as expected, so in our systems we plan to use the 1GHz clock reference with a 400MHz LPF on the output of the Urukul to mitigate the effects of this crosstalk. "

Urukul-9912_v1 5 100MHz Output Int Clock, 1GHz clock disconnected
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

Urukul-9912_v1 5 100MHz Output Int Clock, 1GHz clock connected
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

Urukul-9910_v1 3 100MHz Output Int Clock, 1GHz clock disconnected
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

Urukul-9910_v1 3 100MHz Output Int Clock, 1GHz clock connected
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

sbourdeauducq, 2022-05-25:
Urukul_v1 5_9910 400MHz_Output With_Filter
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

Urukul_v1 5_9910 400MHz_Output No_Filter
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

Urukul_v1 5_9910 200MHz_Output With_Filter
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

Urukul_v1 5_9910 200MHz_Output No_Filter
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

Urukul_v1 5_9910 100MHz_Output With_Filter
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

Urukul_v1 5_9910 100MHz_Output No_Filter
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

jordens, 2022-05-25:
Check whether the clock in sma connector and the RF out sma connectors are well clear of the panel everywhere. Also their shields. That's where it typically couples.

sbourdeauducq, 2022-06-01:
"I am quite confident that is not the major source of the issue we are seeing.

First, the cables were kept as far apart from each other and from the front panel as the geometry of the front panel would allow.
Second, by configuring the Urukul to use the internal clock source and monitoring the output with a spectrum analyzer, the 1GHz noise only appears when the 1GHz clock is connected to the clock SMA. While I am screwing in the 1GHz SMA, the noise abruptly appears when the signal pin makes contact. "

jordens, 2022-06-01:
The panel and the connectors in that panel. Nothing to do with the cables. It's a manufacturing problem. Has been pointed out numerous times.
Feels awkward to help in this way.

andrewvh4, 2022-06-01:
@jordens Is this manufacturing problem fixed in the next revision of the Urukul? And is there any way to modify current revisions to prevent this noise?

jordens, 2022-06-02:
Afaik no. But I don't know what the next revision is.

See the advice in my initial comment above.

If you don't find it here or on phaser in the meantime I'll try searching it for you next week.

andrewvh4, 2022-06-07:
I modified the Urukul by removing the front panel altogether to eliminate any coupling through the front panel. This eliminated the 1GHz crosstalk.

Internal 125MHz clock, 200MHz output, no front panel
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

External 1GHz clock, 200MHz output, no front panel
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

gkasprow, 2022-09-17:
Do you mean electrical connection of the SMAs and the panel? We use 3D printed distances to make sure isolation is there.

gkasprow, 2023-05-23:
We confirmed the results. The issue is caused by impedance of optional AC-coupling (isolation) RCs. After we shorted SMA connector to nearby GND with thick wire, the crosstal got reduced by a few dB
In the next revision I will short SMA to GND using 4 thick traces. AC-coupling would require cutting the trace.

gkasprow, 2023-06-21:
fixed in v1.5.5

marmeladapk, 2023-06-23:
@gkasprow Isolation of SMAs also requires removal of resistors on top layer. I think that description on bottom overlay should reflect this.

gkasprow, 2023-06-23:
done

Closed 2023-09-07.

Thread 70 (2022-09-02):

v1.5.4 changelog

filipswit, 2022-09-02:
- Added footprint for 24AA02E48T-I/SN #67
- Added alternate regulator for TPS62148RGX

gkasprow, 2022-09-02:
looks good.

AireIntire, 2023-01-18:
Are these the only changes in 1.5.4 from 1.5.3? Thank you~

Closed 2023-06-23.

Thread 72 (2023-03-27):

Urukul layout

maciejprzybysz, 2023-03-27:
We made some investigation on Urukul v1.5.3 and found some issues on layout and signal integrity.

1. DDS0_SYNC_IN/OUT signals (layer L3) have poor reference on L2 layer.

   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

2. Also other DDSx_SYNC_x signals have problem with reference, due to specifics of stackup. In general L2 should be reference for L1(TOP) and L3 signal layers, P5 should be reference for L4 and L6(BOT). In fact dielectric thickness between L3 and L4 is much lower than between L2/L3 or L4/L5, so there is strong coupling between 2 center layers.

   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

   DDSx_SYNC_x signals on layer L4 on the background of layer L3 looks like this:
   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

   This could cause step changes in impedance and signal integrity problems.
<br>

3. ORIGIN. This issues affect Urukul v1.4 and later.

   Till v1.3 L2 was mostly GND split plane, there wasn't any signals there, so DDS0_SYNC_IN/OUT had good reference.
   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

   In addition, there was no GND plane on L3 and L4 layers, so the only reference for DDSx_SYNC_x signals was on L2 or L5 layer.
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

gkasprow, 2023-03-27:
that's strange. Usually when designing 6 layer boards I treat them as two 3-layer boards having L3-L4 separation dominating so L3 and L4 impedances are defined by thin dielectric to L2 and L5.
These issues can be easily fixed by changing stackup and re-routing these two lines which don't have valid reference on L2.
I don't think however that this is the main issue why we don't have synchronization.  in v1.4 we swtiched to another CPLD in bigger package

gkasprow, 2023-06-21:
fixed in v1.5.5

marmeladapk, 2023-06-23:
Mostly fixed, remaining problems are in a separate issues.

Closed 2023-06-23.

Thread 73 (2023-06-20):

Problems with channel 0 synchronization

marmeladapk, 2023-06-20:
6 attenuator SPI lines run under PLL filter of AD9910 in channel 0:

- ATT_S_OUT0
- ATT_S_IN1
- ATT_S_OUT1
- ATT_S_OUT2
- ATT_LE2
- ATT_S_IN2

These lines seem to have a significant enough effect on PLL filter that it causes SMP ERR to appear and sometimes even phase glitches in output signal (caused by ATT_S_IN2).

To fix this,
- these lines must be rerouted away from loop filter and P1V8_CLK_VDDA (maybe even away from DDS0 if it's possible)
- stackup issues must be fixed (https://github.com/sinara-hw/Urukul/issues/72)
- as well as these signals should have a proper continuous reference plane.

More info can be found in https://github.com/m-labs/artiq/issues/1692.

gkasprow, 2023-06-21:
fixed in v1.5.5

marmeladapk, 2023-06-23:
I'd say that these lines should be rerouted away from P1V8_CLK_VDDA under AD9912 as well.
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

Is it possible or worth it to fight for continuous reference plane for these signals?

gkasprow, 2023-06-23:
I think we can do it

gkasprow, 2023-06-23:
I did what I could

dnadlinger, 2023-06-25:
Given that the PLL nodes are apparently more susceptible than anticipated, I suppose it might be interesting to see whether togglign all the potential agressor lines as aggressively as possible leads to phase noise on the output.

Closed 2023-06-26.

Thread 74 (2023-06-23):

Add vias for reference layer change

marmeladapk, 2023-06-23:
- [x] DDS0_SYNC_{IN,OUT}:
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

- [x] DDS1_SYNC_IN:
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

- [x] DDS2_SYNC_IN:
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

- [x] DDS3_SYNC_IN:
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

- [x] CK_OSC:
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

- [x] CK_MMCX
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

- [x] DDS_CLKA, DDS_CLKB, DDS_CLKB0:
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

gkasprow, 2023-06-23:
I added GND vias where I could fit them

Closed 2023-06-26.

Thread 80 (2023-07-13):

v1.5.6 changelog

maciejprzybysz, 2023-07-13:
- Impedance profile added
- Additional directives for 50ohm lines added
- Trace width unified for impedance control
- P_version project parameter added, rev on schematic table filled with version number
- PCB/Urukul.PCBDwf file with stackup and impedance table added
- Impedance table added on PCB Mechanical 1 layer
- Minor cosmetic changes on SCH

dnadlinger, 2023-07-14:
Wait, https://github.com/sinara-hw/Urukul/issues/74 is not fixed in 1.5.6?

maciejprzybysz, 2023-07-14:
It was fixed in v1.5.5, I just added Impedance control in new version.

maciejprzybysz, 2023-07-14:
v1.5.5 changelog is missing, @marmeladapk could you make issue with v1.5.5 changes to have history tracking? IDK if this is the best place, but it's much better than commit message.

Thread 82 (2024-05-23):

CPLD XC2C256-6FTG256C is EOL

MorganTL, 2024-05-23:

gkasprow, 2024-05-23:
any suggestion what family we could use here?

Spaqin, 2024-05-24:
Mirny uses the same CPLD.

A suggestion would be to use Artix-7, like XC7A35TICSG324 or XC7A100TCSG324, depending if 35k logic cells would be fine or we need 100k.

gkasprow, 2024-05-24:
Artix is FPGA, which means it has much higher internal delays and is suitable for synchronous designs. CPLD was placed here as a simple asynchronous glue logic. Such a big FPGA would significantly increase the board cost because we also need extra power rails.

gkasprow, 2024-05-24:
Since AMD and Lattice do not make any CPLDs anymore, we can move to Cypres or Altera:
[5M2210ZF256I5N](https://www.digikey.pl/pl/products/detail/intel/5M2210ZF256I5N/2660801)
[EPM570F256C4N](https://www.digikey.pl/pl/products/detail/intel/EPM570F256C4N/705413)
[CY37256VP256-100BGC](https://www.digikey.pl/pl/products/detail/rochester-electronics-llc/CY37256VP256-100BGC/11512522)

@jordens Maybe the ICE40 family could be fine here?

jordens, 2024-05-24:
That would be interesting to explore.

kaolpr, 2024-06-06:
If there are no pending ideas on implementing some more elaborate logic we could go with iCE40 HX8K as in Fastino. This would let us drop LVDS transceivers too (same for Mirny).

dnadlinger, 2024-06-06:
The biggest (in relative terms) design we currently need is the status readback for SUServo mode: https://github.com/quartiq/urukul/pull/11. For this, we ran into size limits of the parts that were on older revisions, though there is some discussion on how to best implement this in a glitch-free way still unresolved (see linked PR).

jordens, 2024-08-14:
Is anybody working on this? I have no idea about stock situation at cti/ts. Given the revision/production/development/testing lead time this may be something that should have been started a while ago.

gkasprow, 2024-08-14:
Yes. I expect to have Mirny and Urukul designs done in 2 months. Two guys are working on these designs.

gkasprow, 2024-08-14:
CTI secured stocks for next year

jordens, 2024-08-14:
Who is doing the gateware redesign? That should be done first to verify/decide the choice of chip (did you choose already?).

gkasprow, 2024-08-14:
we will go for same chip as in Fastino

pkozakiewicz, 2024-08-19:
> I have no idea about stock situation at cti/ts.

We are well stocked with CPLDs and finished devices so this situation does not threaten availability.

Thread 83 (2024-08-31):

DIOT version

gkasprow, 2024-08-31:
A new DIOT/EEM version is on the way:
- take the existing design and replace CPLD with ICE40 - circuit and EEM connectivity copied from Fastino-DIOT (with proper power sequencing)
- get rid of LVDS translators
- move power supplies away from DDS chips, we have a lot of board area
- make sure all points are checked: https://github.com/sinara-hw/DIOT-Template/issues/1

newell, 2024-12-29:
I noticed on the new Urukul board that there is a 25 MHz clock (CLK_25MHz in the schematic) tied to pin K9, which for the part is of type GBIN.  Is this going to be the FGPA's dedicated clock?

gkasprow, 2024-12-29:
There are more issues - the DIOT clock is not routed to the clock distribution IC.
The 25MHz clock is just copied from Fastino design; we would prefer to get 100MHz DRTIO clock from the backplane

Thread 85 (2024-12-20):

The board picks up smartphone communication signals

jzli559, 2024-12-20:
I observed that the Urukul board can pick up signals from smartphone communications. Using an oscilloscope, I probed the signal from the SMA connector on the front panel of the board. Throughout the process, I didn't set any output of the board. When I made a voice or video call on a smartphone and brought the phone close to the SMA connector, I observed high-frequency (over 1 GHz) signals on the oscilloscope. After turning off the call, the signal returned near zero.

I did the test under different configurations, and the results were similar.
- Urukul installed in a crate: connected to a Kasli that is powered and grounded.
- Urukul installed in a crate: connected to a Kasli that is not powered but the crate is grounded.
- Urukul installed in a crate: connected to a Kasli, not powered and not grounded.
- Urukul isolated: not connected, not powered, and not grounded.

I did further tests with a spectrum analyzer (FSV3030), and the results are as follows:

| 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 | 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 |
| In crate, grounded, not powered; no phone | In crate, grounded, not powered; with phone (5 cm distance) |
| 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 | 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 |
| In crate, not grounded, not powered; no phone | In crate, not grounded, not powered; with phone (5 cm distance) |

After the tests above, I additionally tested the noise by setting the channel to output a signal (100 MHz, 0 dB att, 1.0 amp).

| 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 | 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 |
| 100 MHz, 0 dB att, 1.0 amp, no phone | 100 MHz, 0 dB att, 1.0 amp, with phone (5 cm distance) |

For simplicity, all six images above were tested on channel 0. The only related configurations are the ground and the phone. The results of others are similar. Some of the noise peaks were related to the ground, but M4 and M8 were clearly related to the phone. until the distance was increased to about 3 m.

This looks like the board doesn't specifically handle noise over 1 GHz, and the wavelengths of some of the phone signals are similar to the length of some wires on the board.

Similar phenomena were observed when testing other cards in the same crate, including the Kasli J3, Clocker Output 9, and all channels of the DIO-BNC card. Other interfaces haven't been tested yet.

gkasprow, 2024-12-20:
pls do the following test:
- use the same RF cable.
- place 50Ohm termination and then short SMA nut with unpowered, grounded crate. Beware of alu oxidation layer - make sure you attach the SMA terminator to some steel screw/
- measure the spectrum with the phone as above
- do not place 50Ohm termination and then short SMA nut with unpowered, grounded crate
- measure spectrum with the phone as above

jzli559, 2024-12-21:
Before anything else, I need to correct the test results I posted earlier. Both the first and second images were powered and grounded, with no DDS outputs set.

Based on your suggestion, I did some new tests. First, the spectrum analyzer (SA) requires grounded during using, and it shares the same ground with the crate. Therefore, the SMA nut of the RF cable is inherently grounded with the crate without being shorted again. I'm not sure if connecting the RF cable from the SA to the Urukul's SMA would create a ground loop.

Below are the new test results.

(Remeasured) In crate, grounded, not powered; no phone:
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

(Remeasured) In crate, grounded, not powered; with phone (5 cm distance):
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

All the following tests are also within crate, grounded, not powered.

Urukul ch0 connected to a 50 Ohm terminator; SA probe connected to noting or a 50 Ohm; phone close to ch0:
almost no signal.

Urukul ch0 connected to nothing; SA probe connected to noting or a 50 Ohm; phone close to ch0:
almost no signal.

Urukul ch0 connected to nothing or a 50 Ohm; SA probe connected to noting; phone close to SA probe:
almost no signal.

Urukul ch0 connected to nothing; SA probe connected to a 50 Ohm; phone close to SA probe:
(Urukul ch0 connected to a 50 Ohm was similar)
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

The last image also showed some clear noise signals but not as big as connected to ch0.

gkasprow, 2024-12-21:
Is the front panel grounded?

jzli559, 2024-12-21:
> Is the front panel grounded?

Yes. The card is installed in the crate. I measured with a multimeter and found that the outer shell of the SMA connector on the front panel is electrically connected to the crate.

gkasprow, 2024-12-21:
That's not enough. You checked DC path but we are interested in AC path. Just check if the grounding resistors are soldered.

jzli559, 2024-12-22:
Do you mean using the multimeter to test resistors R179 ~ R182?

gkasprow, 2024-12-22:
There are 2 resistors amd 2 capacitors that comnect panel with PCB ground

Thread 86 (2025-04-25):

Urukul DIOT: FPGA CRESET is held down on power up, preventing the FPGA from booting

Spaqin, 2025-04-25:
I was having a difficult time flashing/running the bitstream - tried with FTDI for SPI and with kasli-i2c, and it took me a while to figure out why.

Verified with a logic analyzer that FPGA CRESET is held down after initial power up:

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

I noticed that flashing with ``iceprog`` and FT232H may seem to fail (no readback), but it did work, as with kasli-i2c I could toggle the FLASH_UP_EN pin and then the bitstream that I had flashed earlier would be finally loaded.

Traced it on the board. The board I have next to me uses SC18IS606PWJ rather than SC18IS602B (like Fastino would).

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

It does make sense that FLASH_UP_EN would be the opposite of CRESET, but there's one problem with it. The I2C-SPI bridge assumes the output pins are used as SS unless configured otherwise, and as such they're all held high by default.

PGOOD is also at 0.0V on boot even it should be high because of that and the PWR GOOD LED will only light up after I switch off FLASH_UP_EN on the I2C-SPI bridge.

gkasprow, 2025-04-25:
It might be the same issue as in Fastino

gkasprow, 2025-04-25:
https://github.com/sinara-hw/Fastino/issues/128

gkasprow, 2025-04-25:
my coleague fixed that by adding one more MOSFET

Spaqin, 2025-04-25:
Yep, seems to be the same problem.

gkasprow, 2025-04-25:
later on I will post fix, ping me in 3 hours :)
