sinara-hw/Urukul/(list of files, drawings)

Other design files:
Panel_9910/Panel_Urukul_9910.PcbDoc
Panel_9912/Panel_Urukul_9912.PcbDoc
PCB/CLK_INPUT.SchDoc
PCB/CTRL_LOGIC.SchDoc
PCB/DDS_channel.SchDoc
PCB/DDS_OUT_channel.SchDoc
PCB/LVDS_IFC_DDS.SchDoc
PCB/Supply_DDS.SchDoc
PCB/Urukul.PrjPCB
PCB/Urukul.schdoc
