sinara-hw/Urukul/(commit log)

2018-06-08 removed AD9914 variant
    [Urukul.PrjPCB]
2018-06-15 fixed #4
    [Urukul.PrjPCB]
2018-08-06 v1.3 added clock mux
    [CLK_INPUT.SchDoc, CTRL_LOGIC.SchDoc, DDS_OUT_channel.SchDoc, Supply_DDS.SchDoc, Urukul.PrjPCB, Urukul.schdoc]
2019-08-29 power budget update
    [Supply_DDS.SchDoc]
2019-09-27 Change 'v1.3' to 'v1.4' on bottom overlay, added missing layer to gerber generation
2020-02-19 updated sch version number
    [CLK_INPUT.SchDoc, CTRL_LOGIC.SchDoc, DDS_OUT_channel.SchDoc, DDS_channel.SchDoc, LVDS_IFC_DDS.SchDoc, Supply_DDS.SchDoc, Urukul.PrjPCB, Urukul.schdoc]
2021-06-28 fixed BOM issue
    [DDS_OUT_channel.SchDoc, Urukul.PrjPCB]
2021-08-13 v1.5.2 rc1
    [CLK_INPUT.SchDoc, CTRL_LOGIC.SchDoc, DDS_OUT_channel.SchDoc, DDS_channel.SchDoc, LVDS_IFC_DDS.SchDoc, Panel_Urukul_9910.PcbDoc, Panel_Urukul_9912.PcbDoc, Supply_DDS.SchDoc]
2022-01-10 v1.5.3 SMA changed to DELOCK_65848, added R193
    [DDS_channel.SchDoc, Panel_Urukul_9910.PcbDoc, Panel_Urukul_9912.PcbDoc, Supply_DDS.SchDoc, Urukul.PrjPCB, Urukul.schdoc]
2022-01-10 changed revision on front panels
    [Panel_Urukul_9910.PcbDoc, Panel_Urukul_9912.PcbDoc, Urukul.PrjPCB]
2023-06-21 v1.5.5 rc1
    [Urukul.PrjPCB, Urukul.schdoc]
2023-06-23 v1.5.5 rc2
    [Panel_Urukul_9910.PcbDoc, Panel_Urukul_9912.PcbDoc, Urukul.PrjPCB]
2023-06-28 v1.5.5rc5 - added no-erc markers to unconnected signals - updated copyright year - removed broken xsignals - updated polygon priority - moved rfsw signals to schematic constraints - cleaned up xsigna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
    [CLK_INPUT.SchDoc, CTRL_LOGIC.SchDoc, DDS_OUT_channel.SchDoc, DDS_channel.SchDoc, LVDS_IFC_DDS.SchDoc, Supply_DDS.SchDoc, Urukul.PrjPCB, Urukul.schdoc]
2023-07-03 Removed part of polygon that could act as an antenna. Cosmetic changes on schematics.
2023-07-13 v1.5.6 - Impedance profile added - Additional directives for 50ohm lines added - Trace width unified for impedance control - P_version project parameter added, rev on schematic table filled with vers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
    [CLK_INPUT.SchDoc, CTRL_LOGIC.SchDoc, DDS_OUT_channel.SchDoc, DDS_channel.SchDoc, LVDS_IFC_DDS.SchDoc, Supply_DDS.SchDoc, Urukul.PrjPCB, Urukul.schdoc]
2023-07-17 v1.5.6rc2 - Board outline clerance rules added - Version number on panel files changed to v1.5.6
    [Panel_Urukul_9910.PcbDoc, Panel_Urukul_9912.PcbDoc, Urukul.PrjPCB]
